OriDagan1/RISCV-MCU-Final-Project/DOC/Screenshots/GPIO test1 counting up.png

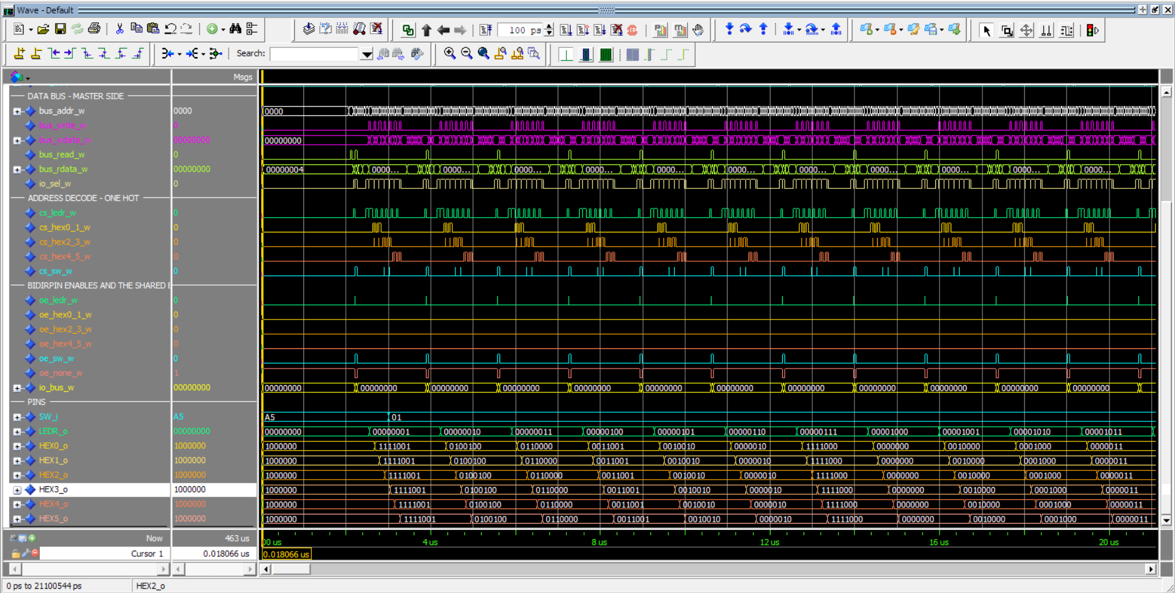
DOC/Screenshots/GPIO test1 counting up.png
