OriDagan1/RISCV-MCU-Final-Project/DOC/Screenshots/GPIO test1 counting down.png

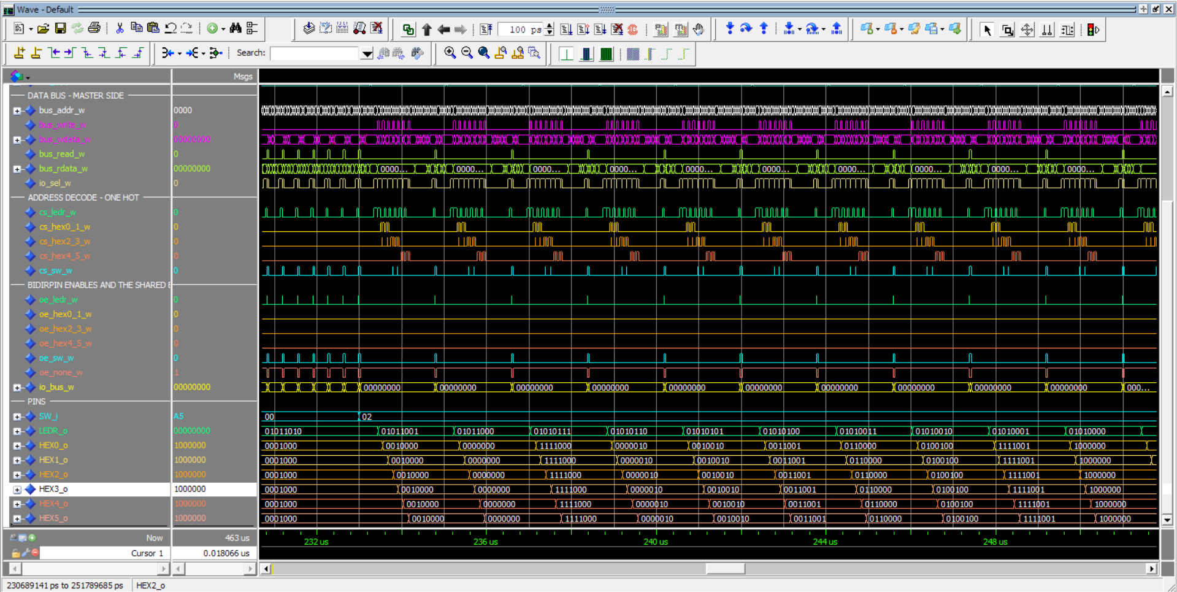
DOC/Screenshots/GPIO test1 counting down.png
