OriDagan1/RISCV-MCU-Final-Project/DOC/pre_final.docx

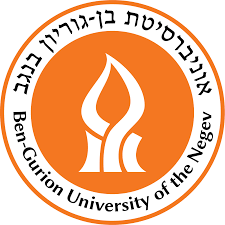
[picture p3: figure]

דו"ח מכין למעבדה מסכמת

מחלקה

המחלקה להנדסת חשמל ומחשבים

שם קורס

מעבדת ארכיטקטורת מעבדים מתקדמת ומאיצי חומרה

361.1.4693

תאריך הגשת הדוח

.08.202631

מגישים-

מאי ג'קסון 212294987

אורי דגן 207698788

תוכן עניינים:

1. מבוא .......................................................................... 3
2. ארכיטקטורת מערכת .................................................... 3
3. התקני קלט/פלט וממשק פריפריאלי ממופה זיכרון .............. 4
4. מאיץ החילוק/שארית וארכיטקטורת מעבר תחומי שעון ....... 7
5. פרוטוקול Interrupt Sequencer ................................... 7
6. סינתזה על גבי FPGA ואפיוןPPA ................................ 7
1. מבוא:

מטרת הפרויקט היא תכנון ומימוש של מערכת MCU המבוססת על מעבד RV32IM על גבי FPGA. המערכת מבוססת על ליבת Single-Cycle בארכיטקטורת Harvard עם זיכרונות נפרדים מסוג ITCM לקוד ו-DTCM לנתונים. במסגרת הפרויקט הורחבה הליבה באמצעות Memory-Mapped I/O, רכיבי GPIO, Basic Timer, בקר פסיקות ומאיץ חומרה רב־מחזורי לביצוע פעולת חילוק. בסיום המימוש בוצעו אימות בסימולציה, בדיקה על גבי ה-FPGA וניתוחי Power, Performance and Area (PPA) באמצעות Quartus.

2. ארכיטקטורת מערכת:

ה-MCU בנוי סביב ליבת RISC-V בעלת מחזור בודד (single-cycle), המחוברת לקבוצת רכיבים פריפריאליים הממופים לזיכרון (memory-mapped) דרך בס משותף פנימי, כפי שמוצג באיור 1. כתובות שהליבה מוציאה מנותבות, דרך לוגיקת ממשק הבס, אם פנימה אל זיכרונות הליבה (ITCM ו-DTCM), ואם מחוץ לטווחם - החוצה אל אחד הרכיבים הפריפריאליים, כל אחד עם ה-Address Decoder ורגיסטרי הממשק שלו. מאיץ חומרה (Accelerator) מחובר ישירות צמוד לליבה ולא דרך הבס הפריפריאלי, שכן הוא מיועד למשימה חישובית ספציפית ומוגדרת מראש. מבנה השעונים נגזר משעון לוח יחיד בתדר 50MHz על ידי Clock Tree, המפיק שלושה תחומי שעון בלתי תלויים: mclk לליבה, smclk לטיימר, ו-acceclk המהיר למאיץ, כאשר אות איפוס rst מופץ לכל התחומים.

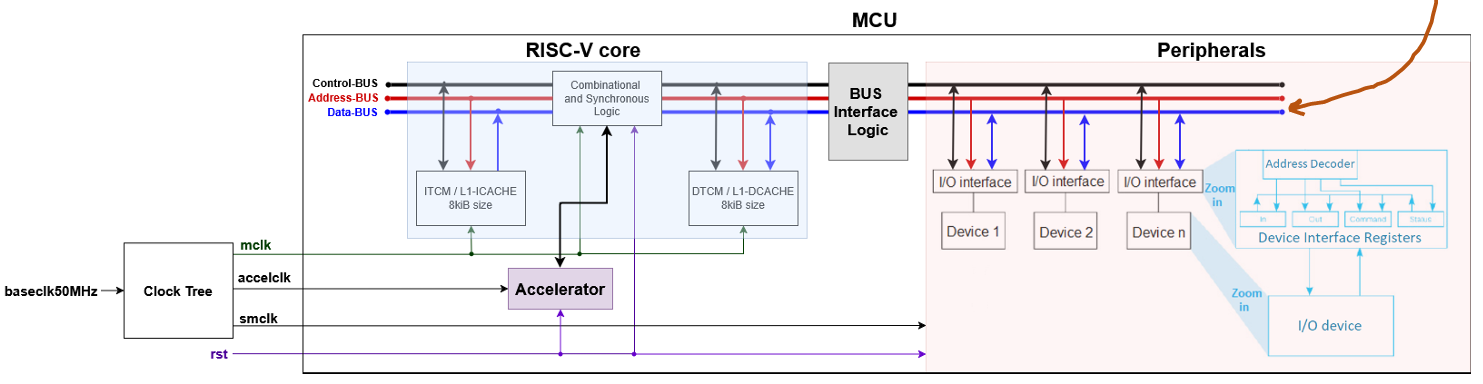
[picture p4: figure]

Figure 1

איור 2 מציג את המבנה הפנימי של הליבה. בהתאם לארכיטקטורת הרווארד, הליבה מחוברת לשני זיכרונות נפרדים: ITCM לסגמנט הקוד ו-DTCM לסגמנט הנתונים. ה-PC מספק את כתובת השליפה ל-ITCM, והפקודה שנשלפת מפוענחת על ידי ה-Control Unit, המפעיל את ה-Register File, ה-ALU ולוגיקת ה-sign extension לביצועה. התקשורת עם ה-DTCM ועם הבס הפריפריאלי מתבצעת דרך שלושה תתי-בסים שהליבה מניעה כ-bus master: בקרה, כתובת ונתונים.

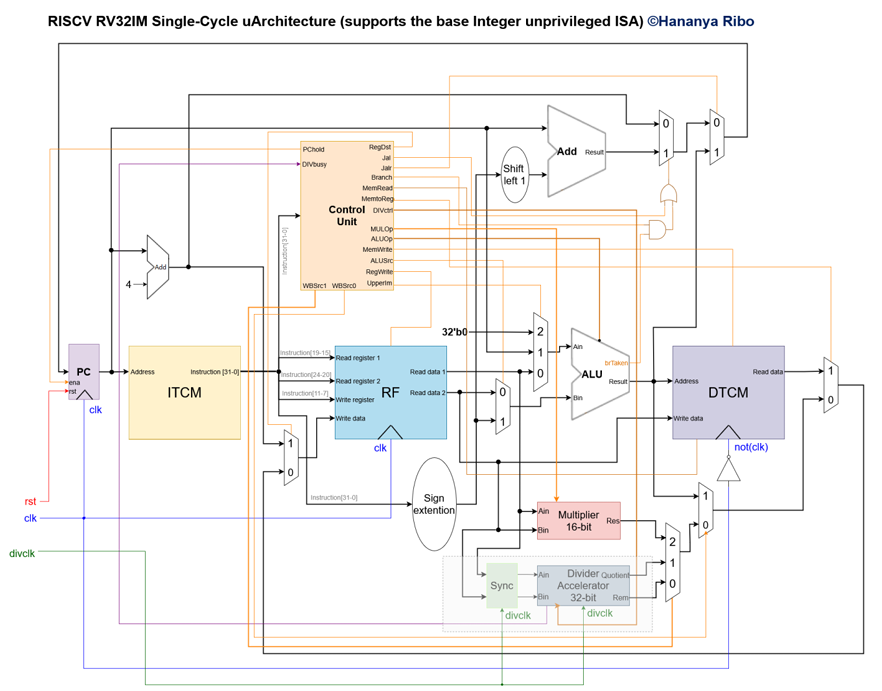
[picture p5: figure]

Figure 2

3. התקני קלט/פלט וממשק פריפריאליים ממופה זיכרון:

התקני קלט/פלט

התכנון משתמש בהתקני הקלט/פלט הבאים על לוח ה-DE10-Standard, בהתאם לדרישות המטלה: שמונה מתגים (SW7-SW0) כממשק קלט, ארבעה לחצנים מסוננים (debounced) (KEY3-KEY0), כאשר KEY0 משמש לאיפוס המערכת ומחזיר את מונה התוכנית לפקודה הראשונה, ו-KEY3-KEY1 זמינים כמקורות פסיקה, שמונה נוריות LED אדומות (LEDR7-LEDR0) כממשק פלט, שישה תצוגות שבע-קטעים (HEX5-HEX0) כממשק פלט נוסף, ופלט ה-PWM של הטיימר הבסיסי (PWMout_o) כממשק פלט נוסף.

מרחב כתובות הנתונים מכתיב שה-DTCM והתקני ה-I/O הממופים לזיכרון חולקים את טווח ה-14 סיביות התחתון, כאשר התקני ה-I/O ממוקמים מעל טווח הכתובות של ה-DTCM עצמו.

GPIO ממופה זיכרון (ללא תמיכה בפסיקות)

שמונת רכיבי ה-GPIO הבאים ממומשים כמפענחים פשוטים עם רגיסטרי חוצץ (buffer registers), הממופים למרחב כתובות הנתונים ככתובות בית:

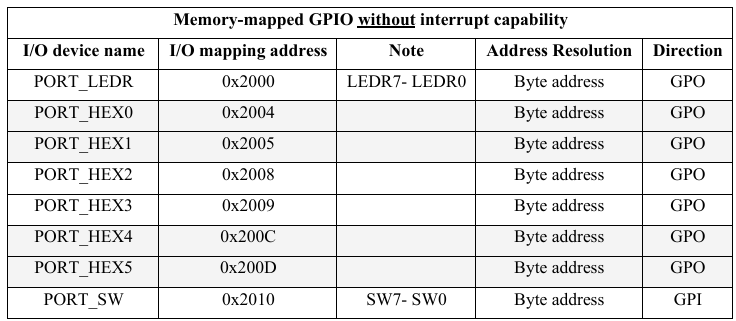
[picture p6: figure]

Figure 3

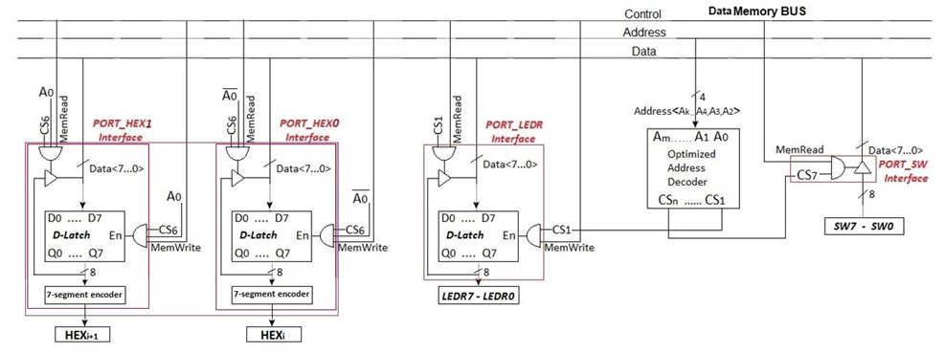
[picture p7: figure]

Figure 4

פריפריאלים ממופי זיכרון עם תמיכה בפסיקות

שלוש קבוצות פריפריאליים נוספות ממופות לזיכרון עם תמיכה בפסיקות: מערך הלחצנים KEY(1-3) הטיימר הבסיסי, ובקר הפסיקות עצמו. רכיב ה-USART הוא חלק מבונוס ה-UART האופציונלי (אנחנו לא מימשנו).

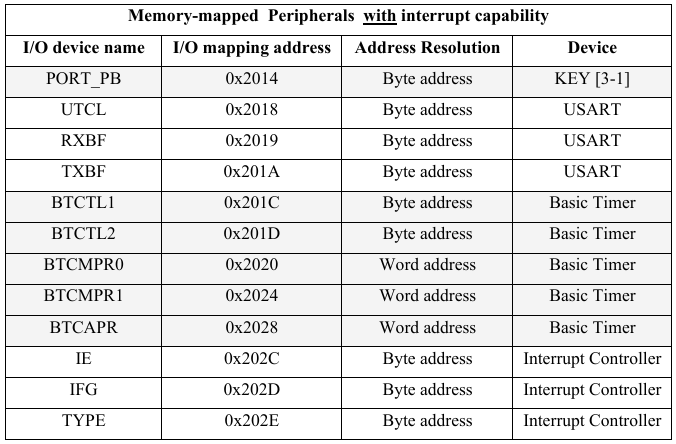
[picture p8: figure]

Figure 5

תיאור פונקציונלי של הטיימר הבסיסי

המונה הרץ בחופשיות (free-running) של הטיימר הבסיסי, BTCNT, מושווה מול זוג רגיסטרי השוואה, BTCL0 ו-BTCL1, הנטענים דרך BTCMPR0/BTCMPR1. רגיסטר הבקרה BTCTL1 קובע את מקור השעון (BTSSEL, מוגדר כאן ל-prescale של חלוקה-ב-8 של smclk) וכן מכיל את BTHOLD להקפאת המונה ו-BTCLR לאיפוסו, לצד זוג הביטים BTOUTMD/BTOUTEN הקובע את אופן ואת כיוון פלט ה-PWM. שני אופני פעולה נבחנים בתוכניות הבדיקה: אופן ההשוואה (compare mode), שבו התאמה בין BTCNT ל-BTCL0 מעלה את דגל הפסיקה במחזוריות הניתנת להגדרה, ואופן פלט ההשוואה (output compare mode), שבו BTCL0 קובע את מחזוריות גל ה-PWM על PWMout ו-BTCL1 קובע את מחזור העבודה שלו. אופן ה-input capture מחווט בתכנון אך אינו נבחן בהגשה זו.

בקר הפסיקות

בקר הפסיקות מממש שלושה רגיסטרים ממופי זיכרון: IE, מסכת הפעלה (enable) לכל מקור פסיקה, IFG. רגיסטר דגלי פסיקה מקובעים (latched) לכל מקור, המנוקה על ידי התוכנה בעקבות רצף read-modify-write על כל דגל בנפרד ו-TYPE, רגיסטר לקריאה בלבד המציג את ה-offset בטבלת הווקטורים של מקור הפסיקה בעל העדיפות הגבוהה ביותר שממתין כרגע ומופעל. מקורות הפסיקה הנתמכים הם התאמת ההשוואה של הטיימר הבסיסי ושלושת לחצני המשתמש KEY1-KEY3, המתווכים על ידי מקודד עדיפות קבועה (fixed-priority encoder) בתוך INTCTRL.

4. מאיץ החילוק/שארית וארכיטקטורת מעבר תחומי שעון

פקודות ה-DIV וה-REM מבוססות על מאיץ חילוק unsigned מסוג multicycle restoring-division, הפועל בתחום שעון עצמאי ומהיר, divclk, ומבצע בכל מחזור שעון צעד אחד של הזזה-חיסור-שחזור עד להשלמת חילוק מלא של מספר N=32 סיביות. מאחר שהמאיץ פועל בתחום שעון שונה מזה של הליבה (mclk), כל אות העובר בין שני התחומים — פולס הבקשה, האופרנדים, דגל ה-busy ותוצאות המנה והשארית — מסונכרן באמצעות מסנכרן דו-שלבי (two-flop synchronizer) בכיוון היעד, המונע מטה-יציבות (metastability). כל עוד דגל ה-busy מורם, הליבה ממתינה (Hold) לסיום הפעולה; עם ירידתו, התוצאה נכתבת בחזרה (Write-Back) והביצוע ממשיך לפקודה הבאה.

5. פרטוקול Interrupt Sequencer Protocol:

טבלת וקטורי הפסיקה היא טבלה בת שמונה כניסות ב-DTCM, המאונדקסת לפי ערך ה-TYPE שמציג בקר הפסיקות (INTCTRL), כאשר כל כניסה מחזיקה את כתובת ה-handler של מקור הפסיקה המתאים, וה-INTCTRL מתעדף מקורות פעילים בו-זמנית לפי סדר עדיפות קבוע. כניסה לפסיקה מבוצעת על ידי רצף חומרה קטן, INTSEQ, בשני מחזורי mclk: במחזור הראשון נקלטת כתובת החזרה האמיתית של הפקודה המופסקת (תוך התחשבות במקרה שבו זו עצמה פקודת קפיצה או הסתעפות שבוצעה) וביט ה-GIE (Global Interrupt Enable) מתאפס כדי לחסום פסיקות נוספות בזמן הטיפול; במחזור השני נקראת טבלת הווקטורים ומונה התוכנית מנותב לכתובת ה-handler המתאימה. חזרה מפסיקה מתבצעת באמצעות פקודת קפיצה רגילה אל כתובת ההחזרה השמורה, אשר מזוהה גם כפעולת reti ייעודית, שתפקידה הנוסף היחיד הוא להחזיר את GIE לערכו המקורי ולאפשר מחדש זיהוי פסיקות מהמחזור הבא ואילך.

6. סינתזה על גבי FPGA ואפיון PPA:

בחלק זה מוצגות תוצאות הסינתזה והניתוח שבוצעו באמצעות Quartus עבור שתי תצורות המערכת הנדרשות בפרויקט: MCU עם רכיבי GPIO בלבד, ו-MCU עם GPIO ותמיכה בפסיקות, הכוללת את רכיבי ה־Pushbuttons, ה־Basic Timer, בקר הפסיקות ומנגנון הטיפול בפסיקה. שתי התצורות קומפלו עבור רכיב ה־Cyclone V 5CSXFC6D6F31C6 המותקן על לוח ה-DE10 Standard, תוך שימוש בהקצאות הפינים המתאימות. בהמשך מוצגים ומנותחים נתוני ה-Area, Performance ו-Power של המערכת.

MCU with GPIO:

Logic Report:

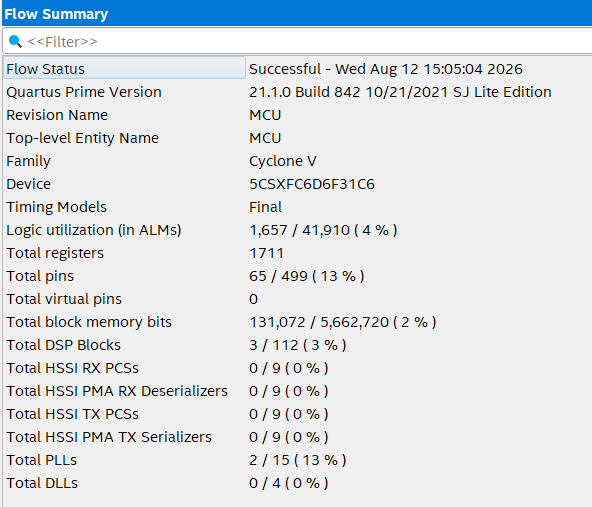
[picture p9: figure]

Figure 6

Maximum Frequency:

Figure 7

Critical Path:

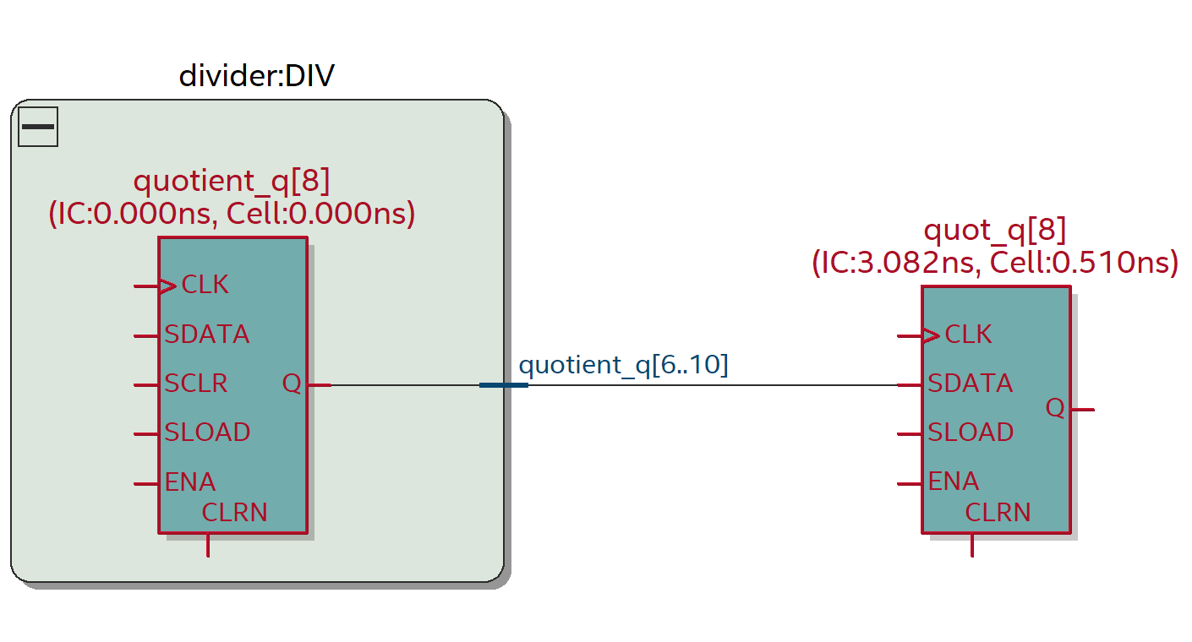
[picture p10: figure]

Figure 8

Power Analysis:

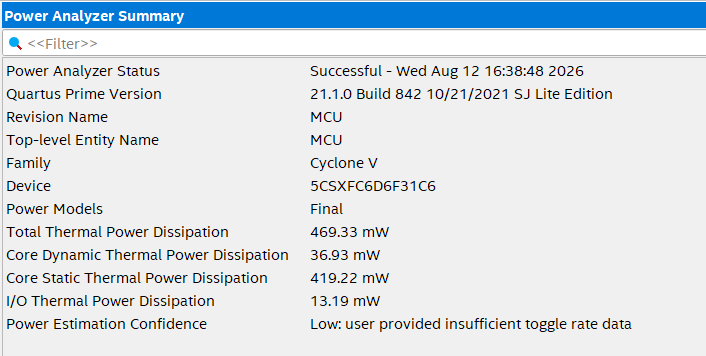
[picture p11: figure]

Figure 9

MCU with GPIO and Interrupt Capability:

RTL viewer:

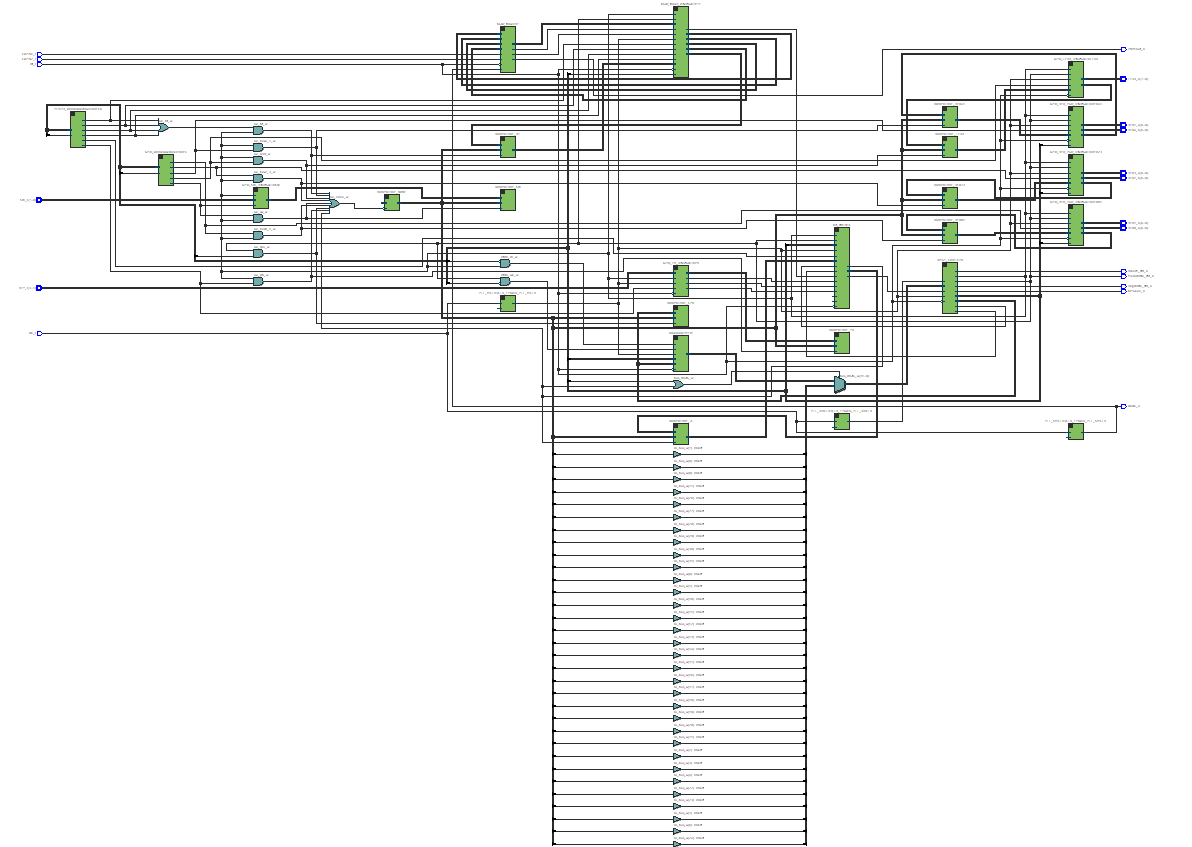
[picture p12: figure]

Figure 10

Logic Report:

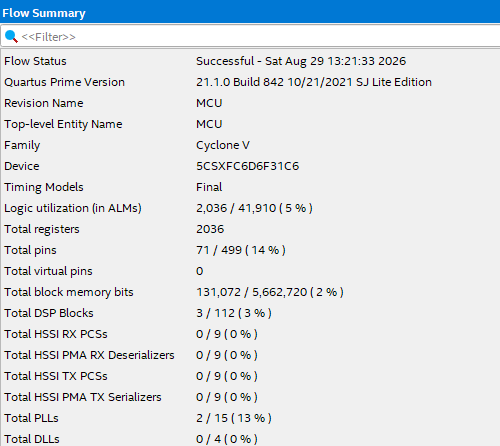
[picture p13: figure]

Figure 11

Maximum Frequency:

Figure 12

Critical Path:

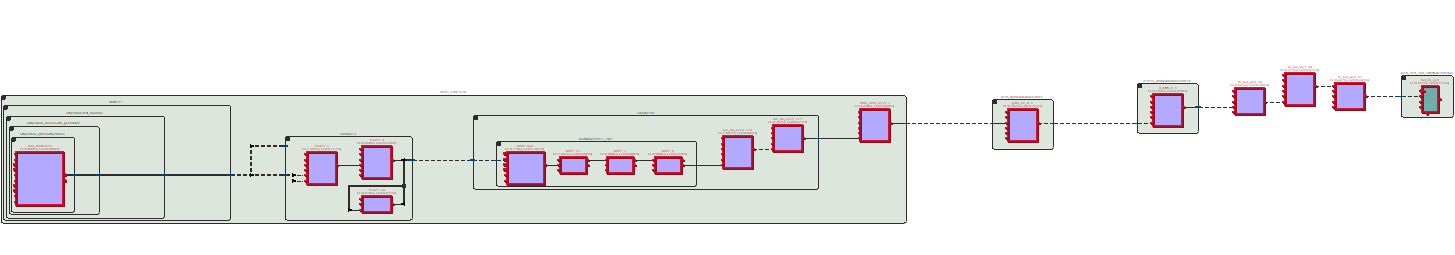
[picture p14: figure]

Figure 13

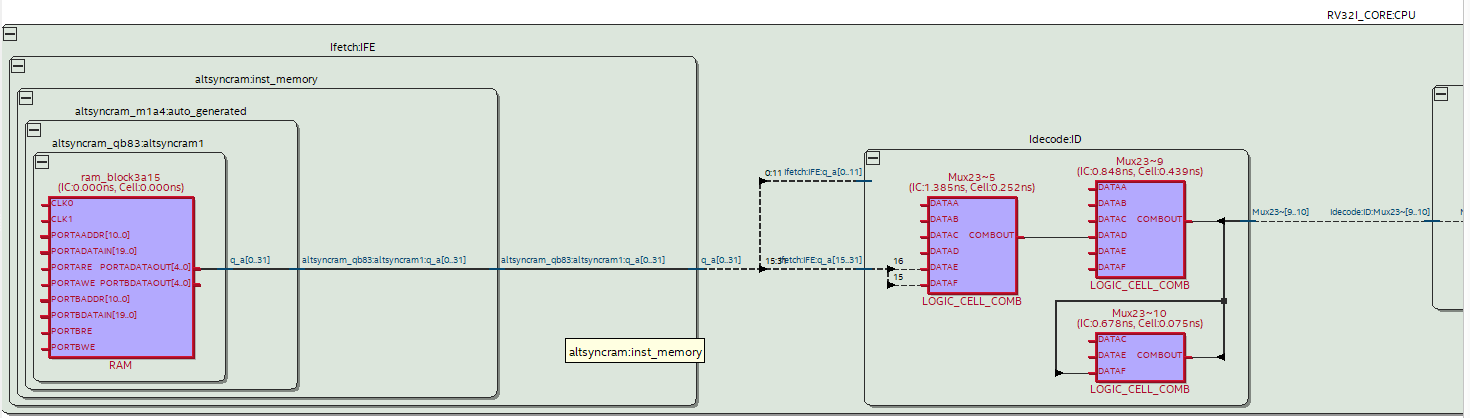
[picture p15: figure]

Figure 14

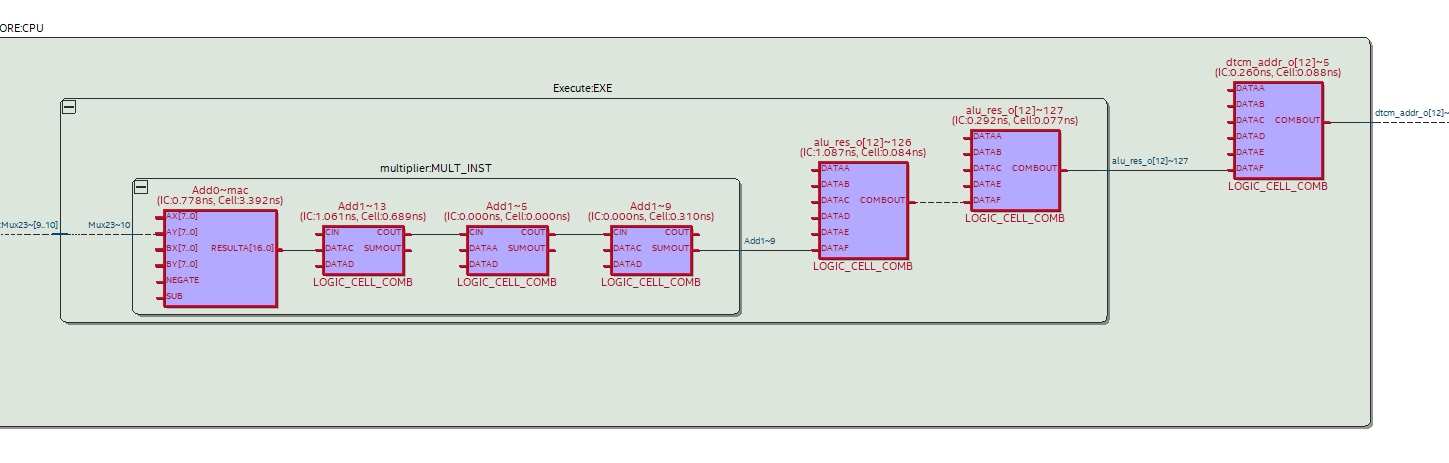
[picture p16: figure]

Figure 15

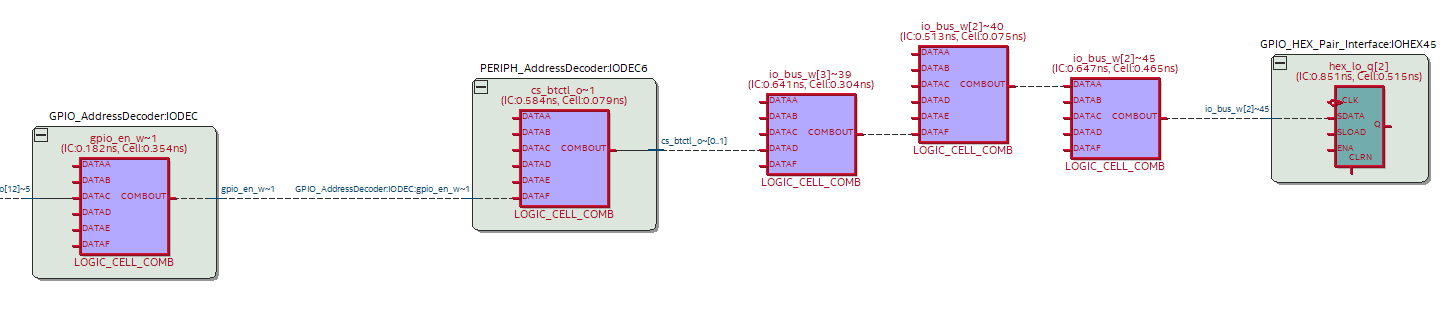
[picture p17: figure]

Figure 16

Power Analysis:

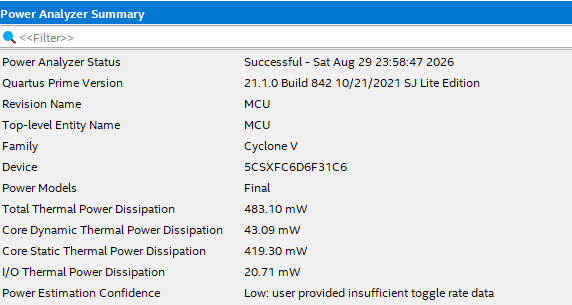
[picture p18: figure]

Figure 17

Internal RTL Views:

Interrupt controller:

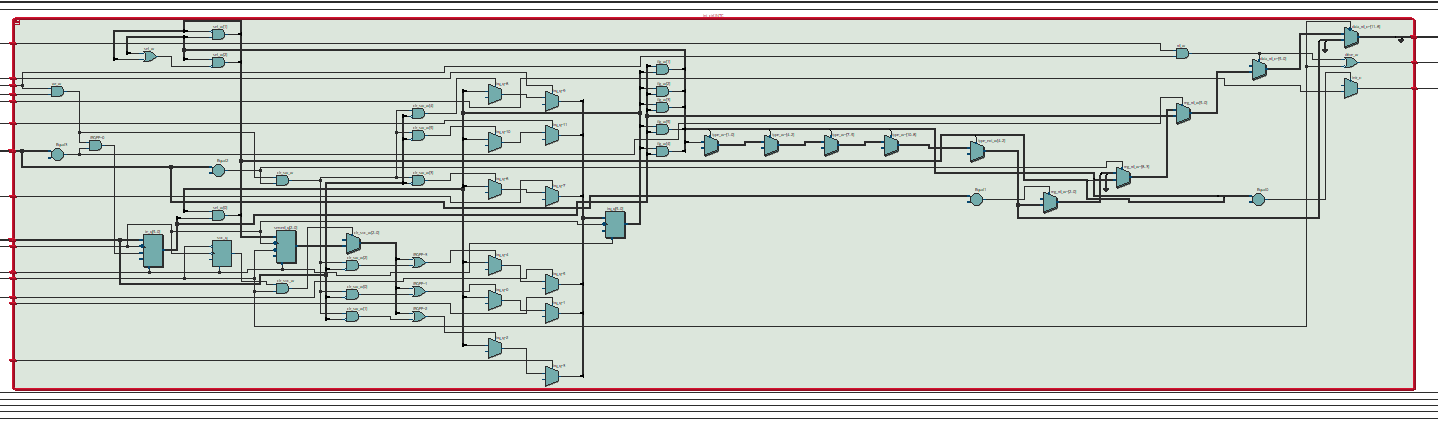
[picture p19: figure]

Figure 18

CPU:

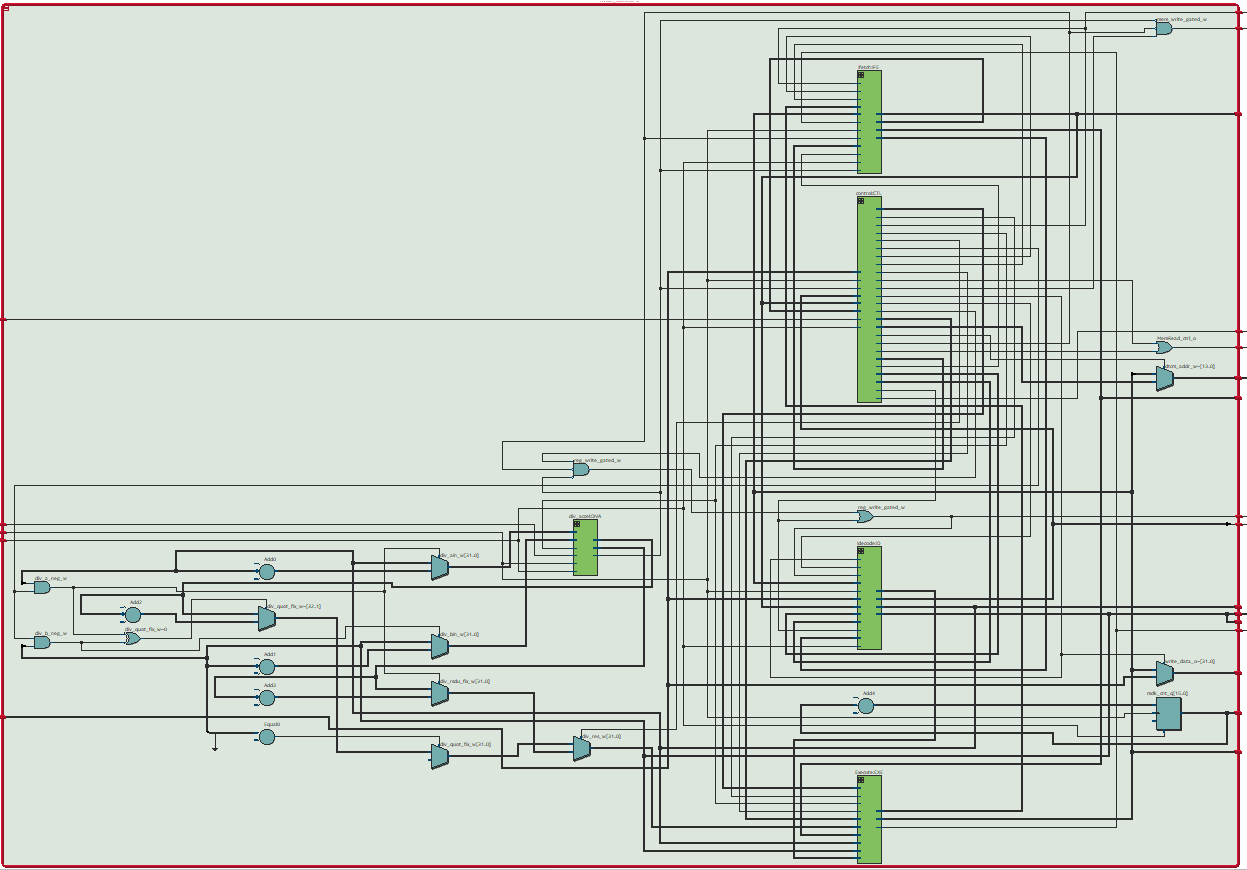
[picture p20: figure]

Figure 19

Divider Accelerator:

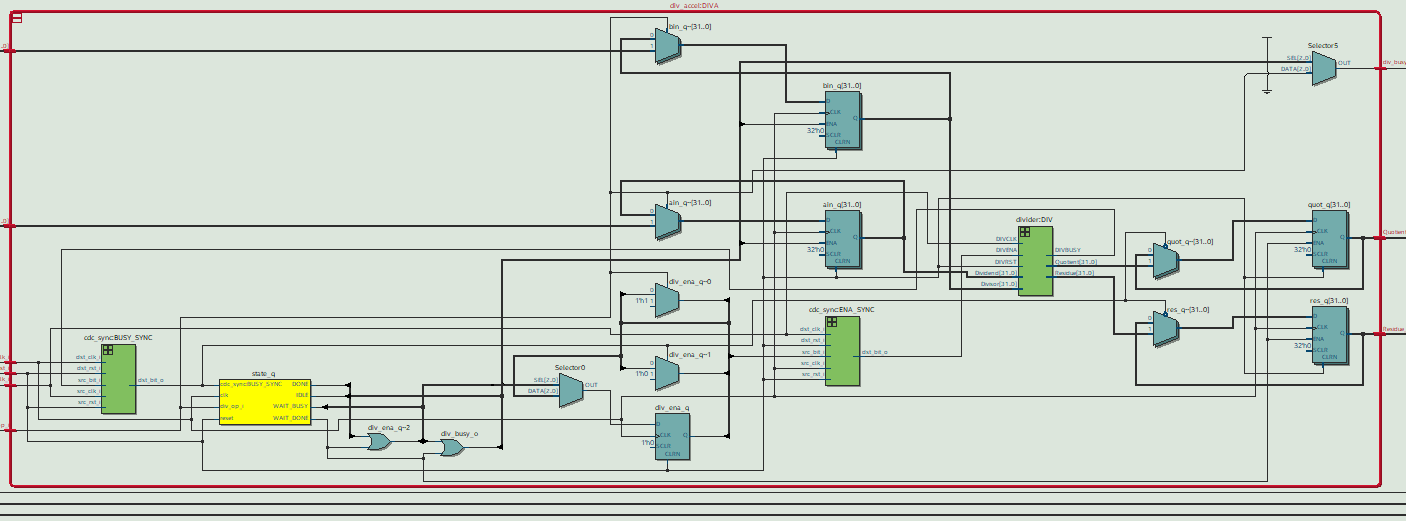
[picture p21: figure]

Figure 20

Dividing module:

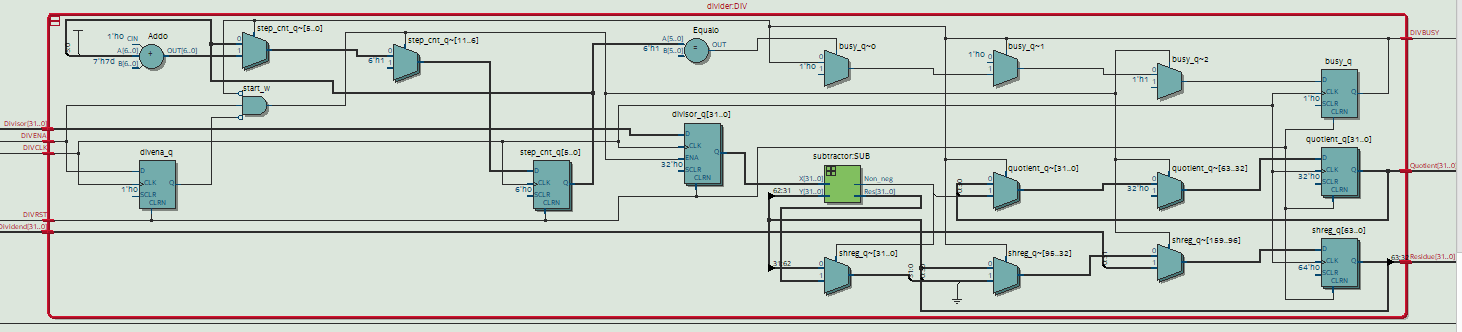
[picture p22: figure]

Figure 21

GPIO:

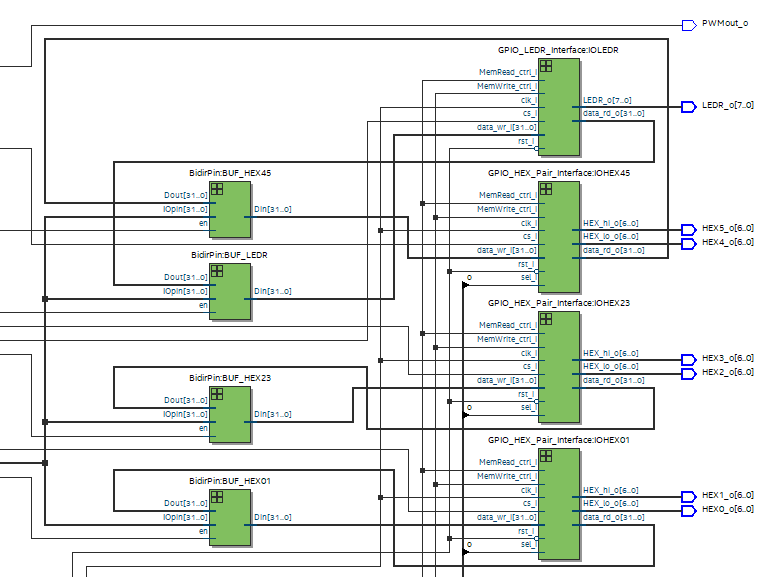
[picture p23: figure]

Figure 22

Basic Timer:

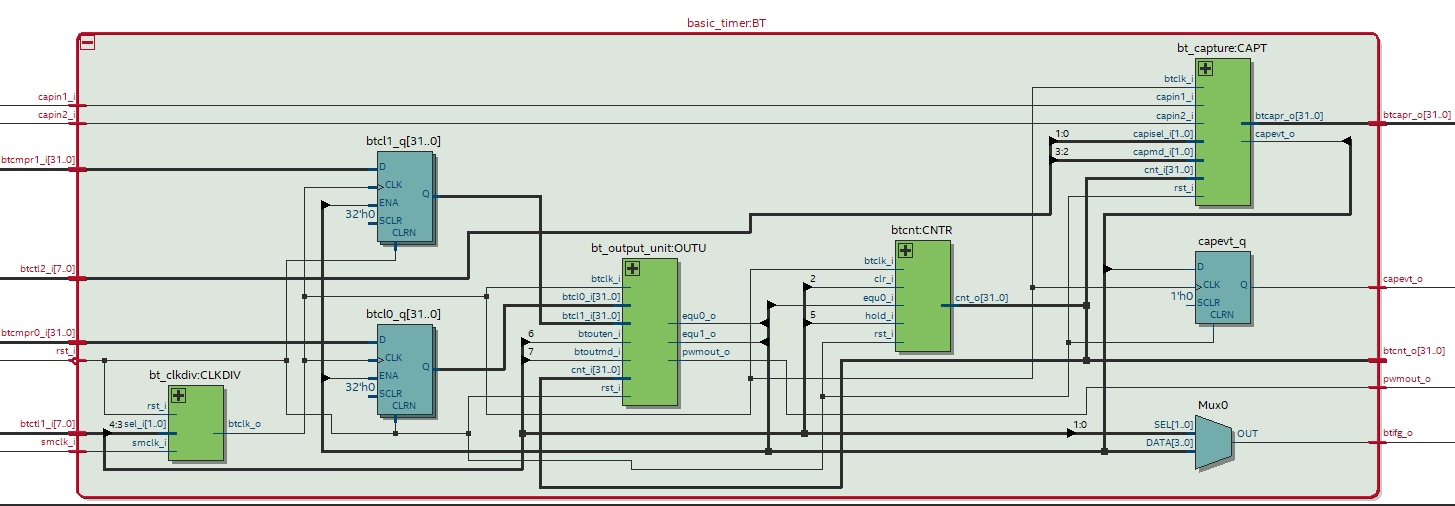
[picture p24: figure]

Figure 23

PPA Characterization Summary:

Area:

PLLs | Embedded 9-bit Multipliers | Embedded memory bits | I/O pins | Registers | Logic elements
2 | 3 | 131072 | 65 | 1711 | 1657 | MCU with GPIO
2 | 3 | 131072 | 71 | 2036 | 2036 | MCU with GPIO and Interrupt Capability

Performance:

f_MCLK(=f_sysclk) | Critical path | f_max
25 MHz | Divider | 101.35 MHz | MCU with GPIO
25 MHz | GPIO HEX pair interface | 83.67 MHz | MCU with GPIO and Interrupt Capability

Power:

I/O power consumption | Dynamic power consumption | Static power consumption | Total power consumption
13.19 mW | 36.93 mW | 419.22 mW | 469.33 mW | MCU with GPIO
20.71 mW | 43.09 mW | 419.30 mW | 483.10 mW | MCU with GPIO and Interrupt Capability

ניתוח דיאגרמות גלים ו-Signal Tap:

GPIO and RV32IM:

Test 1 RT32IM

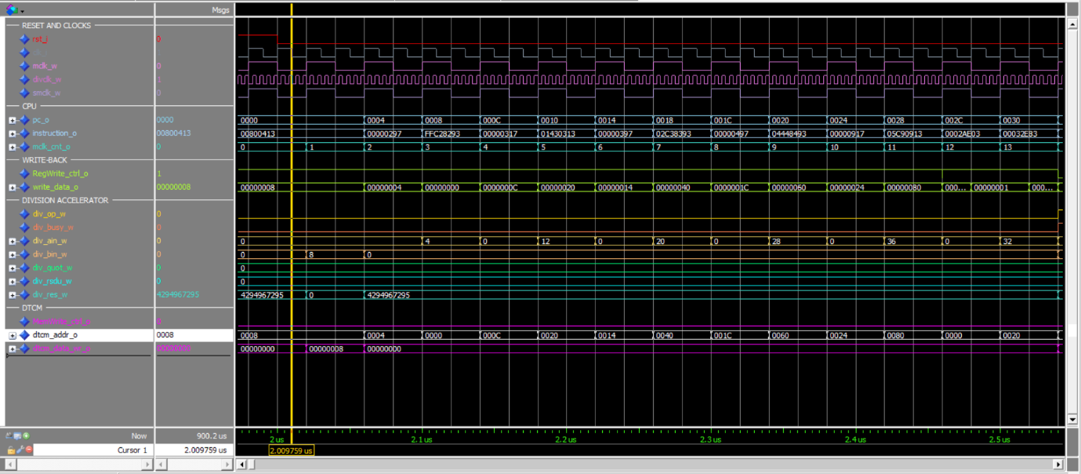
[picture p25: figure]

Figure 24

בדיאגרמה ניתן לראות את התקדמות ה-PC וביצוע פקודות הלולאה של Test 1 , הטוענת איברים משני מערכי הקלט ומבצעת עליהם פעולות DIV, MUL ו-REM.

במקביל נראים אותות מאיץ החילוק וגישות ה-DTCM, המעידים על העברת האופרנדים למאיץ וכתיבת תוצאות החישוב לזיכרון.

Test 0 GPIO

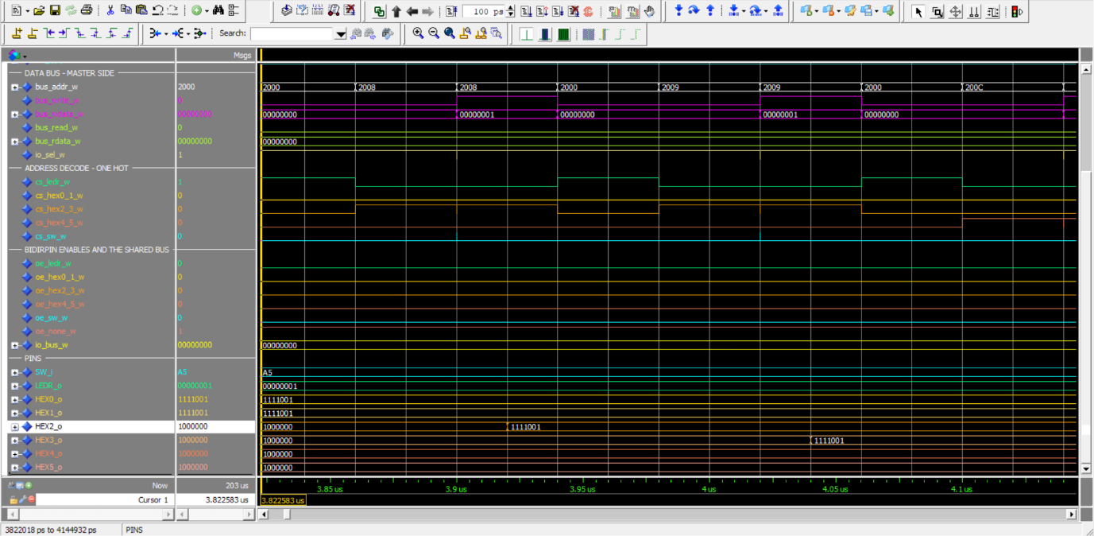
[picture p26: figure]

Figure 25

בדיאגרמת הגלים של Test 0 – GPIO ניתן לראות שכתובות ה-GPIO על ה-Data Bus מפוענחות נכון, כך שבכל גישה מופעל אות ה-CS המתאים ומתבצעת כתיבה תקינה ל-LEDR ולתצוגות ה-HEX.

Test 1 GPIO

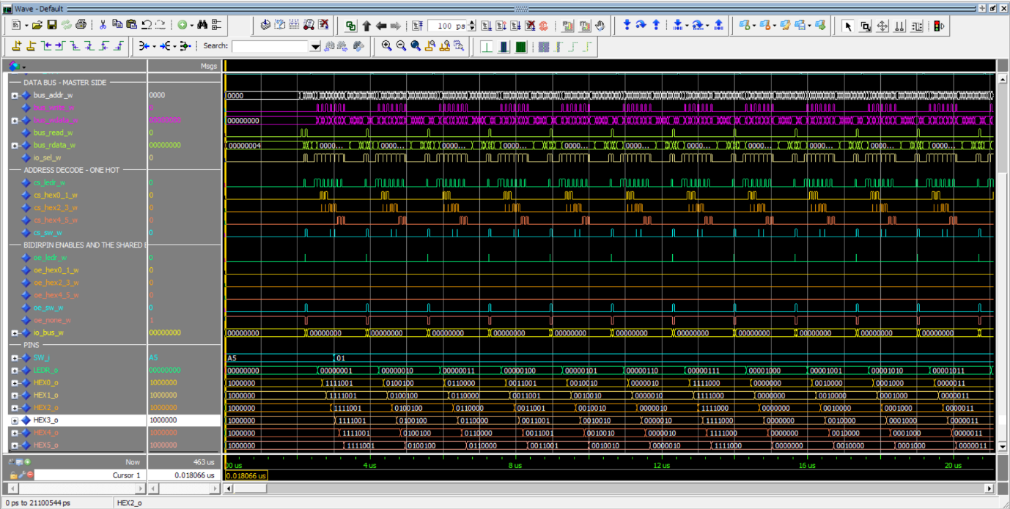
[picture p27: figure]

Figure 26

Figure 27

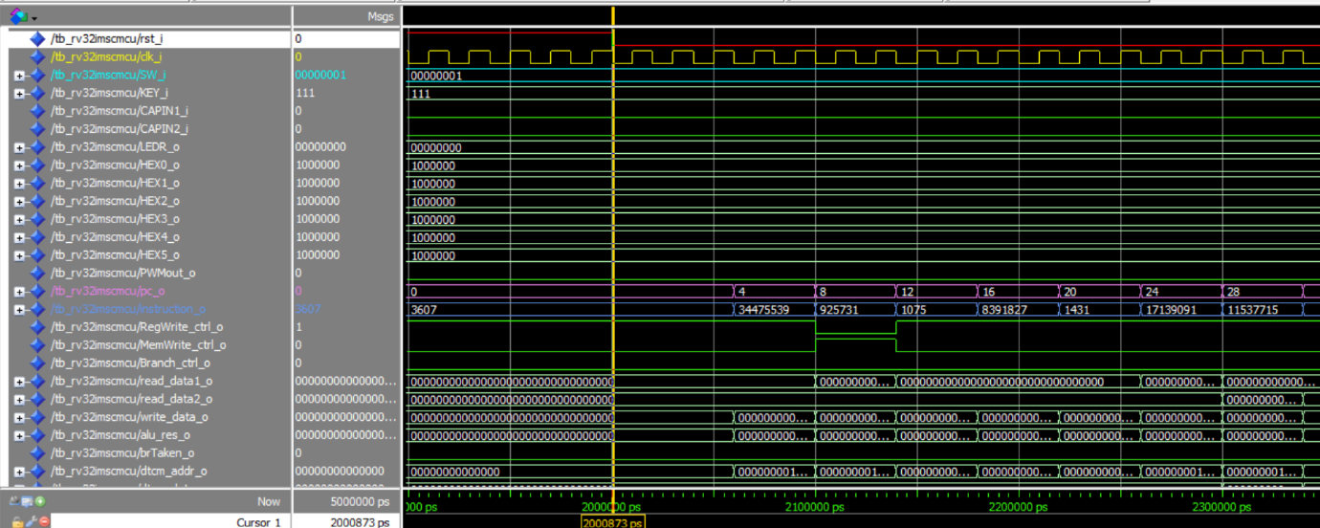
[picture p28: figure]

Figure 28

Test 2 GPIO

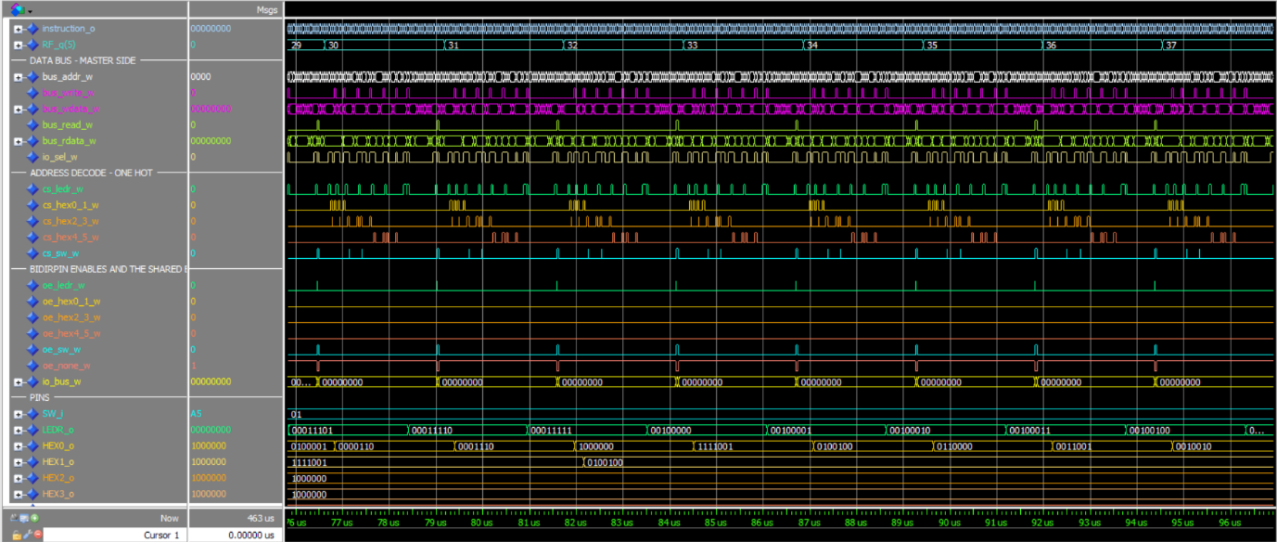
[picture p29: figure]

Figure 29

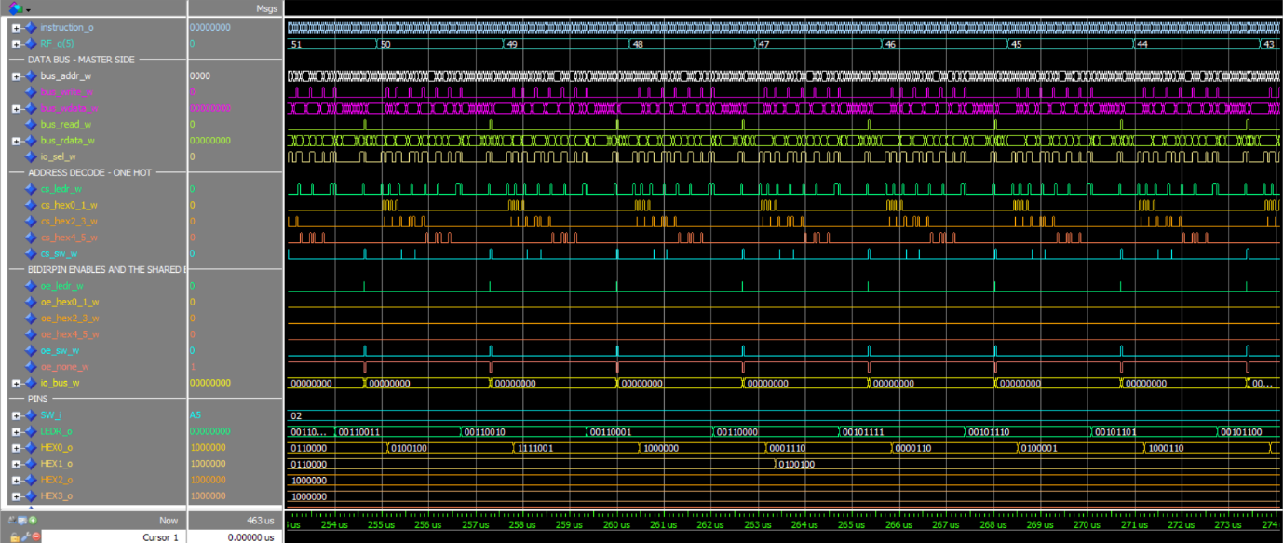
[picture p30: figure]

Figure 30

Signal Tap:

Test 0 GPIO

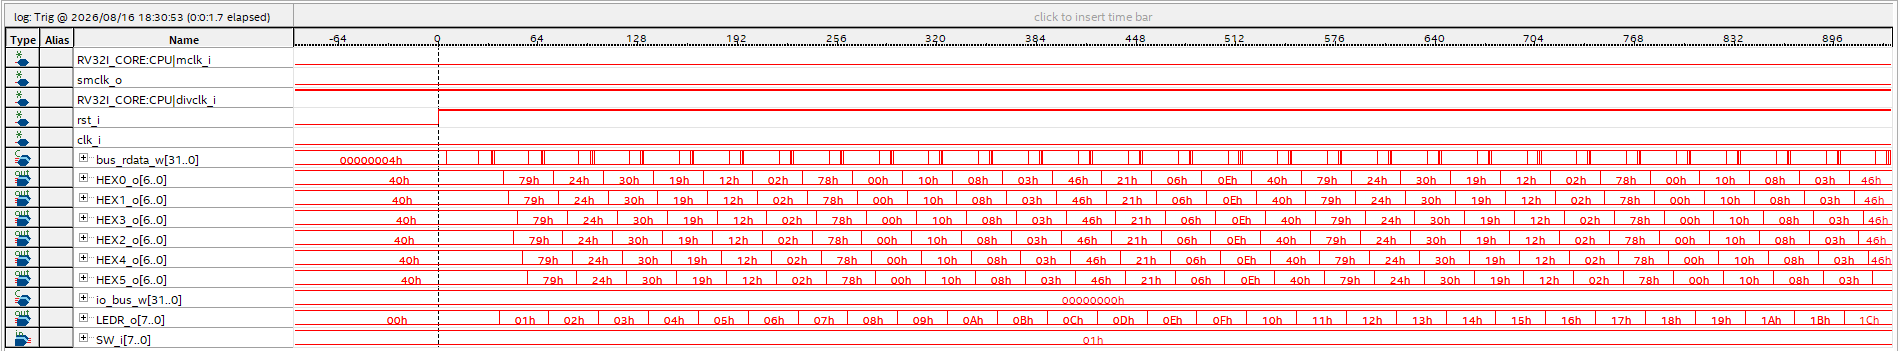
[picture p31: figure]

Figure 31

Test 1 GPIO

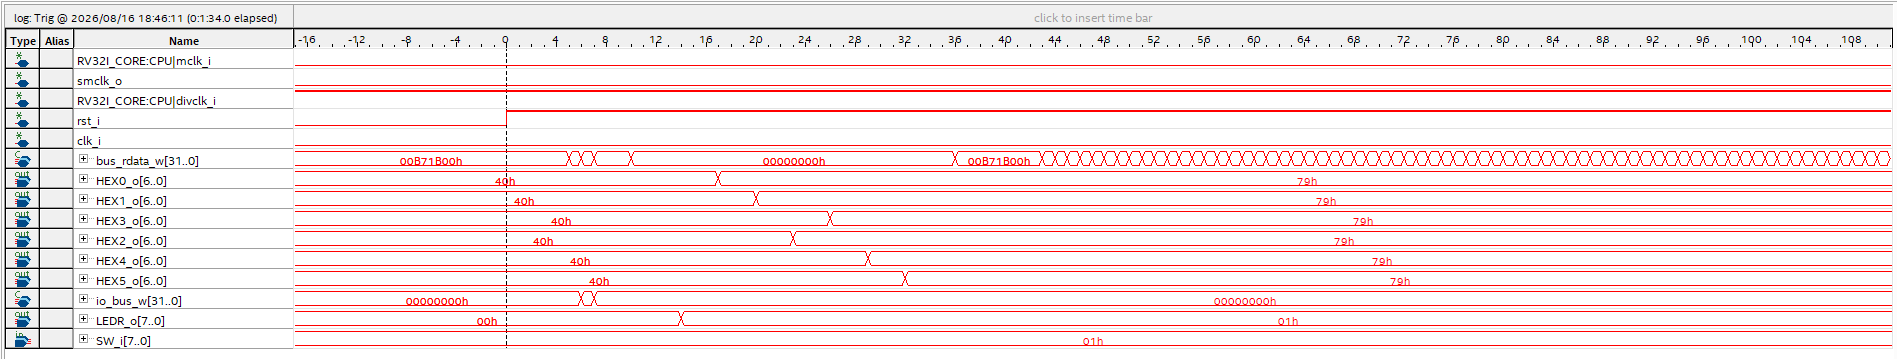
[picture p32: figure]

Figure 32

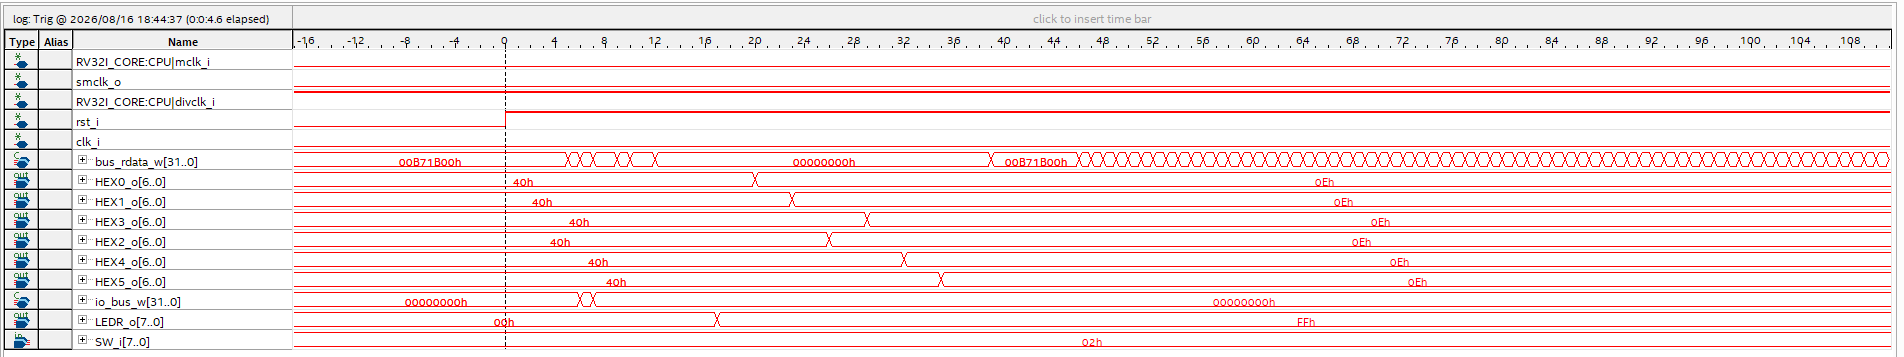
[picture p33: figure]

Figure 33

Test 2 GPIO

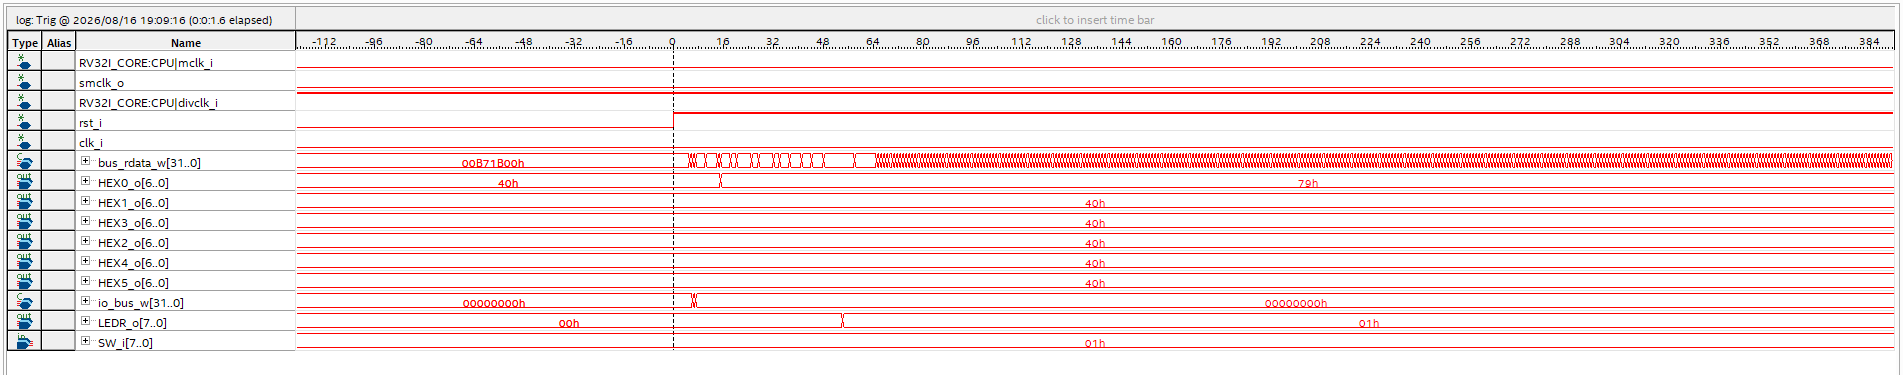
[picture p34: figure]

Figure 34

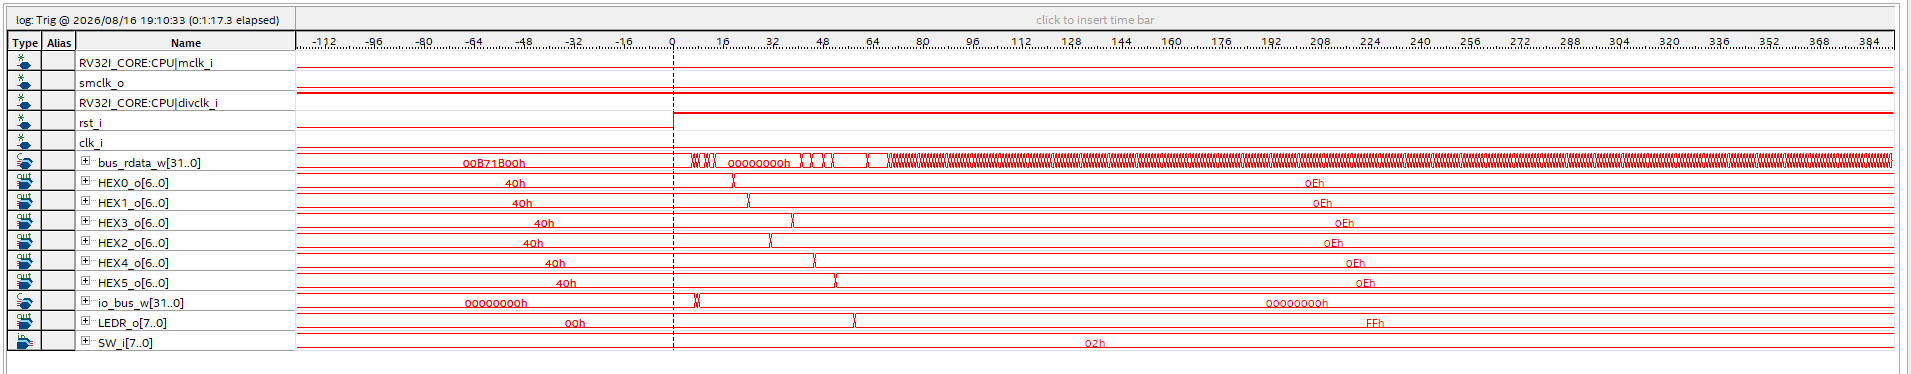
[picture p35: figure]

Figure 35

Interrupt-based I/O:

Test 1:

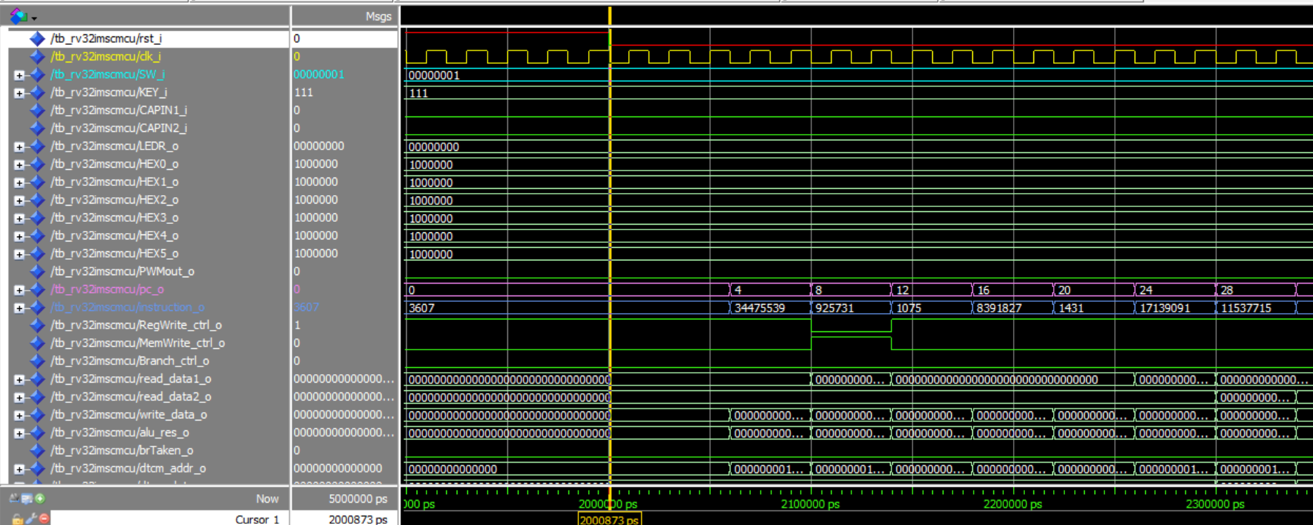
[picture p36: figure]

Figure 36

בין 0-2 µs,ה- rst_i נמצא ב-1, ולכן המערכת מוחזקת במצב Reset וה-PC נשאר בכתובת ההתחלתית. ב-2 µs ,ה-Testbench משחרר את ה-Reset ומוריד את rst_i ל-0. זמן קצר לאחר מכן, לאחר סנכרון ה-Reset לשעון הפנימי MCLK, ניתן לראות שה-PC מתחיל להתקדם בקפיצות של 4 בתים (0, 4, 8, 12, ...), כלומר המעבד מתחיל לבצע את הוראות test1. במקביל SW0=1 כנדרש להפעלת הפסיקות בטסט, KEY_i=111 מציין שכל הלחצנים משוחררים, ו-LEDR_o=00000000 וכל תצוגות ה-HEX מאופסות בתחילת ההרצה.

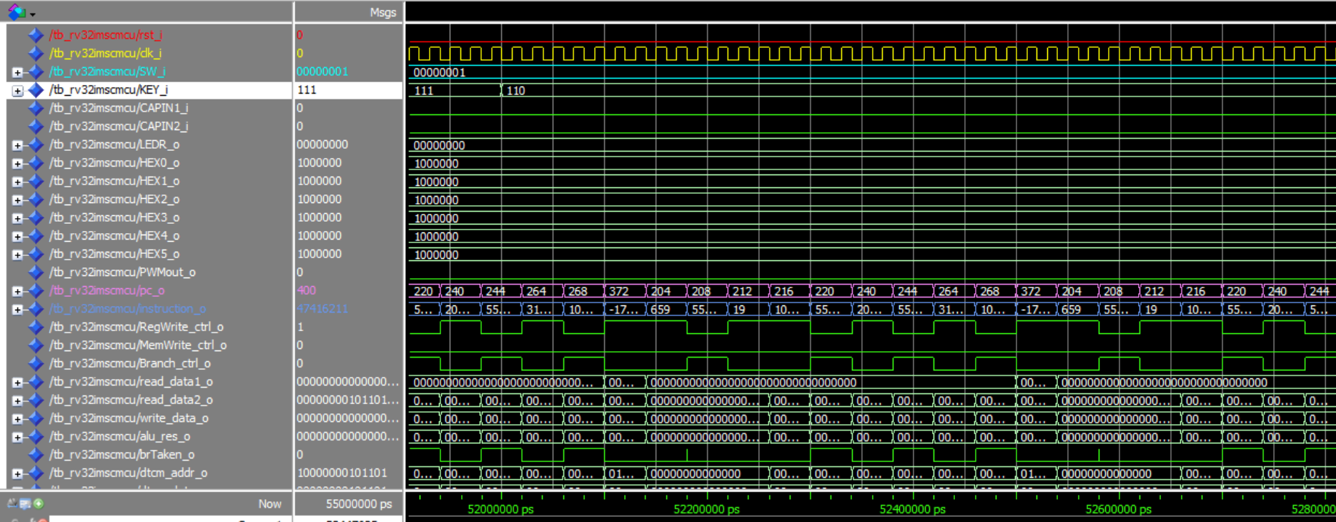
[picture p37: figure]

Figure 37

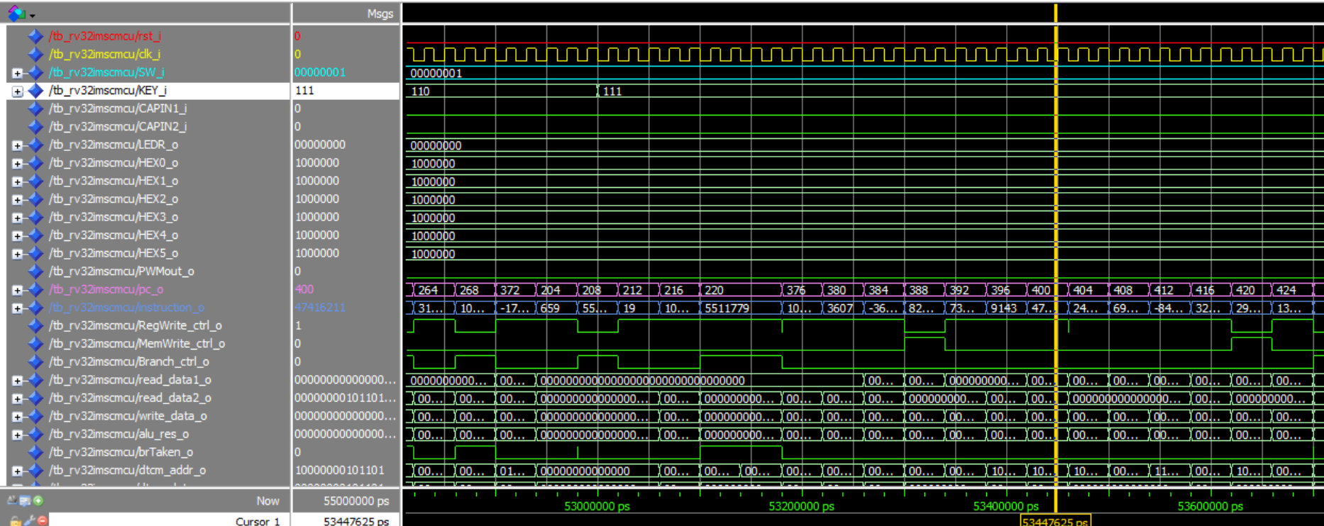
[picture p38: figure]

Figure 38

ב-52 µs ה-Testbench מדמה לחיצה על KEY1. מאחר שהלחצנים הם active-low, הערך של KEY_i משתנה מ-111 ל-110, כלומר KEY1 יורד מ-1 ל0. לאחר 1 µs, ב-53 µs ה-Testbench מדמה את שחרור הלחצן ולכן KEY_i חוזר מ-110 ל111. המעבר של KEY1 מ-0 ל-1 הוא האירוע שמייצר את בקשת הפסיקה במימוש, ולאחריו ניתן לראות שינוי בזרימת ה-PC המעיד על מעבר המעבד למסלול הטיפול בפסיקה. לאחר סיום ה-ISR התוכנית אמורה להציג את הערך הראשון שלarr1, כלומר 0x64, על HEX5:HEX4. (זה הסבר על שתי הדיאגרמות מעל, טסט 1)

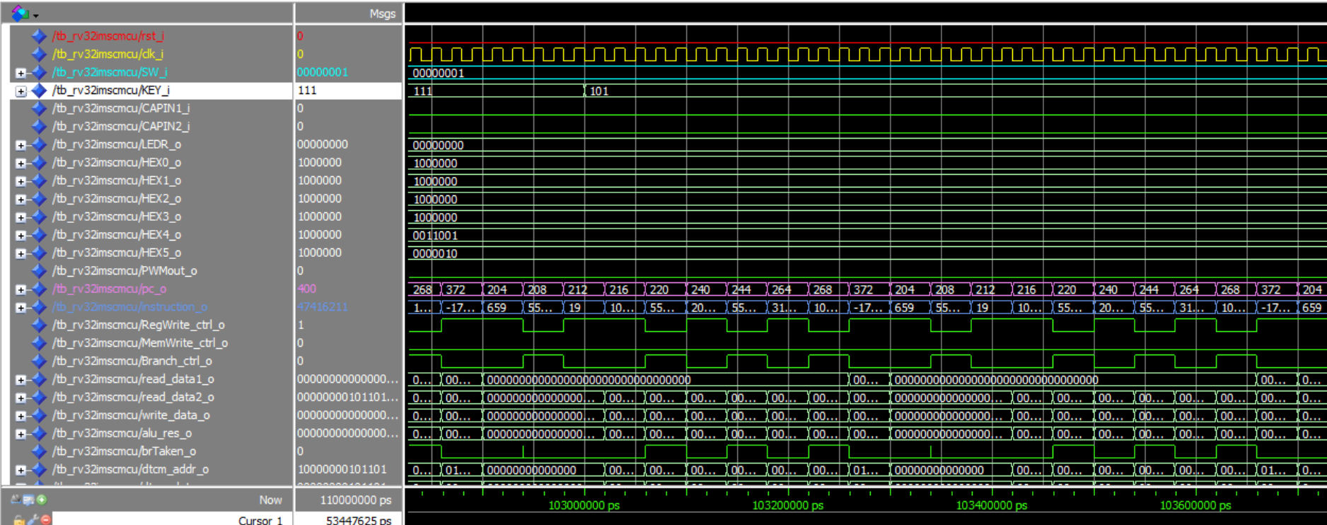
[picture p39: figure]

Figure 39

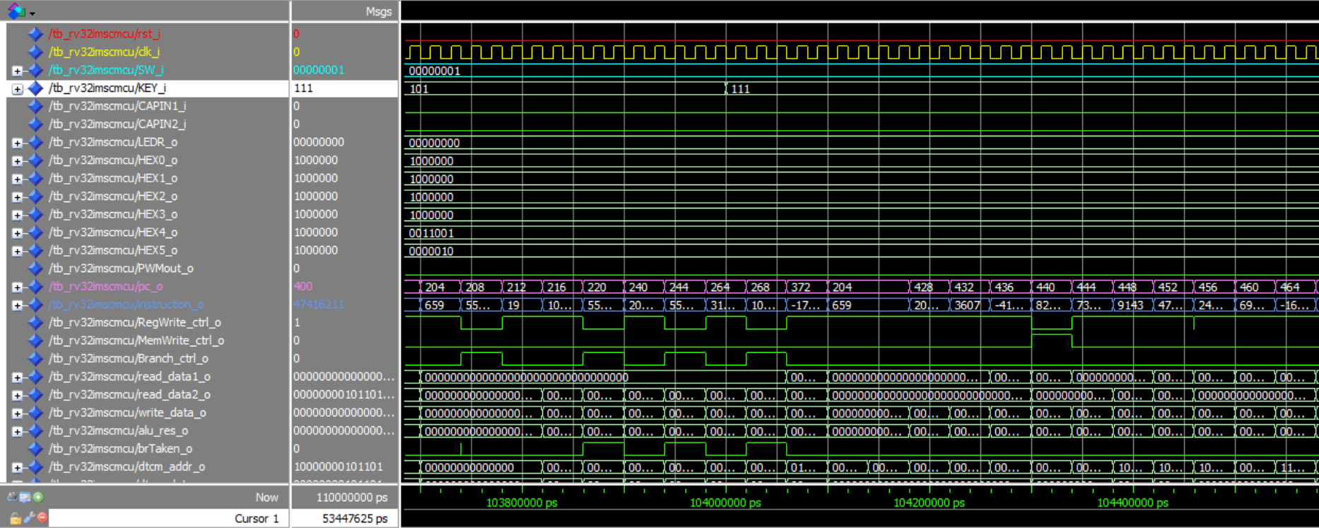
[picture p40: figure]

Figure 40

ב-103 µs ה-Testbench מדמה לחיצה על KEY2, ולכן מאחר שהלחצנים הם active-low, KEY_i משתנה מ-111 ל-101, כלומר KEY2 יורד מ-1 ל-0. לאחר 1 µs, סביב 104 µs, הלחצן משתחרר ו-KEY_i חוזר ל-111, המעבר 0→1 של KEY2 הוא אירוע בקשת הפסיקה. במקביל ניתן לראות שינוי בזרימת ה-PC מהלולאה הרגילה לאזור קוד אחר, התואם כניסה למסלול הטיפול בפסיקה. בנוסף, עוד לפני אירוע KEY2, ה-HEX5 וה-HEX4 כבר מחזיקים את קידודי ה-seven segment , כלומר תוצאת KEY1 הקודמת הייתה 0x64 כנדרש. שתי הודעות ה-Error ב-Transcript אינן תואמות להתנהגות הנראית בפועל ונובעות ממנגנון הניטור של ה-TB ולכן אנחנו מתקנים אותו כעת.

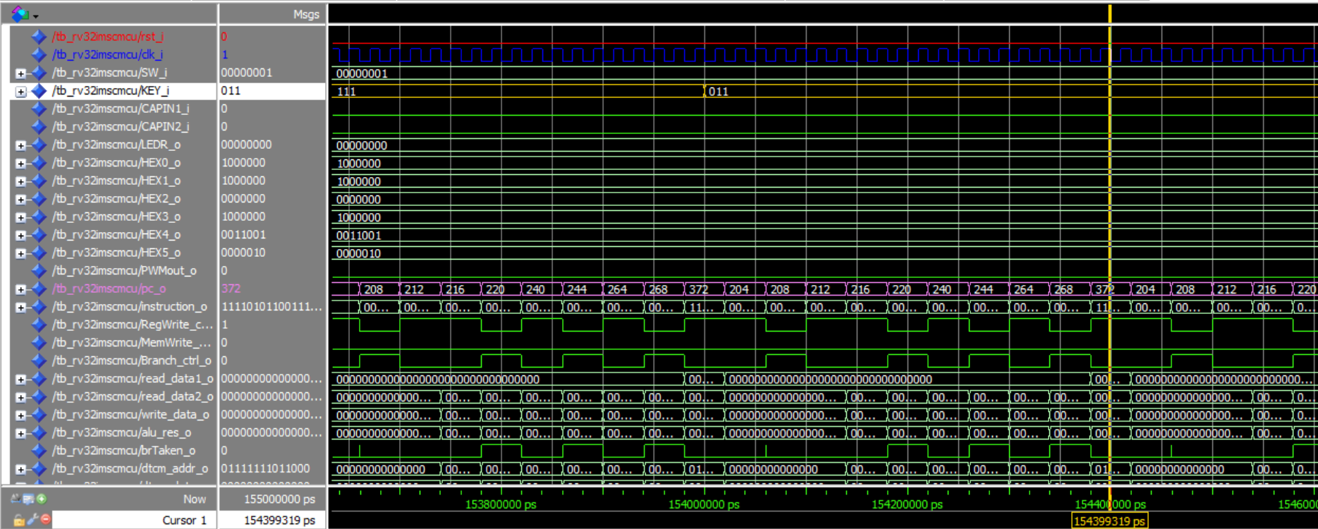
[picture p41: figure]

Figure 41

ב-154 µs ה-Testbench מדמה לחיצה על KEY3, ולכן KEY_i משתנה מ-111 ל-011, בהתאם לכך שהלחצנים הם active-low. בשלב זה הפסיקה עדיין לא נוצרת, משום שהיא מופעלת רק בשחרור הלחצן במעבר 0→1. לכן HEX5:HEX4 עדיין מציגים את הערך 0x64 שהתקבל קודם בעקבות KEY1 ושאר תוצאות ה-DIV/REM טרם הופיעו.

Test 2:

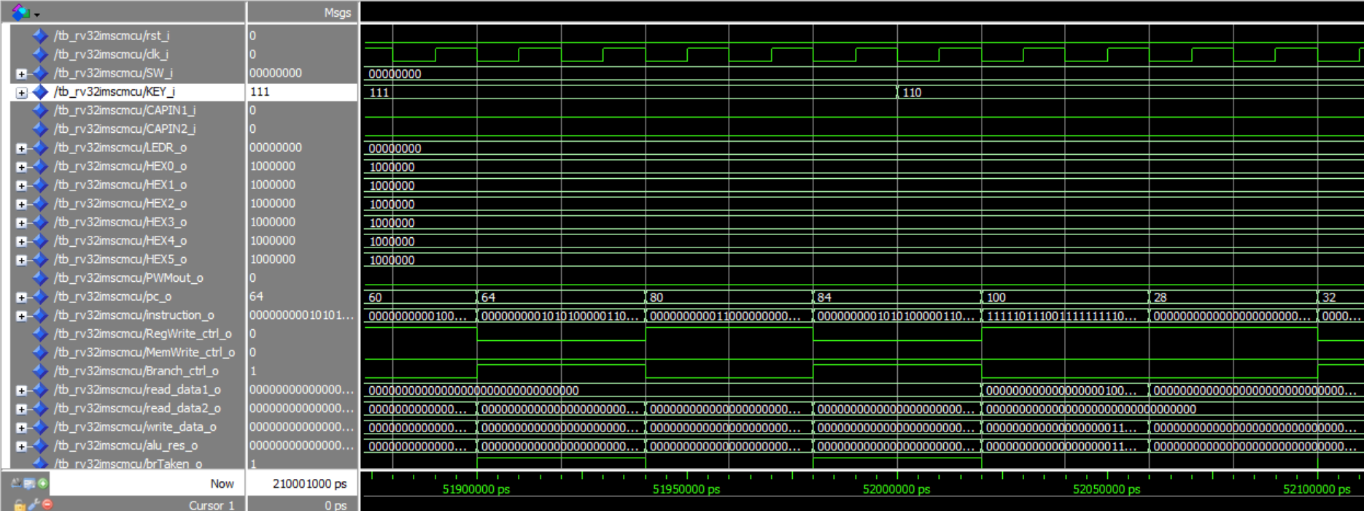
[picture p42: figure]

Figure 42

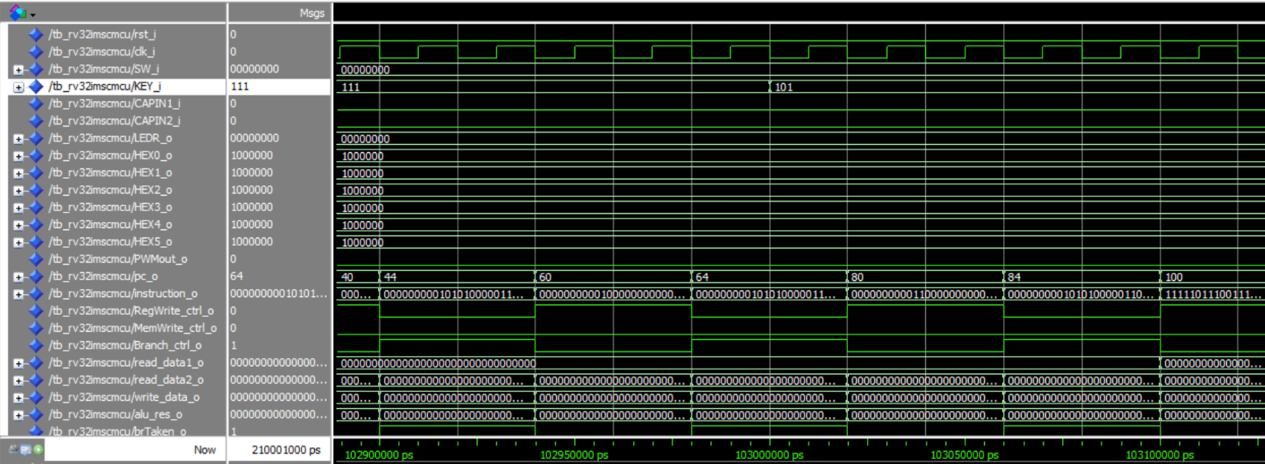
[picture p43: figure]

Figure 43

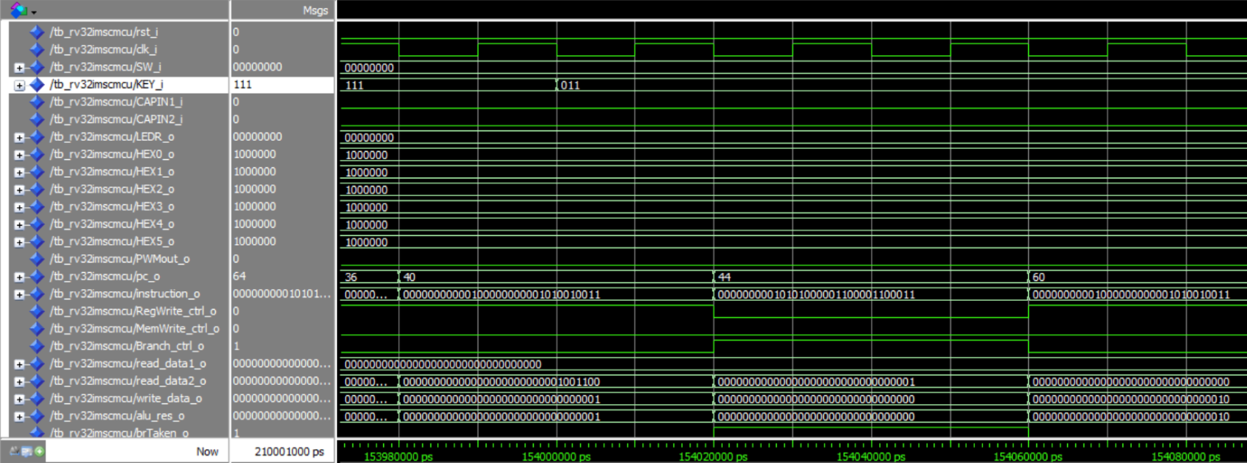
[picture p44: figure]

Figure 44

~52 us KEY1: 111 → 110 → 111

~103 us KEY2: 111 → 101 → 111

~154 us KEY3: 111 → 011 → 111

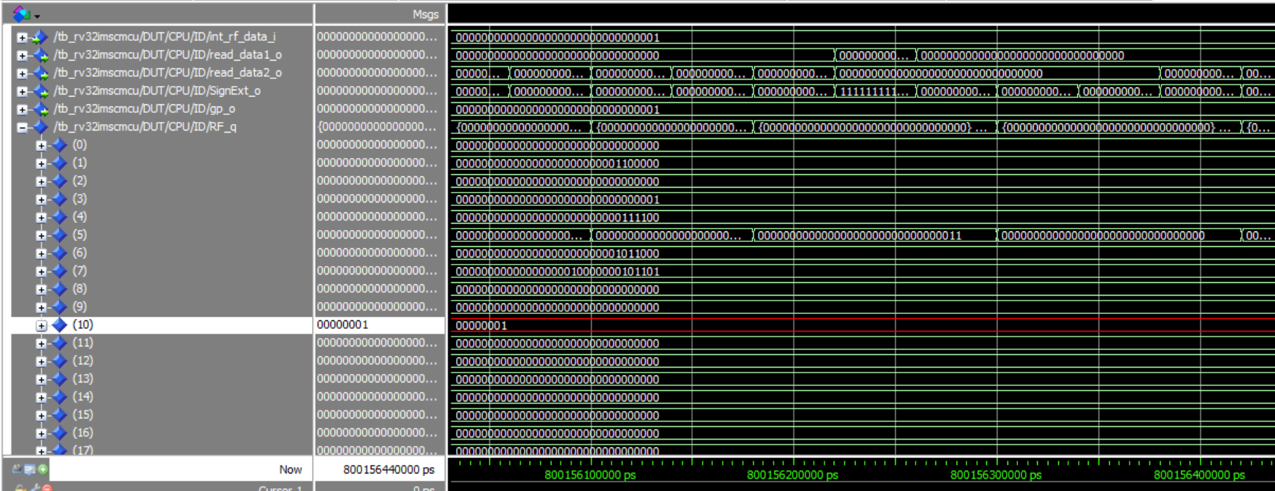
[picture p45: figure]

Figure 45

באיור מוצג האות RF_q(10) מתוך קובץ הרגיסטרים של המעבד. אות זה מייצג את הרגיסטר x10, שהוא לפי ה־ABI של RISC-V הרגיסטר a0. באפליקציית test2 הרגיסטר a0 משמש כמונה תוכנתי: לאחר ה־reset ערכו מאותחל ל־0, ובכל פסיקת Basic Timer מתבצע בתוך שגרת הפסיקה BT_ISR עדכון של a0 ב־1. מאחר שאצלנו SMCLK=25MHz והטיימר עובד בקצב SMCLK/8, פסיקת הטיימר הראשונה צפויה להגיע לאחר כ־0.8s, כלומר סביב 8×10^11 ps. אכן, בדיאגרמת הגלים ניתן לראות שבזמן זה RF_q(10) משתנה מ־0 ל־1, ובכך מתקבל אישוש לכך שפסיקת הטיימר נקלטה ושגרת הפסיקה עודכנה כראוי.

Test 3:

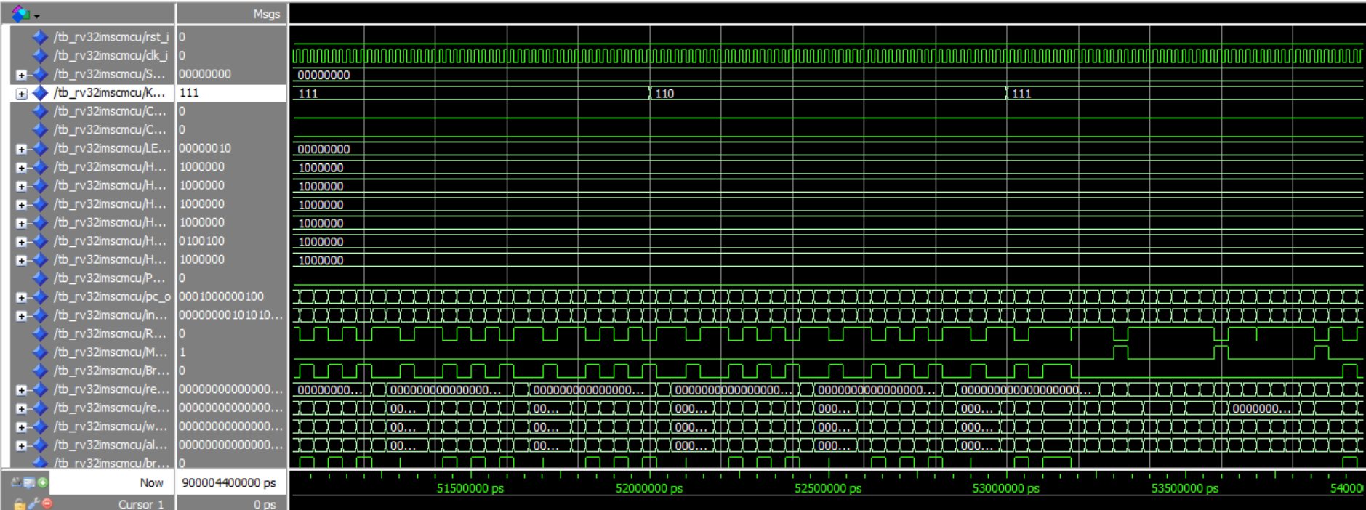
[picture p46: figure]

Figure 46

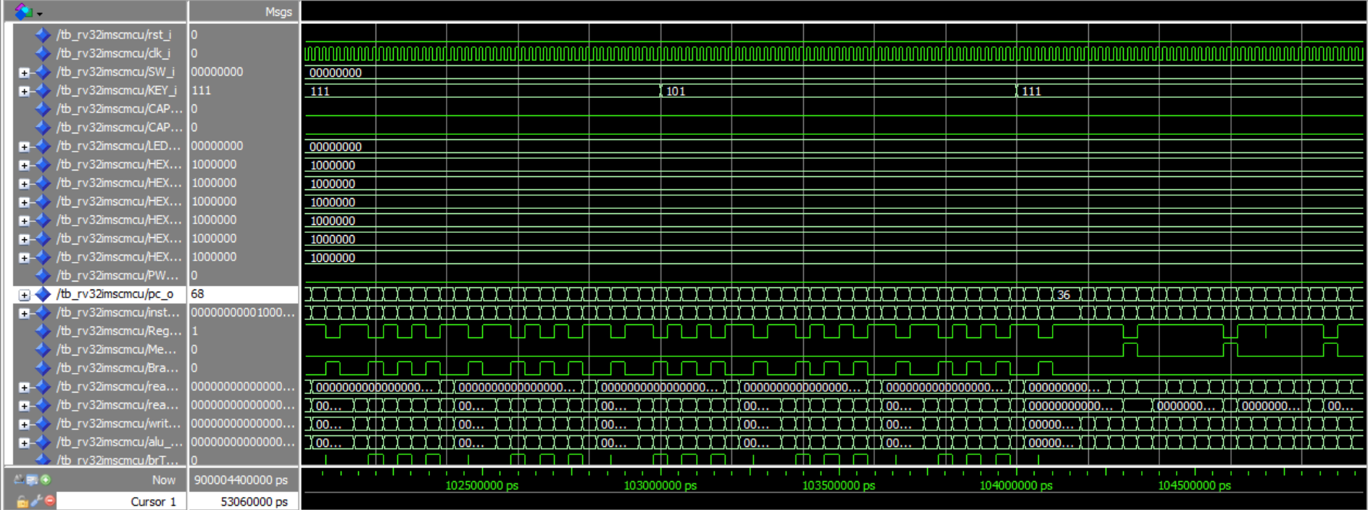
[picture p47: figure]

Figure 47

Test 4:

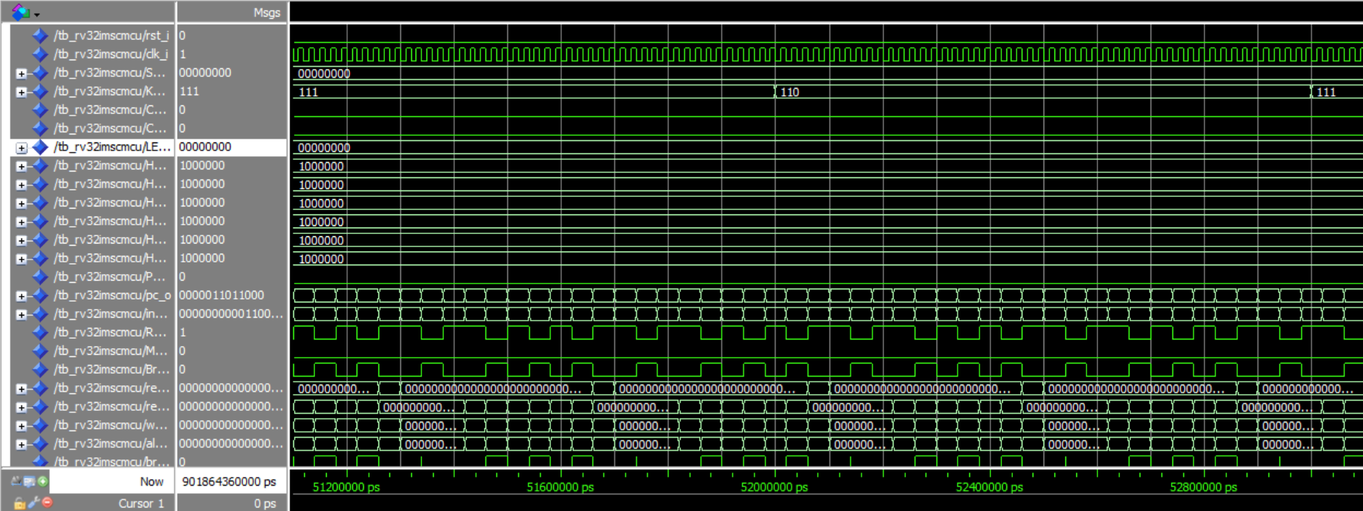
[picture p48: figure]

Figure 48

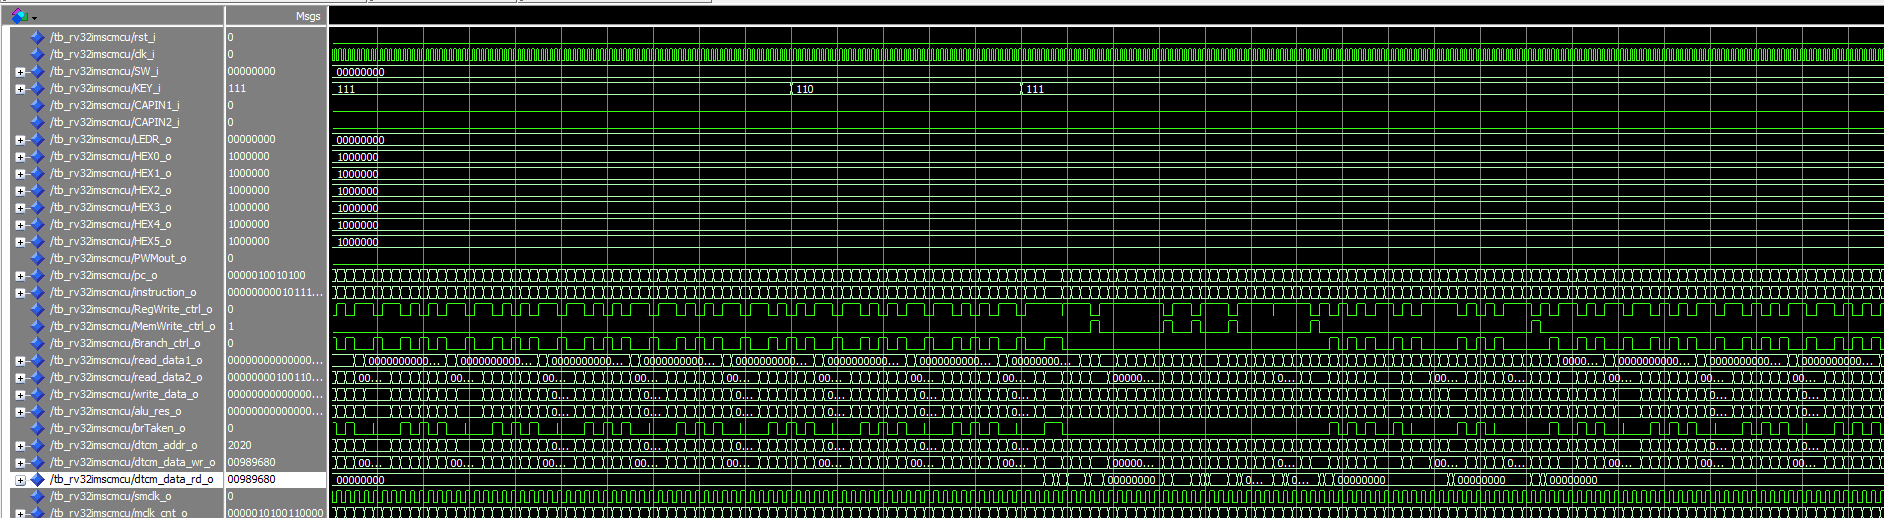
[picture p49: figure]

Figure 49

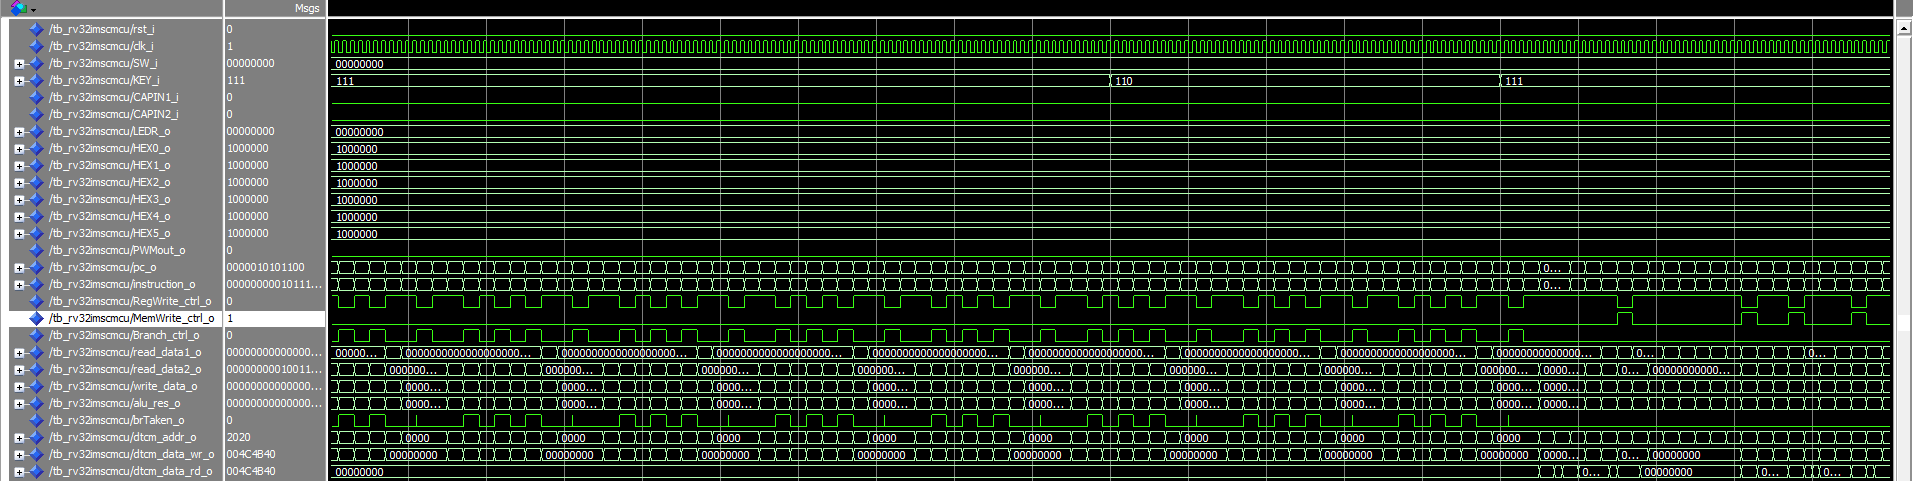
[picture p50: figure]

Figure 50

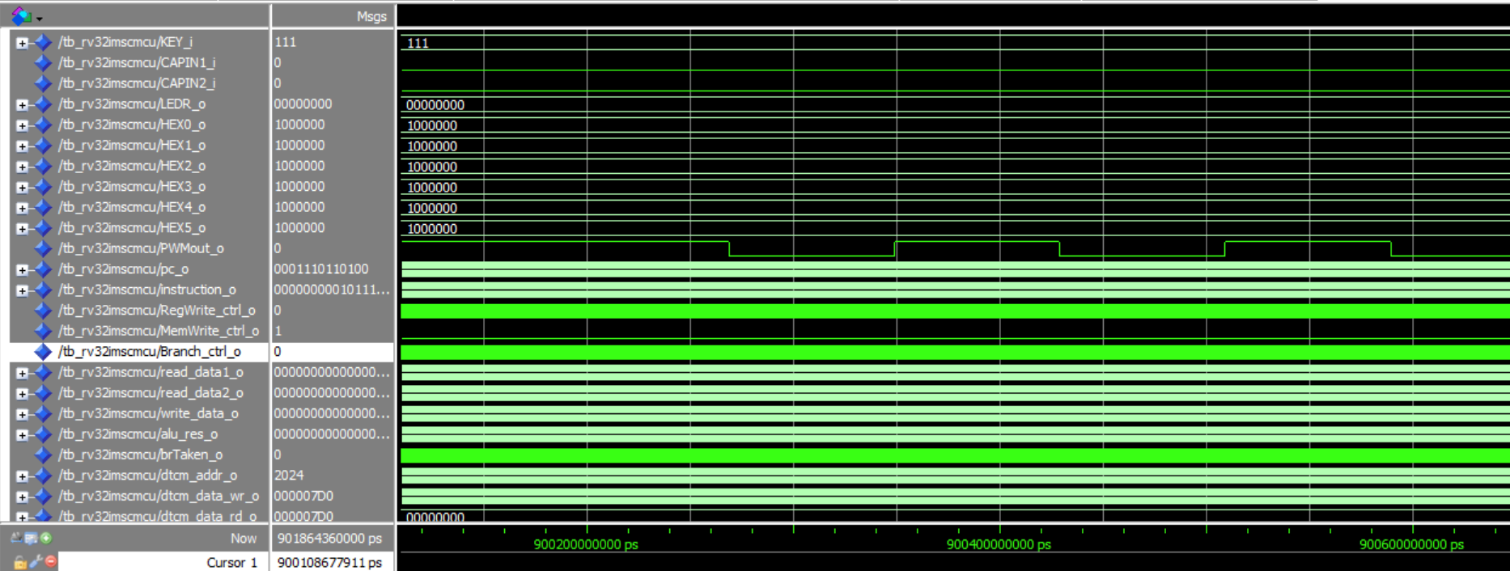
[picture p51: figure]

Figure 51

בדיאגרמת הגלים ניתן לראות כי PWMout_o נמצא במצב HIGH ובמצב LOW למשכי זמן כמעט שווים בכל מחזור, ולכן מתקבל אות PWM בעל Duty Cycle של כ-50%.

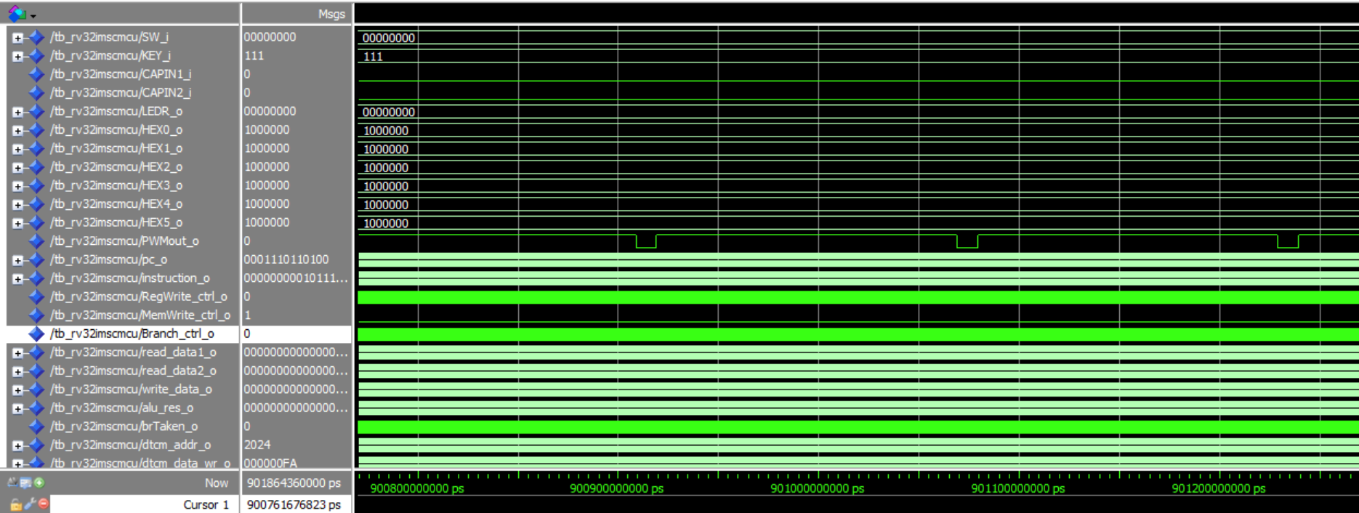
[picture p52: figure]

Figure 52

בדיאגרמת הגלים ניתן לראות כי PWMout_o נמצא במצב HIGH במשך רוב המחזור ורק לפרק זמן קצר במצב LOW, בהתאם ל-Duty Cycle של כ-93.75% שהוגדר בטסט.

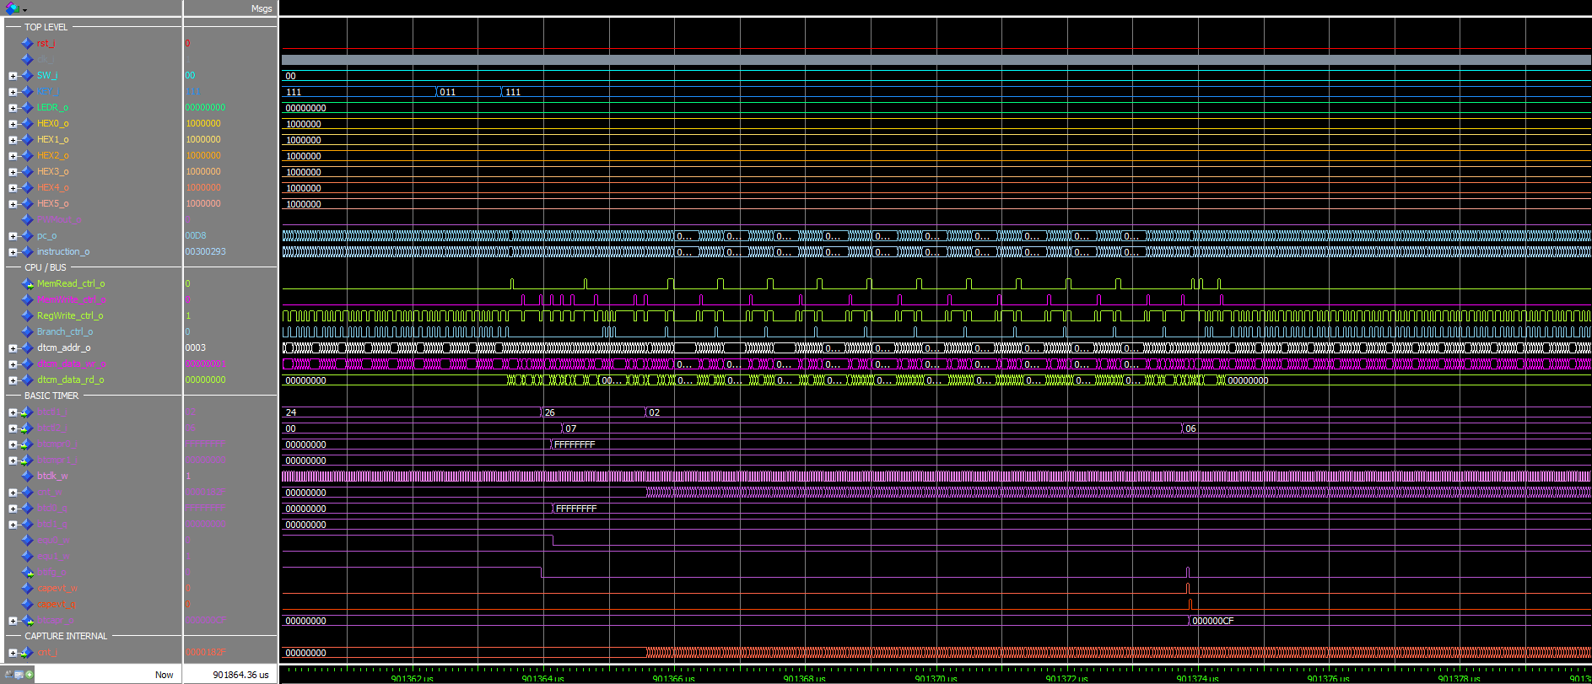
[picture p53: figure]

Figure 53

Signal Tap:

Test 1:

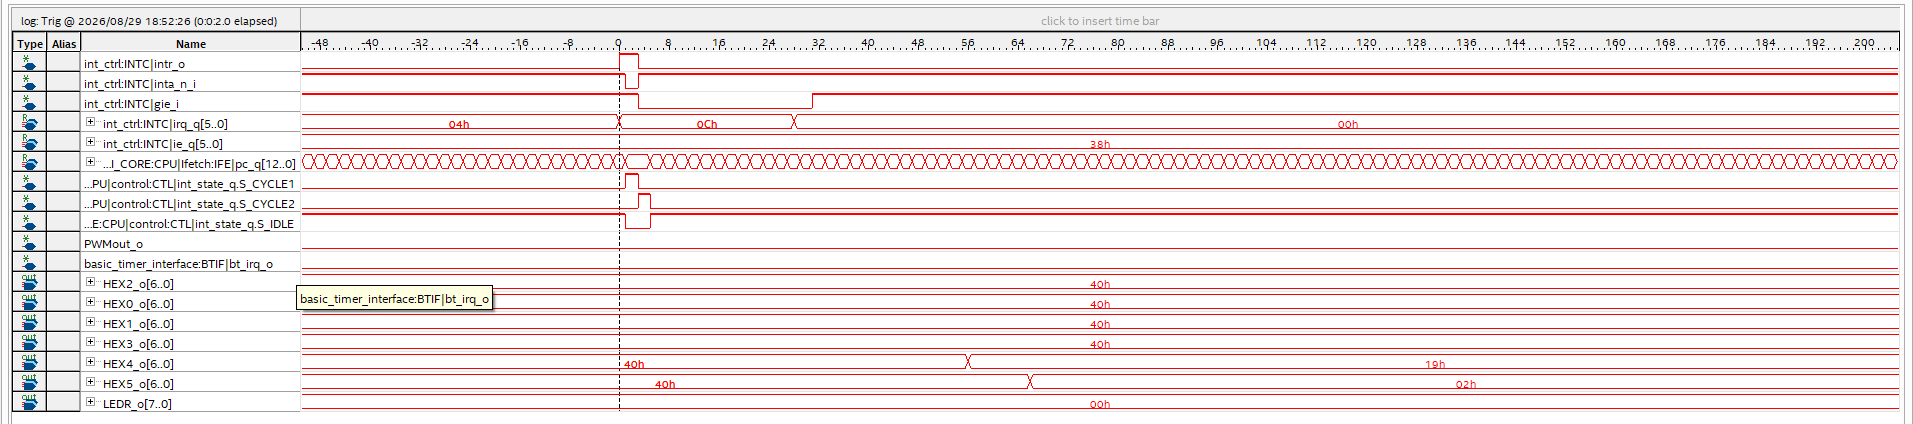
[picture p54: figure]

Figure 54

Test 2:

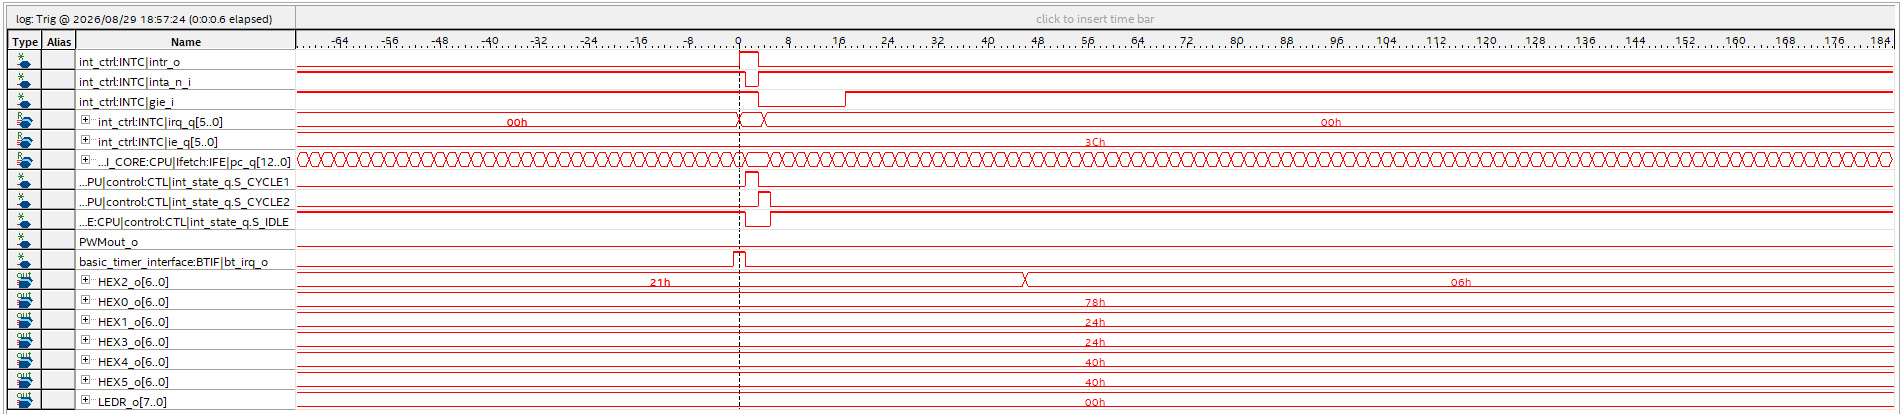
[picture p55: figure]

Figure 55

Test 3:

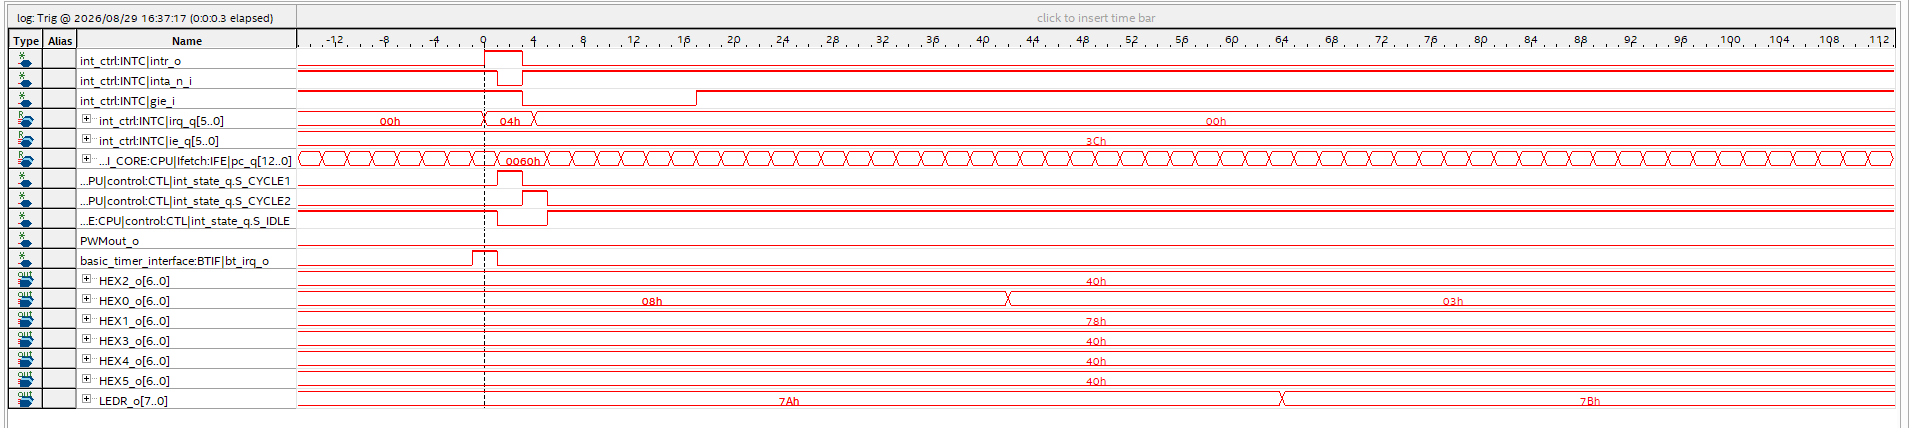
[picture p56: figure]

Figure 56

:Test4

PWM

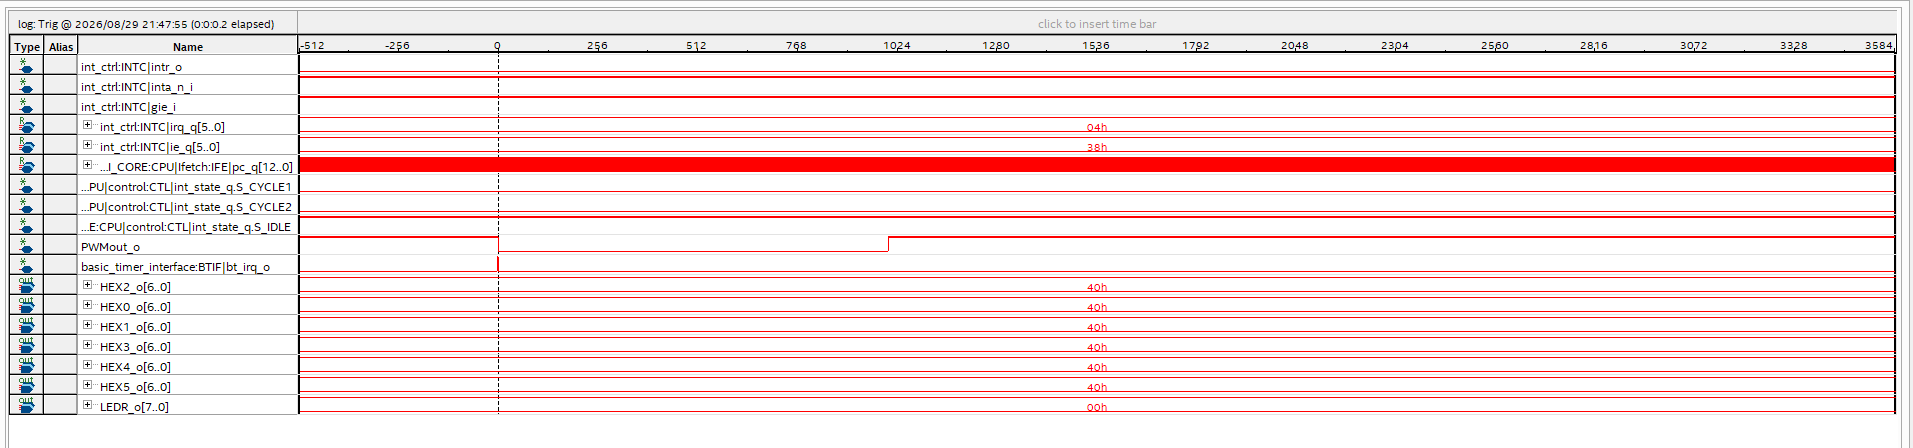
[picture p57: figure]

Figure 57

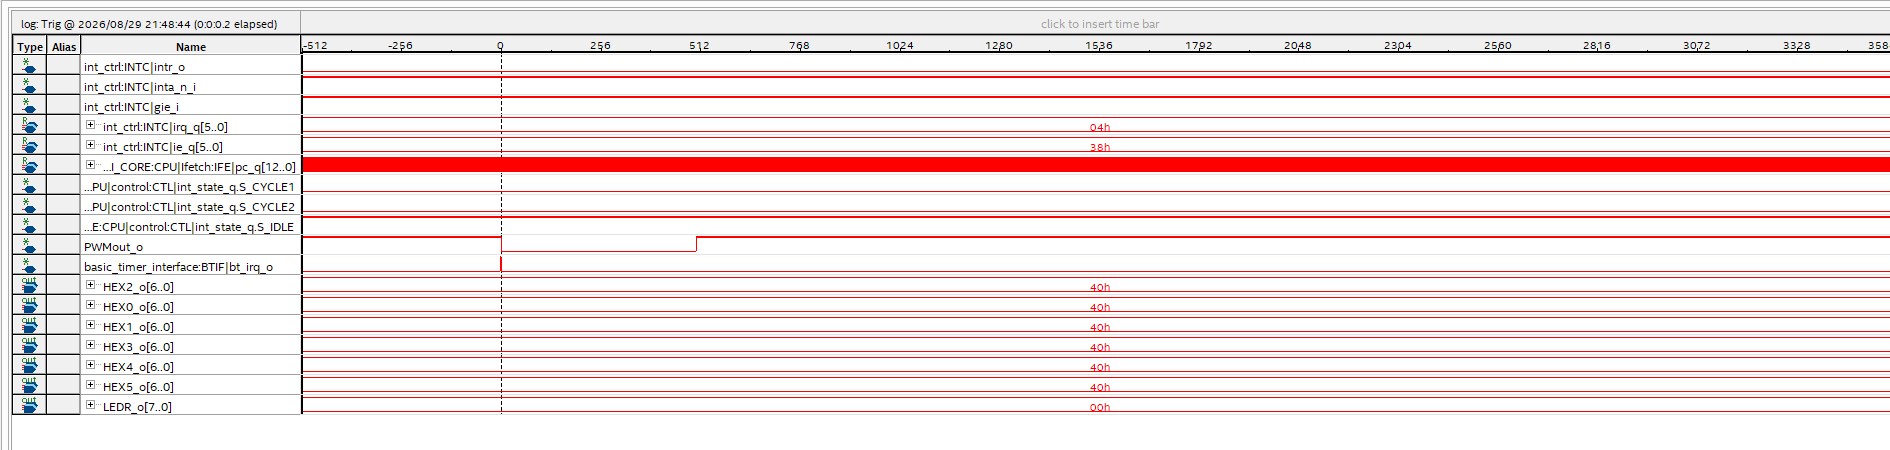
[picture p58: figure]

Figure 58

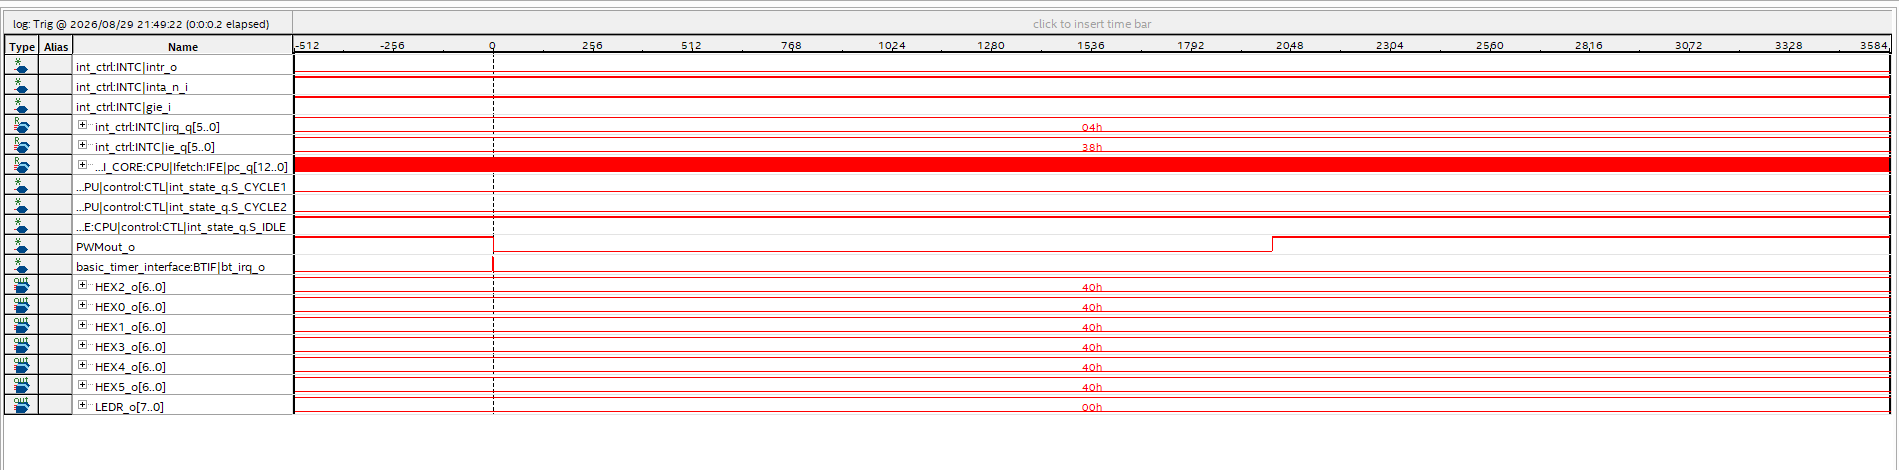
[picture p59: figure]

Figure 59

Capture

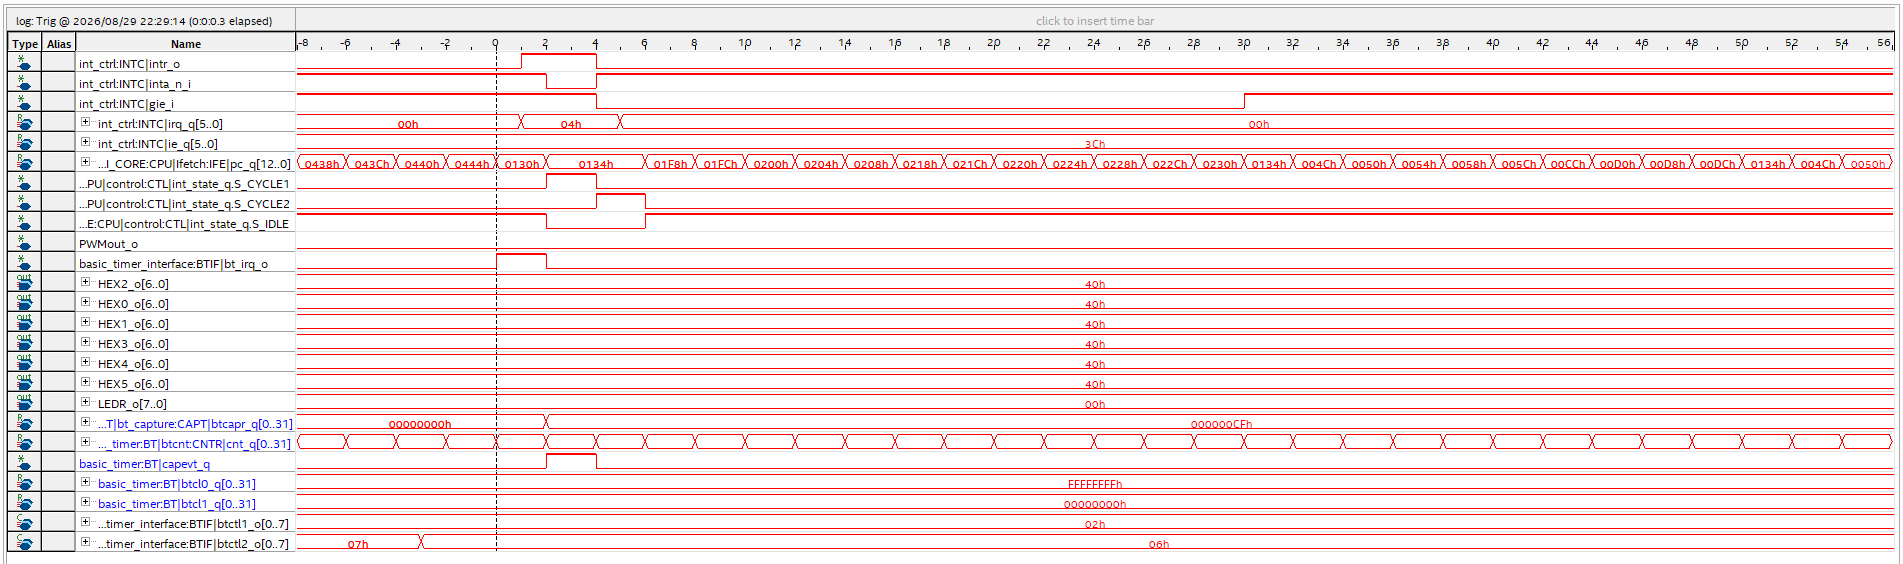
[picture p60: figure]

Figure 60
