OriDagan1/RISCV-MCU-Final-Project/DOC/interupts.docx

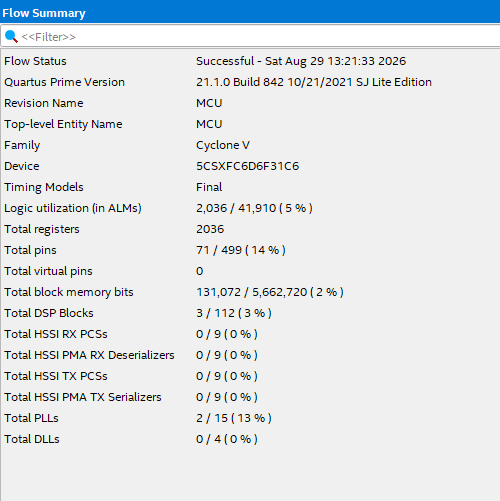
[picture p61: figure]

Critical Path:

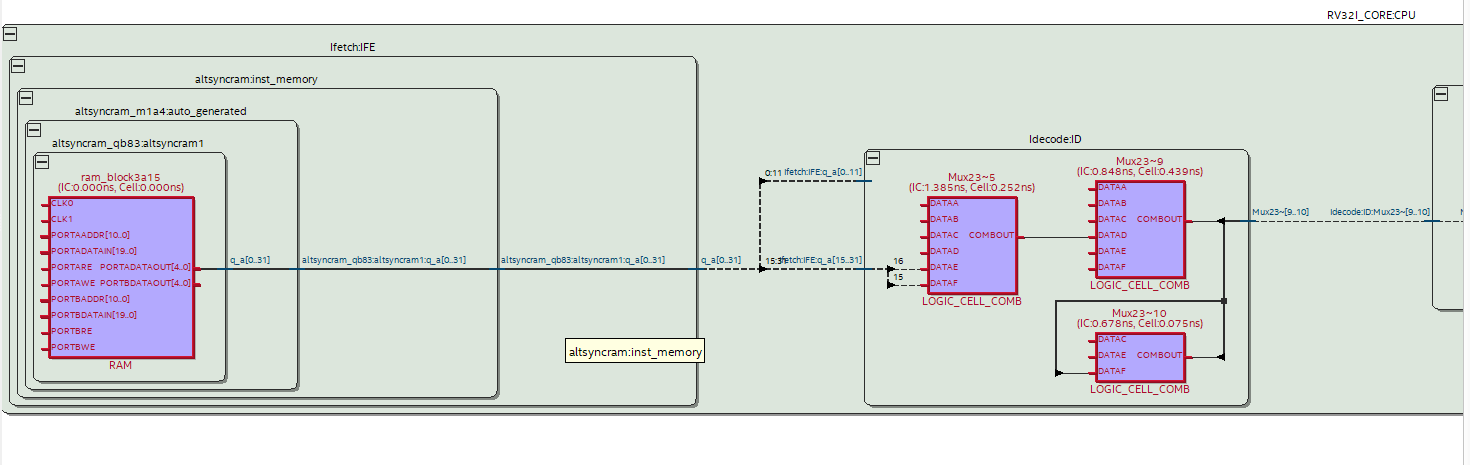
[picture p62: figure]

Signal Tap:

Test1


Test2


Test3


Test4

PWM


Capture


Power:

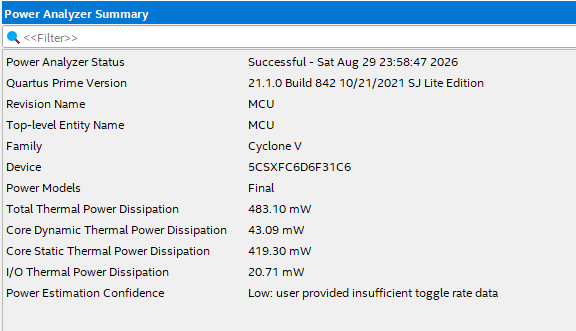
[picture p63: figure]

RTL Viewer:

MCU


Interrupt controller


CPU


Divider Accelerator


Dividing module


GPIO


Basic Timer
