OriDagan1/RISCV-MCU-Final-Project/(list of files, cad)

Other CAD files:
QUARTUS/RV32IMscMCU.stp
