OriDagan1/RISCV-MCU-Final-Project/Benchmark apps-20260827T145317Z-1-001/Benchmark apps/RV32IM/test1/gcc_compiled/test1_statistics.png

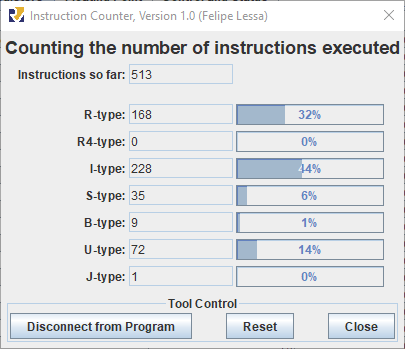
Benchmark apps-20260827T145317Z-1-001/Benchmark apps/RV32IM/test1/gcc_compiled/test1_statistics.png
