OriDagan1/RISCV-MCU-Final-Project/DOC/Screenshots/GPIO signaltap test1 sw0.png

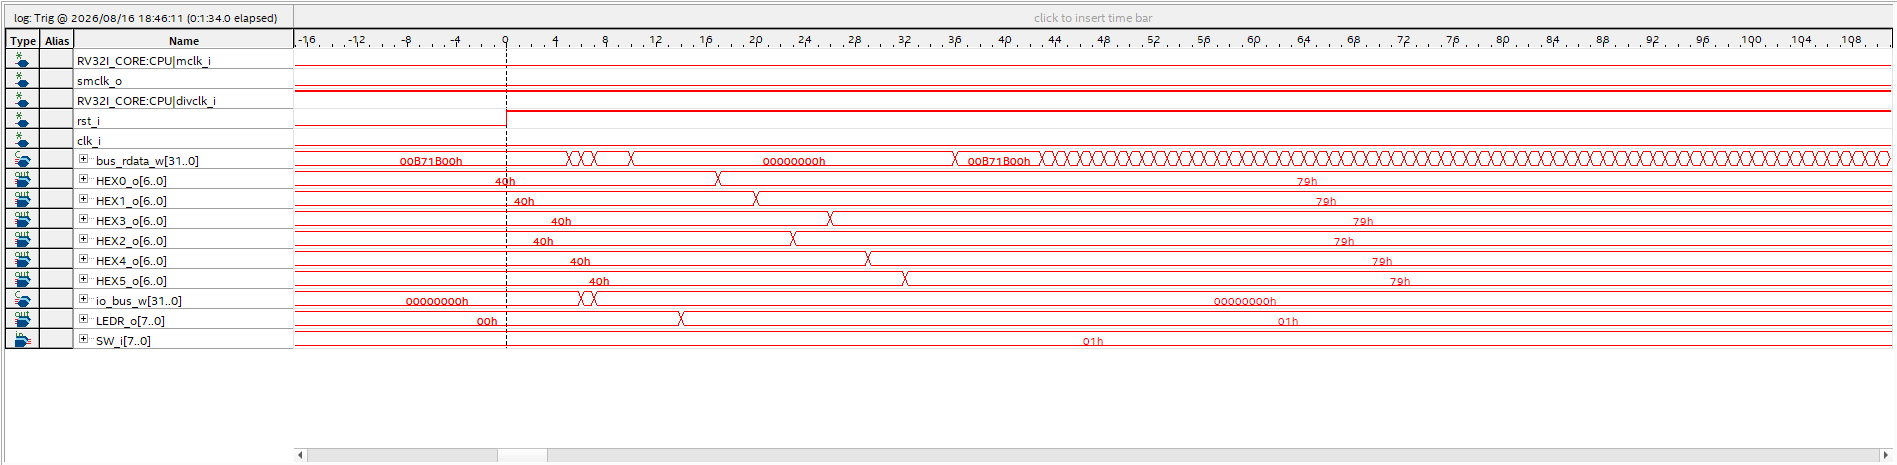
DOC/Screenshots/GPIO signaltap test1 sw0.png
