OriDagan1/RISCV-MCU-Final-Project/DOC/Screenshots/GPIO test0 waveform.png

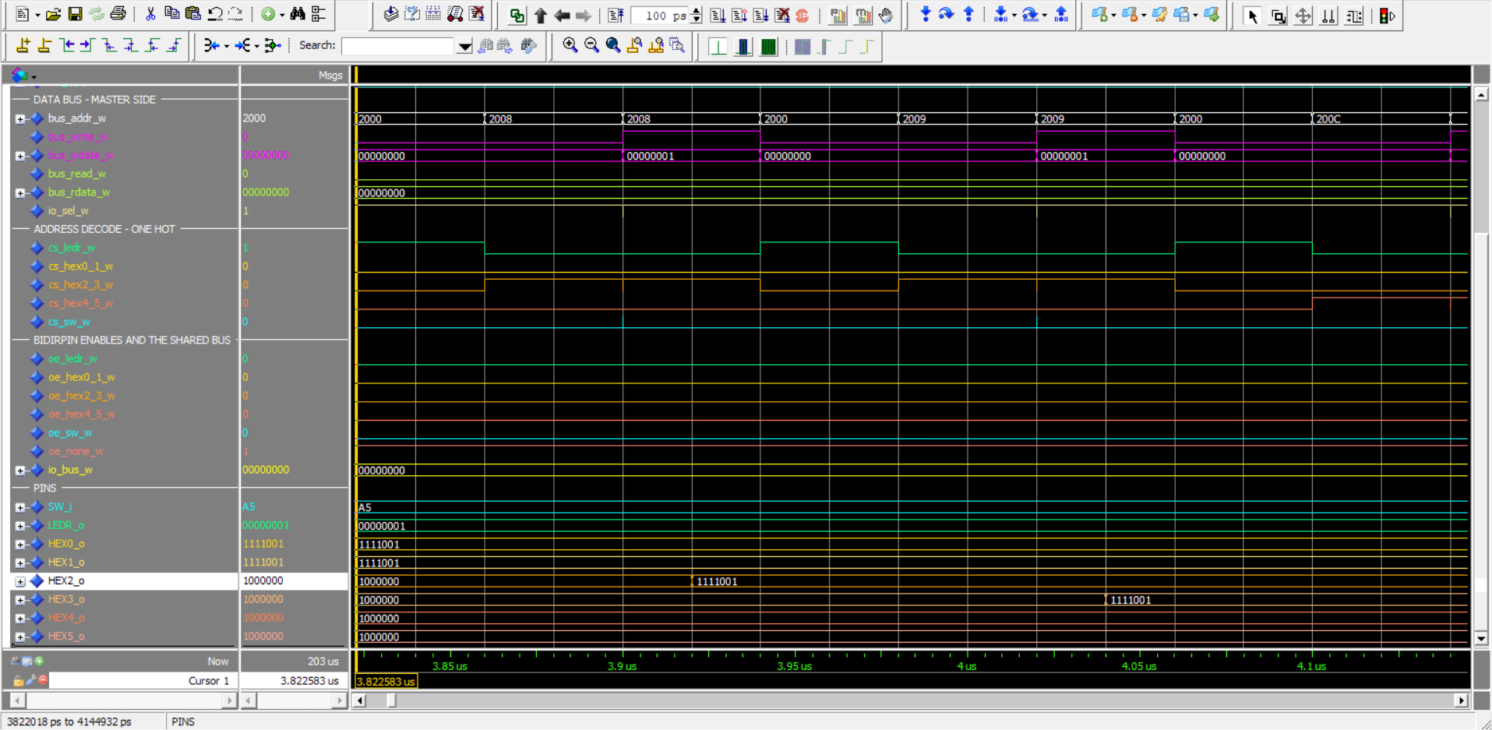
DOC/Screenshots/GPIO test0 waveform.png
