OriDagan1/RISCV-MCU-Final-Project/DOC/Screenshots/GPIO test2 counting down.png

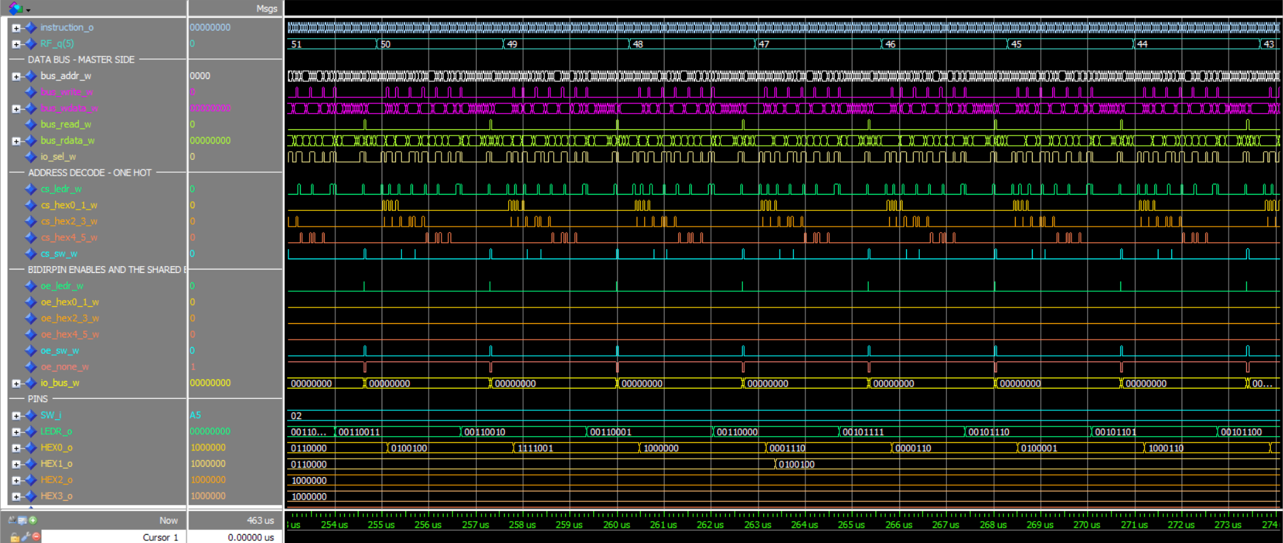
DOC/Screenshots/GPIO test2 counting down.png
