OriDagan1/RISCV-MCU-Final-Project/DOC/Screenshots/GPIO test2 counting up.png

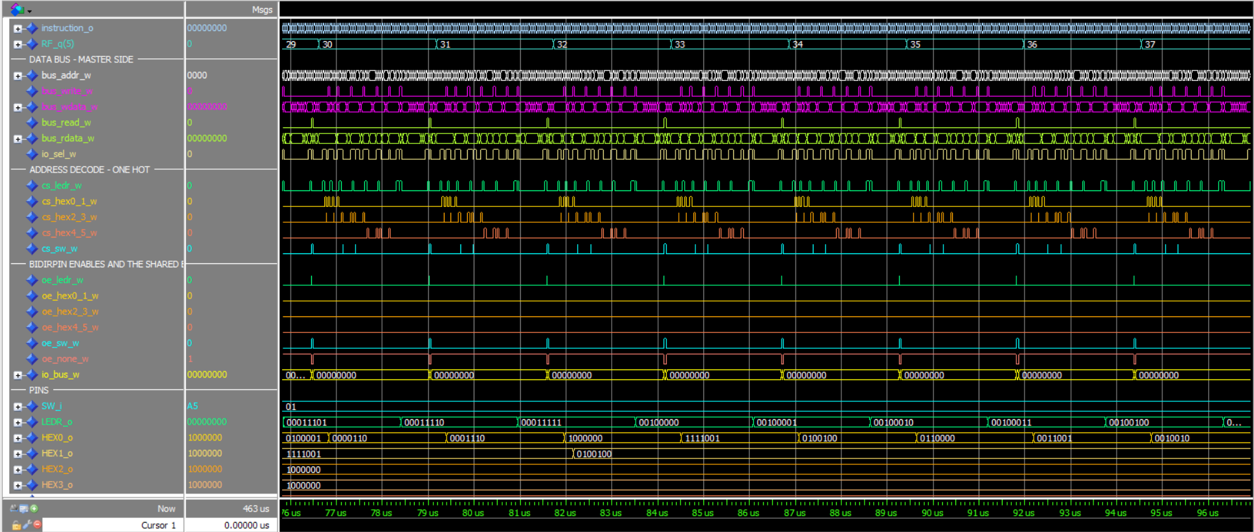
DOC/Screenshots/GPIO test2 counting up.png
