OriDagan1/RISCV-MCU-Final-Project/DOC/Screenshots/test1 RV32IM waveform.png

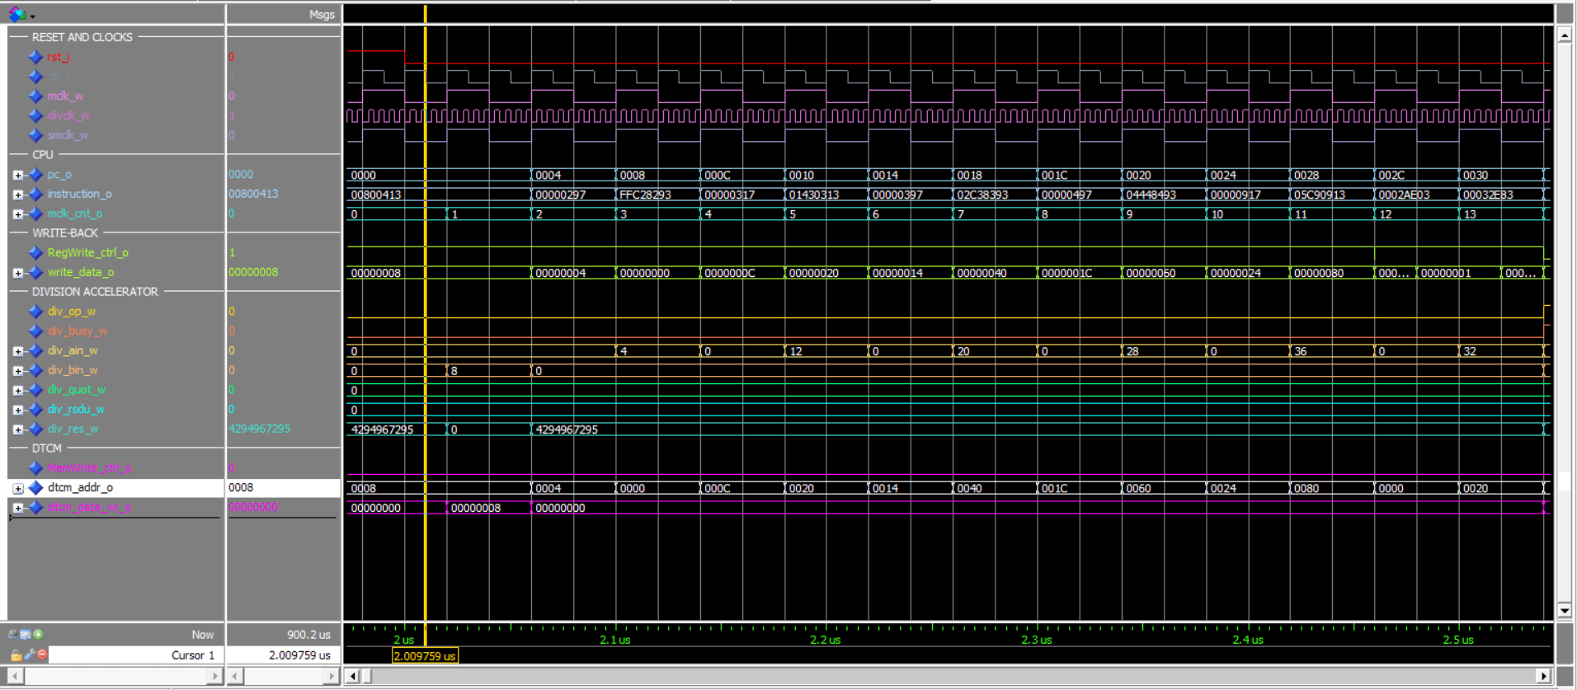
DOC/Screenshots/test1 RV32IM waveform.png
