OriDagan1/RISCV-MCU-Final-Project/DUT/RV32IMscMCU/BASIC_TIMER_INTERFACE.vhd

---------------------------------------------------------------------------------------------
-- Advanced CPU architecture and Hardware Accelerators Lab 361-1-4693 BGU
-- BASIC_TIMER_INTERFACE - the memory-mapped register file of the Basic Timer
--
-- Fig.7 draws the timer as a shaded block with BTCMPR0, BTCMPR1 and BTCAPR sitting
-- OUTSIDE it, and BTCTL1 / BTCTL2 given only as bit tables underneath. What crosses
-- into the shaded block is not a bus but the decoded control fields - BTCLR, BTHOLD,
-- BTSSEL, BTOUTMD, BTOUTEN, BTINT, CAPISEL, CAPMD - and what leaves it is BTCAPR,
-- PWMout and BTIFG. BASIC_TIMER.vhd is exactly that shaded block and says so in its
-- own header: it has no bus interface on purpose.
--
-- This module is the missing outside: the registers drawn touching the block, plus
-- the load/store path that lets the CPU reach them.
--
--   Data BUS  <--->  [ BTCTL1 BTCTL2 BTCMPR0 BTCMPR1 ]  --->  BASIC_TIMER
--                    [             BTCAPR            ]  <---
--
-- Register map, clause 6 of the project definition:
--
--   name      byte addr   resolution   access   width   reset
--   --------  ----------  -----------  -------  ------  -----
--   BTCTL1    0x201C      byte         rw        8      0x00
--   BTCTL2    0x201D      byte         rw        8      0x00
--   BTCMPR0   0x2020      word         rw       32      0
--   BTCMPR1   0x2024      word         rw       32      0
--   BTCAPR    0x2028      word         r        32      0
--
-- Bit layouts, from the tables on page 7:
--
--   BTCTL1   7 BTOUTMD | 6 BTOUTEN | 5 BTHOLD | 4:3 BTSSEL | 2 BTCLR | 1:0 BTINT
--   BTCTL2   7:4 reserved, read as 0        | 3:2 CAPMD   | 1:0 CAPISEL
--
-- NO ADDRESS COMPARISON HAPPENS HERE. PERIPH_AddressDecoder owns the map and hands
-- this module one chip select per register, exactly as GPIO_AddressDecoder does for
-- the GPIO ports. BTCTL1 and BTCTL2 are adjacent byte addresses that differ in bit 0
-- alone, so they share one chip select and sel_i - bit 0 of the byte address - picks
-- between them, which is the same arrangement GPIO_HEX_Pair_Interface uses for a pair
-- of displays. Decoding the address again in here would put a second comparator on
-- the load/store critical path for no gain.
--
-- BTCAPR IS READ/WRITE, WITH TWO LOAD SOURCES. The bit table on page 7 marks every
-- BTCAPR bit "rw", while Fig.7 draws it purely as the destination of "BTCNT_CAPTURE on
-- event register" and gives it no write path at all. An earlier version of this file
-- could not honour both and chose the figure, making a store to 0x2028 a silent no-op.
-- Forum row 25 resolves it in favour of the table: "All of the timer's interface
-- registers are readable and writable, except the four high bits of BTCTL2, which are
-- read-only." So BTCAPR is a real register here now, not a pass-through of btcapr_i,
-- and it is loadable from either side:
--
--   store to 0x2028   ->  btcapr_q <= data_wr_i        (falling edge, like every
--                                                       other register in this file)
--   capture event     ->  btcapr_q <= btcapr_i         (the count BT_CAPTURE latched)
--
-- The capture side needs to know WHEN a capture happened, which is what capevt_i is
-- for - basic_timer exposes BT_CAPTURE's capevt purely so this register can exist.
-- Watching btcapr_i for a change instead would not do: a periodic capture recording
-- the same count every period never changes it, and that is precisely test4's
-- input-capture mode, so the update would be silently missed.
--
-- Row 21 also puts BTCAPR in the list of interface registers that reset - "Only the
-- timer module's interface registers reset on RESET: BTCTL1, BTCTL2, BTCAPR, BTCMPR0,
-- BTCMPR1" - so btcapr_q resets to zero with the rest of them.
--
-- WHEN A STORE AND A CAPTURE LAND ON THE SAME EDGE, THE CAPTURE WINS. The two sources
-- are asymmetric in what losing costs. A store is software: the ISR still holds the
-- value in a register, knows it issued the store, and can read back and repeat it. A
-- capture is a hardware measurement of a counter that has already moved on - drop it
-- and the value does not exist anywhere any more. So the irrecoverable source takes
-- priority over the recoverable one. This is the same reasoning as INT_CTRL.vhd's
-- "set beats clear in the same cycle", and it also matches what the register is FOR:
-- BTCAPR exists to preserve what the hardware captured, and a store that happens to
-- collide with a capture must not be the thing that destroys it. The collision is
-- narrow - capevt_i is one BTCLK wide and the store is one MCLK falling edge - but it
-- is decided here explicitly rather than left to whichever branch comes last.
--
-- BTCNT IS NOT MAPPED. It is absent from the clause 6 table, so it gets no address.
-- BASIC_TIMER still exposes btcnt_o, which MCU.vhd may route to Signal-Tap.
--
-- THE REGISTERS ARE WRITTEN ON THE FALLING EDGE of MCLK, matching PORT_LEDR, the HEX
-- pairs and the DTCM, so that every target on the data bus captures write data at the
-- same instant of the CPU cycle.
--
-- NO CROSSING HARDWARE, AND EXACTLY WHAT THE ASSERT DOES AND DOES NOT ENFORCE.
-- These registers are written by the CPU in the MCLK domain and read by BASIC_TIMER
-- in the BTCLK domain, where BTCLK is SMCLK divided by BTSSEL. This file carries no
-- synchronizers, no bundled-data handshake on the 32-bit compare registers and no
-- toggle-pulse synchronizer on BTIFG. That is correct, and the authority is forum
-- row 15: "Since the CPU clock MCLK and the peripheral clock SMCLK are fed from the
-- same 50MHz physical source, it only remains to ensure that MCLK is an integer
-- multiple of SMCLK, which guarantees full synchronisation with no need for edge
-- synchronisation." MCU.vhd runs both from their own PLL off the one 50 MHz board
-- oscillator at 25 MHz each, so the ratio is 1 and the condition holds. BTSSEL only
-- divides SMCLK further, so BTCLK stays an integer submultiple of MCLK.
--
-- WHAT THE ASSERT BELOW ACTUALLY CHECKS: that G_SMCLK_MHZ equals G_MCLK_MHZ. Nothing
-- more. It is the row 15 condition, at ratio 1, and it is the whole reason this file
-- is allowed to have no crossing hardware in it - retune one clock without the other
-- and the design refuses to elaborate instead of quietly becoming unsafe. That is a
-- guard rail on retuning the PLLs, in the spirit of the DA_WIDTH assert in
-- GPIO_AddressDecoder.vhd.
--
-- WHAT IT DOES NOT CHECK, stated plainly because an earlier version of this comment
-- claimed otherwise: it says nothing about how either clock is generated. It compares
-- two constants. It will pass whether SMCLK is its own PLL output, a divided copy of
-- MCLK, or the identical net - and under row 15 that is fine, because the shared
-- 50 MHz source plus the integer ratio is the entire requirement and neither half of
-- it depends on the generation method. Do not read this assert as proving that SMCLK
-- and MCLK are the same physical net; they are not, and they do not need to be.
--
-- The tri-state buffer of Figure 5 is realised as a read multiplexer: this module
-- drives zeros when it is not selected, so the I/O read paths can be OR-ed together.
-- Cyclone devices have no internal tri-state anyway - Quartus converts every internal
-- 'Z' into exactly this multiplexer.
--
-- BTIFG_I / BT_IRQ_O - ONE PULSE PER TIMER EVENT, SAFE ONLY BECAUSE OF THE CLOCK
-- ARCHITECTURE. btifg_o out of basic_timer is a LEVEL, not a pulse: in the default
-- mode BTINT="00" it is equ0_w, which is high while BTCNT >= BTCL0, and the counter
-- clears on the same edge - so it is high for exactly one BTCLK period, which is one,
-- two, four or eight MCLK periods depending on BTSSEL. GPIO_PB_Interface already hands
-- the interrupt controller one-MCLK-cycle pulses on key1_irq_o..key3_irq_o; if this
-- module handed it a multi-cycle level instead, the flag would re-arm the instant the
-- service routine cleared it and the CPU would spin in interrupts forever. bt_irq_o is
-- this module's edge detector on btifg_i, resampled and compared one clk_i cycle
-- later, so it produces exactly one pulse per rising edge of btifg_i regardless of how
-- many MCLK cycles that level stays high.
--
-- Detecting that edge with a single register and no synchronizer is safe because of
-- the row 15 condition the ASSERT above holds: SMCLK and MCLK come from the same
-- 50 MHz source at an integer ratio, so BTCLK - one of SMCLK's BTSSEL taps - is an
-- integer submultiple of clk_i and can only ever be equal to or slower than it. A
-- BTCLK-wide level is therefore at least one clk_i period long and cannot be missed.
-- Were the ratio ever made non-integer, btifg_i would need a toggle-pulse
-- synchronizer here instead - a plain two-flop level synchronizer can miss a pulse
-- narrower than one destination clock period - and that is exactly the case the
-- ASSERT refuses to let elaborate.
--
-- The edge is detected on the RISING edge of clk_i, unlike the register writes above,
-- which capture on the falling edge. This has to match GPIO_PB_Interface, which
-- detects its key-release edges on the rising edge of clk_i, because both feed the
-- same interrupt controller and a mismatched sampling edge would skew one source's
-- pulses relative to the others by half an MCLK cycle for no reason.
--
-- DOCUMENTED LIMITATION, NOT A TASK REQUIREMENT: with BTSSEL="00" and BTCMPR0=0,
-- BTCL0 is also 0 (it self-starts from BTCMPR0, see BASIC_TIMER.vhd's header) and
-- EQU0 = "BTCNT >= BTCL0" is then true on every single BTCLK cycle - it never falls,
-- so it never has a rising edge to detect, and bt_irq_o never pulses. BTCMPR0 must be
-- programmed to at least 1 before BTINT="00" can generate any interrupt event. The
-- task definition does not discuss this; it falls directly out of the EQU0 definition
-- of Fig.7 once a rising-edge pulse extractor sits downstream of it.
--
-- No IFG register, no IE bit, no masking and no clearing logic live here. Those
-- belong to the interrupt controller, which is not yet written.
---------------------------------------------------------------------------------------------
LIBRARY IEEE;
USE IEEE.STD_LOGIC_1164.ALL;
USE work.clk_config_package.all;

ENTITY basic_timer_interface IS
	generic(
		DATA_BUS_WIDTH		: integer := 32;
		N					: positive := 32;	-- compare and capture width, as BASIC_TIMER
		CTL_WIDTH			: integer := 8		-- BTCTL1 and BTCTL2 are byte registers
	);
	PORT(
		--Inputs
		clk_i				: IN	STD_LOGIC;	-- MCLK
		rst_i				: IN	STD_LOGIC;

		--Chip selects, one per register, from PERIPH_AddressDecoder
		cs_btctl_i			: IN	STD_LOGIC;	-- BTCTL1 / BTCTL2  0x201C / 0x201D
		cs_btcmpr0_i		: IN	STD_LOGIC;	-- BTCMPR0          0x2020
		cs_btcmpr1_i		: IN	STD_LOGIC;	-- BTCMPR1          0x2024
		cs_btcapr_i			: IN	STD_LOGIC;	-- BTCAPR           0x2028

		sel_i				: IN	STD_LOGIC;	-- bit 0 of the byte address: '0' BTCTL1, '1' BTCTL2

		MemRead_ctrl_i		: IN	STD_LOGIC;
		MemWrite_ctrl_i		: IN	STD_LOGIC;
		data_wr_i			: IN	STD_LOGIC_VECTOR(DATA_BUS_WIDTH-1 DOWNTO 0);

		--From the timer, the captured count, and the event that produced it.
		--Both are needed: BTCAPR is read/write (row 25), so it is a register
		--here with two load sources, and capevt_i is what tells it that the
		--timer side has a new value. See the header.
		btcapr_i			: IN	STD_LOGIC_VECTOR(N-1 DOWNTO 0);
		capevt_i			: IN	STD_LOGIC;

		--From the timer, the BTIFG level - one BTCLK wide, see the header
		btifg_i				: IN	STD_LOGIC;

		--Outputs
		data_rd_o			: OUT	STD_LOGIC_VECTOR(DATA_BUS_WIDTH-1 DOWNTO 0);

		--To the interrupt controller: one MCLK cycle per event, matches
		--key1_irq_o..key3_irq_o out of GPIO_PB_Interface
		bt_irq_o			: OUT	STD_LOGIC;

		--To the timer, the registers of Fig.7
		btctl1_o			: OUT	STD_LOGIC_VECTOR(CTL_WIDTH-1 DOWNTO 0);
		btctl2_o			: OUT	STD_LOGIC_VECTOR(CTL_WIDTH-1 DOWNTO 0);
		btcmpr0_o			: OUT	STD_LOGIC_VECTOR(N-1 DOWNTO 0);
		btcmpr1_o			: OUT	STD_LOGIC_VECTOR(N-1 DOWNTO 0)
	);
END basic_timer_interface;
---------------------------------------------------------------------------------------------
ARCHITECTURE rtl OF basic_timer_interface IS

	-- BTCTL2 bits 7:4 are marked r in the bit table, so they are not stored at all:
	-- a store cannot set them and a load returns zeros in their place.
	CONSTANT CTL2_MSB		: integer := 3;		-- highest implemented bit of BTCTL2

	SIGNAL btctl1_q			: STD_LOGIC_VECTOR(CTL_WIDTH-1 DOWNTO 0);
	SIGNAL btctl2_q			: STD_LOGIC_VECTOR(CTL2_MSB DOWNTO 0);
	SIGNAL btcmpr0_q		: STD_LOGIC_VECTOR(N-1 DOWNTO 0);
	SIGNAL btcmpr1_q		: STD_LOGIC_VECTOR(N-1 DOWNTO 0);
	-- BTCAPR is a real register now, not a pass-through of btcapr_i. Row 25.
	SIGNAL btcapr_q			: STD_LOGIC_VECTOR(N-1 DOWNTO 0);

	SIGNAL wren_ctl1_w		: STD_LOGIC;
	SIGNAL wren_ctl2_w		: STD_LOGIC;
	SIGNAL wren_cmpr0_w		: STD_LOGIC;
	SIGNAL wren_cmpr1_w		: STD_LOGIC;
	SIGNAL wren_capr_w		: STD_LOGIC;

	SIGNAL btctl2_w			: STD_LOGIC_VECTOR(CTL_WIDTH-1 DOWNTO 0);
	SIGNAL ctl_rd_w			: STD_LOGIC_VECTOR(CTL_WIDTH-1 DOWNTO 0);

	-- Each register widened to the bus, then one multiplexer over the four
	SIGNAL rd_ctl_w			: STD_LOGIC_VECTOR(DATA_BUS_WIDTH-1 DOWNTO 0);
	SIGNAL rd_cmpr0_w		: STD_LOGIC_VECTOR(DATA_BUS_WIDTH-1 DOWNTO 0);
	SIGNAL rd_cmpr1_w		: STD_LOGIC_VECTOR(DATA_BUS_WIDTH-1 DOWNTO 0);
	SIGNAL rd_capr_w		: STD_LOGIC_VECTOR(DATA_BUS_WIDTH-1 DOWNTO 0);
	SIGNAL rdata_w			: STD_LOGIC_VECTOR(DATA_BUS_WIDTH-1 DOWNTO 0);

	-- btifg_i delayed by one clk_i cycle, so the edge detector below has
	-- something to compare against. See the header for why no synchronizer
	-- is needed here.
	SIGNAL btifg_q			: STD_LOGIC;

BEGIN

	-- Forum row 15's condition, at ratio 1. See the header for what this does and
	-- does not enforce: it compares the two frequencies, and says nothing about how
	-- either clock is generated. That is the whole requirement - both come from the
	-- one 50 MHz board source, so an integer ratio guarantees synchronisation.
	ASSERT G_SMCLK_MHZ = G_MCLK_MHZ
		REPORT "basic_timer_interface: SMCLK and MCLK must be the same frequency. "
			 & "G_SMCLK_MHZ differs from G_MCLK_MHZ, so the MCLK-to-SMCLK ratio is no "
			 & "longer the integer ratio forum row 15 requires, and these registers "
			 & "would cross clock domains unprotected - BTCMPR0/1 need a bundled-data "
			 & "handshake and BTIFG a toggle pulse synchronizer. Either equalise the "
			 & "clocks in QUARTUS/gen_plls.tcl or add the crossing logic before "
			 & "removing this assert"
		SEVERITY FAILURE;

	--=======================================
	-- Access qualifiers
	--=======================================
	-- A register answers only when its own chip select is asserted and the access is
	-- a store. BTCTL1 and BTCTL2 share a chip select, so sel_i decides which of the
	-- two a store reaches - exactly one register is written per store, never both.
	-- BTCAPR now has one too: row 25 makes it read/write. See the header.
	wren_ctl1_w		<= cs_btctl_i	AND MemWrite_ctrl_i AND (NOT sel_i);
	wren_ctl2_w		<= cs_btctl_i	AND MemWrite_ctrl_i AND sel_i;
	wren_cmpr0_w	<= cs_btcmpr0_i	AND MemWrite_ctrl_i;
	wren_cmpr1_w	<= cs_btcmpr1_i	AND MemWrite_ctrl_i;
	wren_capr_w		<= cs_btcapr_i	AND MemWrite_ctrl_i;

	--=======================================
	-- Write path : CPU -> registers, and the timer -> BTCAPR
	--=======================================
	-- All five registers reset to zero - page 7 for the four control and compare
	-- registers, and forum row 21 for BTCAPR, which names it explicitly in the list of
	-- interface registers that reset. That reset value is what makes the timer safe out
	-- of reset: BTCTL1 = 0 means BTHOLD released, BTSSEL on undivided SMCLK, BTINT on
	-- EQU0, and BTCTL2 = 0 means capture disabled.
	--
	-- BTCAPR is the one register with two load sources. capevt_i is tested FIRST, so a
	-- capture beats a store that lands on the same edge - see the header for why the
	-- irrecoverable source wins over the recoverable one.
	WRREG:
	process (clk_i, rst_i)
	begin
		if rst_i = '1' then
			btctl1_q	<= (OTHERS => '0');
			btctl2_q	<= (OTHERS => '0');
			btcmpr0_q	<= (OTHERS => '0');
			btcmpr1_q	<= (OTHERS => '0');
			btcapr_q	<= (OTHERS => '0');
		elsif falling_edge(clk_i) then
			if wren_ctl1_w = '1' then
				btctl1_q	<= data_wr_i(CTL_WIDTH-1 DOWNTO 0);
			end if;
			if wren_ctl2_w = '1' then
				btctl2_q	<= data_wr_i(CTL2_MSB DOWNTO 0);
			end if;
			if wren_cmpr0_w = '1' then
				btcmpr0_q	<= data_wr_i(N-1 DOWNTO 0);
			end if;
			if wren_cmpr1_w = '1' then
				btcmpr1_q	<= data_wr_i(N-1 DOWNTO 0);
			end if;

			-- Capture first, store second: on a collision the hardware measurement
			-- survives and the store is the one that has to be repeated.
			if capevt_i = '1' then
				btcapr_q	<= btcapr_i;
			elsif wren_capr_w = '1' then
				btcapr_q	<= data_wr_i(N-1 DOWNTO 0);
			end if;
		end if;
	end process;

	--=======================================
	-- Register outputs : registers -> timer
	--=======================================
	-- BASIC_TIMER decodes the fields itself, so the bytes are handed over whole.
	-- The reserved bits of BTCTL2 are driven as zeros rather than left undriven, so
	-- the value the timer sees and the value a load returns are the same byte.
	btctl2_w(CTL_WIDTH-1 DOWNTO CTL2_MSB+1)	<= (OTHERS => '0');
	btctl2_w(CTL2_MSB DOWNTO 0)				<= btctl2_q;

	btctl1_o	<= btctl1_q;
	btctl2_o	<= btctl2_w;
	btcmpr0_o	<= btcmpr0_q;
	btcmpr1_o	<= btcmpr1_q;

	--=======================================
	-- Read path : registers -> CPU
	--=======================================
	-- The control byte selected by sel_i, zero extended to the bus width, so both lw
	-- and lbu return it unchanged.
	ctl_rd_w	<= btctl2_w WHEN sel_i = '1' ELSE btctl1_q;

	-- Each register widened to the bus. The N-wide slices are null ranges when N
	-- equals the bus width, which is the normal case, and the assignments simply
	-- disappear - the same idiom GPIO_SW_Interface uses for its narrow port.
	rd_ctl_w(DATA_BUS_WIDTH-1 DOWNTO CTL_WIDTH)	<= (OTHERS => '0');
	rd_ctl_w(CTL_WIDTH-1 DOWNTO 0)				<= ctl_rd_w;

	rd_cmpr0_w(DATA_BUS_WIDTH-1 DOWNTO N)		<= (OTHERS => '0');
	rd_cmpr0_w(N-1 DOWNTO 0)					<= btcmpr0_q;

	rd_cmpr1_w(DATA_BUS_WIDTH-1 DOWNTO N)		<= (OTHERS => '0');
	rd_cmpr1_w(N-1 DOWNTO 0)					<= btcmpr1_q;

	-- BTCAPR is read from the register above, not straight through from btcapr_i. It
	-- holds the most recent captured count as it always did - capevt_i loads it on
	-- every capture - and now also whatever software last stored there, which is what
	-- makes it read/write per row 25.
	rd_capr_w(DATA_BUS_WIDTH-1 DOWNTO N)		<= (OTHERS => '0');
	rd_capr_w(N-1 DOWNTO 0)						<= btcapr_q;

	-- One read multiplexer over the four addressable registers. The chip selects are
	-- one-hot by construction in PERIPH_AddressDecoder, so the priority in this chain
	-- is never exercised; it exists only to give the expression a defined default of
	-- zero, which is what lets MCU.vhd OR the I/O read paths together.
	rdata_w		<=	rd_ctl_w	WHEN cs_btctl_i		= '1' ELSE
					rd_cmpr0_w	WHEN cs_btcmpr0_i	= '1' ELSE
					rd_cmpr1_w	WHEN cs_btcmpr1_i	= '1' ELSE
					rd_capr_w	WHEN cs_btcapr_i	= '1' ELSE
					(OTHERS => '0');

	data_rd_o	<= rdata_w WHEN (MemRead_ctrl_i = '1') ELSE (OTHERS => '0');

	--=======================================
	-- BTIFG edge detector : level -> one-MCLK-cycle pulse
	--=======================================
	-- See the header for why a single register with no synchronizer is
	-- enough here, why the edge is caught on the rising edge of clk_i, and
	-- for the BTCMPR0 >= 1 limitation this implies.
	EDGE_DET:
	process (clk_i, rst_i)
	begin
		if rst_i = '1' then
			btifg_q	<= '0';
		elsif rising_edge(clk_i) then
			btifg_q	<= btifg_i;
		end if;
	end process;

	bt_irq_o	<= btifg_i AND (NOT btifg_q);

END rtl;
