OriDagan1/RISCV-MCU-Final-Project/DUT/RV32IMscMCU/IFETCH.VHD

--============================================================================
-- Copyright 2026 Hananya Ribo 
-- Advanced CPU architecture and Hardware Accelerators Lab 361-1-4693 BGU
-- Top Level Structural Model for Single-Cycle RISC-V Core
-- IFETCH module provides the PC and the ITCM of the RISC-V core)
--============================================================================
LIBRARY IEEE;
USE IEEE.STD_LOGIC_1164.ALL;
USE IEEE.STD_LOGIC_ARITH.ALL;
USE IEEE.STD_LOGIC_UNSIGNED.ALL;
LIBRARY altera_mf;
USE altera_mf.altera_mf_components.all;
-- For G_ITCM_INIT_FILE, the default ITCM image. See the note on it there.
USE work.cond_compilation_package.all;


ENTITY Ifetch IS
	generic(
		WORD_GRANULARITY 	: boolean	:= False;
		DATA_BUS_WIDTH 		: integer	:= 32;
		PC_WIDTH 			: integer	:= 10;
		ITCM_ADDR_WIDTH 	: integer	:= 8;
		WORDS_NUM 			: integer	:= 256;
		-- Benchmark image. Override from the testbench (or with vsim -g) so
		-- switching application does not mean editing this file.
		ITCM_INIT_FILE		: string	:= G_ITCM_INIT_FILE
	);
	PORT(
		--Inputs
		clk_i			: IN 	STD_LOGIC;
		rst_i 			: IN 	STD_LOGIC;
		addr_gen_i 		: IN 	STD_LOGIC_VECTOR(PC_WIDTH-1 DOWNTO 0);
		Branch_ctrl_i	: IN 	STD_LOGIC;
		brTaken_i 		: IN 	STD_LOGIC;
		Jal_ctrl_i		: IN 	STD_LOGIC;
		Jalr_ctrl_i		: IN 	STD_LOGIC;
		alu_res_i 		: IN 	STD_LOGIC_VECTOR(DATA_BUS_WIDTH-1 DOWNTO 0);
		stall_i			: IN 	STD_LOGIC;	-- hold the current instruction (multicycle accelerator busy)

		--Inputs, interrupt service protocol (clause 6.v, page 15)
		int_pc_we_i		: IN 	STD_LOGIC;								-- load the PC from int_pc_i this cycle: protocol cycle 2, jalr to Mem[TYPE]
		int_pc_i		: IN 	STD_LOGIC_VECTOR(PC_WIDTH-1 DOWNTO 0);	-- the ISR entry address
		int_hold_i		: IN 	STD_LOGIC;								-- freeze the PC during the protocol; joins stall_i, does not replace it

		--Outputs
		pc_o 			: OUT	STD_LOGIC_VECTOR(PC_WIDTH-1 DOWNTO 0);
		pc_plus4_o 		: OUT	STD_LOGIC_VECTOR(PC_WIDTH-1 DOWNTO 0);
		instruction_o 	: OUT	STD_LOGIC_VECTOR(DATA_BUS_WIDTH-1 DOWNTO 0);

		-- The interrupt return address: what the PC would become next if the
		-- protocol were not running. Page 15 calls this "the next PC
		-- address" at the moment the service process begins - the value
		-- cycle 2 writes into tp so that "jalr zero, 0(tp)" resumes exactly
		-- where execution left off.
		int_ret_addr_o	: OUT	STD_LOGIC_VECTOR(PC_WIDTH-1 DOWNTO 0)
	);
END Ifetch;


ARCHITECTURE behavior OF Ifetch IS
	SIGNAL pc_q				: STD_LOGIC_VECTOR(PC_WIDTH-1 DOWNTO 0);
	SIGNAL pc_plus4_q		: STD_LOGIC_VECTOR(PC_WIDTH-1 DOWNTO 0);
	SIGNAL pc_plus4_r 		: STD_LOGIC_VECTOR(PC_WIDTH-1 DOWNTO 0);
	SIGNAL itcm_addr_w		: STD_LOGIC_VECTOR(ITCM_ADDR_WIDTH-1 DOWNTO 0);
	SIGNAL next_pc_w  		: STD_LOGIC_VECTOR(PC_WIDTH-1 DOWNTO 0);
	-- The ordinary, instruction-derived next PC (Jalr / taken branch or jal /
	-- PC+4), upstream of the interrupt override and the hold. See the note
	-- at int_ret_addr_o below.
	SIGNAL next_pc_normal_w	: STD_LOGIC_VECTOR(PC_WIDTH-1 DOWNTO 0);
	SIGNAL brTaken_w  		: STD_LOGIC;
	SIGNAL rst_q  			: STD_LOGIC;
	
BEGIN
	--=======================================
	-- ITCM (ROM) connection
	--=======================================
	inst_memory: altsyncram
	GENERIC MAP (
		operation_mode					=> "ROM",
		width_a 						=> DATA_BUS_WIDTH,
		widthad_a 						=> ITCM_ADDR_WIDTH,
		numwords_a 						=> WORDS_NUM,
		lpm_hint 						=> "ENABLE_RUNTIME_MOD = YES,INSTANCE_NAME = ITCM",
		lpm_type 						=> "altsyncram",
		outdata_reg_a 					=> "UNREGISTERED",
		init_file 						=> ITCM_INIT_FILE,
		intended_device_family			=> "Cyclone"
	)
	PORT MAP (
		clock0    	=> clk_i,
		address_a	=> itcm_addr_w, 
		q_a 	   	=> instruction_o 
	);
-------------------------------------------------------------------------------------
-- rst_i synchronization
-------------------------------------------------------------------------------------
PROCESS (clk_i, rst_i)
	BEGIN
		IF rst_i = '1' THEN
			rst_q <= '1';	-- preset
		ELSIF(clk_i'EVENT  AND clk_i='1') THEN
			rst_q <= rst_i;
		END IF;
END PROCESS;

-----------------------------------------------------------------------------------		
	-- Adder to execute PC+4
  pc_plus4_r(PC_WIDTH-1 DOWNTO 0)	<= next_pc_w(PC_WIDTH-1 DOWNTO 0) + 4;
	
-----------------------------------------------------------------------------------
	-- Decision MUX for the next PC value
	brTaken_w <= 	Branch_ctrl_i AND brTaken_i;
	
	-- The ordinary, instruction-derived next PC, unchanged from what this
	-- multiplexer already computed here - just factored under its own name
	-- so int_ret_addr_o can tap exactly this value below without
	-- duplicating the chain.
	next_pc_normal_w	<=	alu_res_i(PC_WIDTH-1 DOWNTO 0)		WHEN	Jalr_ctrl_i					ELSE	-- case of jalr
							addr_gen_i(PC_WIDTH-1 DOWNTO 0)	WHEN	brTaken_w or Jal_ctrl_i 	ELSE	-- case of Branch Taken or jal
							pc_plus4_q(PC_WIDTH-1 DOWNTO 0);												-- case of Branch Not-Taken

	-- Page 15: the interrupt service protocol is not an instruction, so no
	-- instruction-derived PC source may win over it - int_pc_we_i sits
	-- immediately after reset, ahead of the hold and every branch/jump/PC+4
	-- case. Above the hold is deliberate too: an explicit "load the PC now"
	-- from the control unit must never be silently swallowed by a hold flag.
	--
	-- Stalling re-drives the address of the instruction that is already being
	-- executed, so the ITCM re-reads it and pc_q keeps its value. pc_plus4_q
	-- follows automatically, since it is loaded with next_pc_w+4 every cycle.
	-- int_hold_i joins stall_i in the same condition rather than gating it
	-- separately, so a division in flight and an interrupt request each hold
	-- the PC on their own and neither can mask the other.
	next_pc_w	<=				(others => '0') 					WHEN	rst_q 								ELSE
								int_pc_i(PC_WIDTH-1 DOWNTO 0)		WHEN	int_pc_we_i = '1'					ELSE	-- protocol cycle 2: jalr to Mem[TYPE]
								pc_q(PC_WIDTH-1 DOWNTO 0)			WHEN	(stall_i = '1' OR int_hold_i = '1')	ELSE	-- accelerator stall OR interrupt-service hold
								next_pc_normal_w;																			-- ordinary instruction-derived next PC

	-- Deliberately next_pc_normal_w, not next_pc_w: the return address is
	-- what the PC would become next under ordinary control flow, captured
	-- before the interrupt override and before the hold can change it -
	-- exporting next_pc_w itself would return to the ISR entry address or
	-- to the frozen PC instead of to the instruction that was about to run.
	int_ret_addr_o <= next_pc_normal_w;
-----------------------------------------------------------------------------------
-- pc_plus4 register
-------------------------------------------------------------------------------------
PROCESS (clk_i, rst_i)
	BEGIN
		IF rst_i = '1' THEN
			pc_plus4_q(PC_WIDTH-1 DOWNTO 0) <= (OTHERS => '0') ; 
		ELSIF(clk_i'EVENT  AND clk_i='1') THEN
			pc_plus4_q(PC_WIDTH-1 DOWNTO 0) <= pc_plus4_r;	
		END IF;
END PROCESS;

-----------------------------------------------------------------------------------
-- pc register
-------------------------------------------------------------------------------------
PROCESS (clk_i, rst_i)
	BEGIN
		IF rst_i = '1' THEN
			pc_q(PC_WIDTH-1 DOWNTO 0) <= (OTHERS => '0') ; 
		ELSIF(clk_i'EVENT  AND clk_i='1') THEN
			pc_q(PC_WIDTH-1 DOWNTO 0) <= next_pc_w;	
		END IF;
END PROCESS;
-----------------------------------------------------------------------------------	
	-- send address to inst. memory address register
	G1: 
	if (WORD_GRANULARITY = True) generate 			-- i.e. each WORD has unike address
		itcm_addr_w <= next_pc_w(PC_WIDTH-1 DOWNTO 2);
	elsif (WORD_GRANULARITY = False) generate 	-- i.e. each BYTE has unike address
		itcm_addr_w <= next_pc_w;
	end generate;
---------------------------------------------------------------------------------------
	pc_o 		<= 	pc_q;
	pc_plus4_o	<= 	pc_plus4_q;	
---------------------------------------------------------------------------------------
	
END behavior;
