OriDagan1/RISCV-MCU-Final-Project/(commit log)

2026-08-02 Integrate the division accelerator into the RV32I core
    Wires the DIV_ACCEL coprocessor into the single-cycle core so div, divu,
    rem and remu execute in hardware.
    CONTROL decodes the four division instructions and emits DIVOp,
    DIVSigned and DIVRem. They are RTYPE, so RegWrite and ALUSrc
    already do the right thing and ALUOp falls through to ALU_NONE.
    EXECUTE the accelerator result joins the write-back bus alongside the
    ALU and the multiplier.
    IFETCH new stall_i re-drives pc_q, so the ITCM re-presents the same
    instruction and pc_plus4_q holds by itself.
    CORE instantiates div_accel, gates both write enables with the
    stall, and does t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
    [CONTROL.VHD, DMEMORY.VHD, EXECUTE.VHD, IFETCH.VHD, RV32I_CORE.vhd, aux_package.vhd, tb_RV32I.vhd]
2026-08-02 Report cycles-to-completion in run_benchmark.do
    Breakpoints on the 'finish: beq x0,x0,finish' self-loop and records
    mclk_cnt_o there, so the reported figure is the program's cycle count
    rather than however long the clock was left running. Gives the number
    the IPC table needs directly: 484 cycles for Final Project Tests
    RV32IM/test1, which is 131 instructions plus 16 divisions at 22 stall
    cycles each.
2026-08-02 Quieten the run scripts and print results in the transcript
    The transcript was ~200 lines of noise around four lines of result.
    - every bare 'set' echoes its value, so they are all 'quietly' now.
    The stray 'not reached' users saw was the initial value of
    FINISH_CYCLES being echoed, not the outcome
    - StdArithNoWarnings/NumericStdNoWarnings are set over the reset
    window, where everything is still 'U' and std_logic_arith warns on
    every operation, then switched back on so a genuine U/X during the
    program is still reported
    - compile.do uses 'file delete' instead of 'vdel -all'. vdel writes
    'Error 133: Unable to remove directory' directly to the transcript
    when t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
2026-08-02 Fix lui: the immediate never reached the ALU
    IDECODE selects the sign-extended immediate on opc_w, and the U-type
    branch is guarded by UTYPE_OPC. const_package defines that as
    "0010111" and "0110111" = "0010111"
    which is the opcode of auipc alone, so lui's "0110111" fell through to
    the "when others" branch and SignExt_o came out zero. Since the ALU
    sources ain from zero for lui (UpperIm_ctrl "10") and bin from the
    immediate, every lui wrote 0 to its destination register.
    Given its own choice in the select, matching the style already used for
    INST_JALR. UTYPE_OPC is left alone because CONTROL relies on it as a
    mask: "0110111" and "0010111" = UTYPE_OPC is what makes Utype_w, and so
    RegW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
    [IDECODE.VHD]
2026-08-02 Sprint 0: split the MCU top level out of the core
    Restructure only - the design behaves identically, but the seam between
    the two halves of the project now exists so both of us can work without
    editing the same files.
    New DUT/RV32IMscMCU/MCU.vhd is the top level and owns everything outside
    the CPU: clock generation, the DTCM, and the address decode. The core
    becomes a bus master that drives a byte address across the whole data
    address space of Figure 2 and takes read data back, without knowing
    which device answers.
    RV32I_CORE loses the DTCM and the clock divider. Takes mclk_i,
    divclk_i and dtcm_data_rd_i; drives dtcm_addr_o (now the
    full 14-bit byte address,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
2026-08-02 Delete PLL.vhd
    The ALTPLL it wrapped is a Cyclone II megafunction, unsupported on the
    Cyclone V of the DE10-Standard, and since Sprint 0 nothing instantiates
    it: MCU.vhd derives MCLK from clk_i with a toggle flip-flop. Nothing
    outside the file referenced it - not aux_package, not compile.do, and
    the Quartus project does not exist yet. G_PLL_DIV and G_PLL_MUL go with
    it, since PLL.vhd was their only reader.
    Recoverable from history if a real PLL is ever wanted; that would be an
    altera_pll instance in MCU.vhd rather than this file.
    Benchmark unchanged: 484 cycles, 1024/1024 words match the golden model.
    [MCU.vhd, aux_package.vhd, cond_compilation_package.vhd]
2026-08-02 Add README with the simulation flow and the GPIO hook points
    Aimed at picking up the project cold: the three commands that run a
    benchmark, what a good transcript looks like, and where the I/O block
    attaches in MCU.vhd - port list, write qualification, read mux - with
    the address map and the signals already in scope.
    Also records the traps that cost time this week: ModelSim cannot open
    the Hebrew project path, the image set has to match the TCM size or the
    data segment silently lands at word 1024, and the .hex golden reference
    for Final Project Tests RV32IM/test1 is stale where the .h is correct.
2026-08-04 Add the Basic Timer of Figure 7
    Five components, one per block of the figure, each in its own file so the
    counter is a standalone part rather than being buried inside the PWM logic:
    BT_CLKDIV BTSSEL select, SMCLK / 1,2,4,8
    BTCNT the 32-bit up-counter, nothing else
    BT_OUTPUT_UNIT both comparators, and the Fig.8 PWM modes
    BT_CAPTURE CAPISEL mux, edge detect, BTCAPR
    BASIC_TIMER structure only: BTCTL decode, BTCL latches, BTIFG mux
    Follows Fig.7 literally, including the run-time selectable clock feeding
    BTCNT rather than a clock enable. Two consequences are documented in
    BT_CLKDIV.vhd: the .sdc needs create_generated_clock on each divided clock
    with set_cloc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
2026-08-10 Generate MCLK, DIVCLK and SMCLK from three PLLs
    Per the professor's forum post, each clock gets its own PLL. All three are
    altera_pll (PLL Intel FPGA IP v21.1) from the 50 MHz board oscillator:
    MCLK 25 MHz CPU
    DIVCLK 200 MHz division accelerator
    SMCLK 25 MHz Basic Timer
    Not the ALTPLL that came with the project - that is a Cyclone II
    megafunction and the Cyclone V does not support it. LAB4 shipped an
    altera_pll, which is what this matches.
    MCU.vhd selects the clock source with the MODELSIM generic, which the
    professor had declared and threaded through every level without ever using
    it. MODELSIM=0 instantiates the IP, MODELSIM=1 generates the clocks
    behaviourally so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
    [MCU.vhd, PLL_DIVCLK.vhd, PLL_DIVCLK_pll_0.v, PLL_MCLK.vhd, PLL_MCLK_pll_0.v, PLL_SMCLK.vhd, PLL_SMCLK_pll_0.v, aux_package.vhd]
2026-08-10 Scope the docs to this branch: no timer here
    The Layout listing and the compile.do footer were written on feature/timer
    and carried over with the cherry-pick. The timer files are not on main, and
    compile.do still claimed there is no PLL, which stopped being true.
2026-08-10 Wire the GPIO into MCU.vhd
    The five GPIO sources landed as standalone files: nothing instantiated
    them, aux_package did not declare them and compile.do did not build
    them, so they were dead code and a break in them would have gone
    unnoticed.
    MCU.vhd now instantiates the decoder, PORT_LEDR, PORT_SW and three
    GPIO_HEX_Pair_Interface instances, and the read stub becomes the real
    path: the five read outputs are OR-ed into io_rdata_w - they are
    one-hot and each drives zeros when deselected, which is the wired-OR
    Figure 5 draws as tri-state - and io_sel_w then chooses between that
    and the DTCM. All ports are clocked by MCLK, capturing on its falling
    edge like the DTCM, so every target on the data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
2026-08-11 Put a BidirPin on every GPIO read path
    Figure 5 draws each peripheral reaching the data bus through a tri-state
    buffer. The integration approximated that with a wired-OR of the five read
    paths, which behaves identically but is not what the figure shows and does
    not use BidirPin.vhd, the buffer supplied with the project.
    Six BidirPin instances now share io_bus_w: one per device, enabled by its
    chip select AND bus_read_w, plus BUF_NONE which parks the bus at zero when
    no device is selected. Without BUF_NONE an unmapped I/O address would leave
    the bus floating at Z and propagate X into the register file; with it,
    unmapped I/O still reads as zero.
    Only the port -> CPU direction is wired, so ev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
2026-08-11 Add check_io_bus.do for the MCU-level I/O wiring
    The GPIO unit testbenches verify each port module in isolation; nothing verified the level above them, where the address decode, the six BidirPin buffers and the DTCM meet. This forces bus transactions on the master side so every case can be hit directly, including the unmapped addresses reserved for clause 6 that no program touches.
    18 checks, and io_bus_w is tested for X, Z and U after every transaction rather than only at chosen instants.
2026-08-11 Colour the wave windows from one shared palette
    The three run scripts each built their own uncoloured wave list, so every
    trace came out in the same default colour and the screenshots for the report
    were hard to read.
    wave_style.do now holds the palette and the two standard signal sets. The
    colours encode something rather than decorate: each peripheral has one
    signature colour carried through its chip select, its BidirPin output enable
    and its pin, so a transaction can be followed from the address decode to the
    board in a single glance. Writes are magenta, reads are green-yellow, the
    address bus is white, and io_bus_w is yellow. Within a display pair the low
    digit is saturated and the high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
2026-08-11 Print the measured test0 landmarks instead of zooming full
    zoom full on test0 frames 158 loop iterations at 1.28 us each, which renders as a solid smear. The script now ends zoomed to the first sixteen iterations and prints the store schedule plus four useful zoom ranges.
2026-08-11 Make the MCU synthesizable for the DE10-Standard
    Two things stopped this design reaching an FPGA.
    The top level presented 332 pins. 60 are real board I/O; the other 272 were
    observation outputs for verification. The board has nowhere to route them, the
    fitter would have had to place them anyway, and the Area table of clause 6
    would have reported 332 I/O instead of 60.
    Clause 7 asks for exactly this to be handled "using a suitable parameter in the
    generate VHDL statement", so there is now a SIGTAP generic, defaulting to
    G_SIGTAP = 0. Every observation port that is a vector has its range multiplied
    by it, so at 0 the range becomes (-1 downto 0) - a null array, no bits, no
    pins - and at 1 it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
2026-08-12 Drop DIVCLK to 100 MHz for the first FPGA validation run
    200 MHz was optimistic. A figure of around 130 MHz has been reported for this
    divider datapath, so the DIVCLK domain would very likely have failed timing on
    the board and the failure would have shown up as wrong division results rather
    than as anything obvious.
    100 MHz leaves a comfortable margin and keeps a clean 4:1 ratio with MCLK. The
    frequency buys nothing but speed - the golden model matches at every setting
    tested, so this is purely a performance trade:
    DIVCLK ratio benchmark cycles golden model
    200 MHz 8:1 276 matches
    150 MHz 6:1 292 matches
    100 MHz 4: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
    [MCU.vhd]
2026-08-12 Add gen_vcd.do for the Quartus Power Analyzer
    Clause 6 wants a Power table. Without switching activity the Power Analyzer assumes a default toggle rate, which is a guess; a .vcd from the real workload makes the dynamic figure defensible.
    Two workloads, because they are genuinely different: the RV32IM benchmark exercises the CPU, multiplier, divider and DTCM over its 276 cycles, while GPIO test0 hammers the memory-mapped writes and barely touches the divider. Only the reset-released window is recorded - reset transients and the finish self-loop would both skew the toggle rates.
    The dumps themselves are gitignored: megabytes, and a minute to regenerate.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
2026-08-12 Stop KEY0 from resetting the three PLLs
    rst_w was wired into every PLL rst_reset, so pressing KEY0 stopped MCLK,
    DIVCLK and SMCLK rather than just resetting the logic.
    Two consequences on the board. While the key is held there is no clock at
    all, so Signal-Tap cannot sample, evaluate its trigger or transfer over
    JTAG - the capture only lands on the press that happens to catch it. And
    on release rst_w drops immediately while the PLLs still need microseconds
    to relock, so the CPU runs on an unlocked, off-frequency clock and latches
    garbage before settling.
    Neither is visible on the LEDs, which is why the manual tests looked fine;
    Signal-Tap captures exactly that window and shows it.
    rst_res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
    [MCU.vhd]
2026-08-12 Add the report screenshots and the DE10-Standard manual
    Ten screenshots under DOC/Screenshots for the clause 6 and clause 10 report
    items: the Quartus Flow Summary, Fmax Summary, Power Summary and critical
    path, plus the ModelSim waveforms for the RV32IM benchmark and GPIO tests
    0, 1 and 2 in both count directions.
    The board manual comes with them because the design depends on it directly
    and repeatedly - the pin table in clause 7, the active-low pushbutton
    polarity behind the rst_w inversion, and the Figure 3-18 segment ordering
    that SevenSegmentEncoder.vhd implements. It is 7.6 MB, which is worth it
    to keep the source of those numbers next to the numbers.
    Also ignore *.bak: the submissio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
2026-08-16 Add the Signal-Tap captures for GPIO test0, test1 and test2
    Five captures off the DE10-Standard, all after df8335f stopped KEY0 from
    resetting the PLLs. Before that fix the acquisition clock died whenever the
    key was held, so a capture only landed on the press that happened to catch
    it - these are the first ones that acquire on a single press.
    test0 digits 0..F twice, LEDR 00h..1Ch, ~29 updates
    test1 sw0 0 -> 1, all six digits identical, LEDR 01h
    test1 sw1 0 -> -1, all six digits show F, LEDR FFh
    test2 sw0 HEX0 0 -> 1 while HEX1..HEX5 stay 0, LEDR 01h
    test2 sw1 all six digits show F, LEDR FFh
    test2 sw0 is the one that carries the clause 7 argume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
2026-08-16 Add the Quartus submission files: SDC, Signal-Tap and SOF
    The three files clause 8(d) and the submission structure require, built on
    the lab machine against main:
    RV32IMscMCU.sdc timing constraints - clause 8(d)
    RV32IMscMCU.stp Signal-Tap configuration - clause 7
    MCU.sof the bitstream, named after the Quartus revision
    The .sof is 6.7 MB. It is committed rather than ignored because the task
    lists it as a mandatory submission file, not because it is a build product
    worth versioning - regenerate it from the project rather than trusting an
    old copy if the HDL moves.
    Two things still to settle before submission:
    - The task wants these under Quartus/RV32IMscMCU/, holding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
    [RV32IMscMCU.stp]
2026-08-27 Wire PERIPH_AddressDecoder and GPIO_PB_Interface into MCU
    Adds PORT_PB (0x2014) and the clause-6 peripheral address decoder to
    the top level: KEY_i port, IODEC6/IOPB instances, the oe_pb_w tri-state
    buffer, and the matching component/testbench wiring in aux_package.vhd
    and tb_RV32I.vhd. check_io_bus.do now exercises the real PORT_PB read
    and the still-unmapped USART gap instead of asserting 0x2014 is unmapped.
    compile.do gains the two new DUT files and their unit testbenches so
    the whole design still elaborates.
    Verified in ModelSim: tb_GPIO_AddressDecoder, tb_PERIPH_AddressDecoder
    and tb_GPIO_PB_Interface all still pass unchanged; check_io_bus.do's 20
    checks pass with a valid DTCM/ITCM ini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
2026-08-27 Part 1: make tb_GPIO_PB_Interface terminate on its own
    The clock process was an unconditional WHILE TRUE LOOP, so run -all
    never returned and the testbench had to be killed by hand, which made
    it impossible to script as a regression. Replaced it with the
    sim_done-gated conditional concurrent clock assignment already used in
    tb_cdc_sync.vhd and tb_basic_timer.vhd, and set sim_done <= TRUE after
    the pass report, before the final WAIT.
    No check, stimulus, or timing changed. Verified with
    vsim -c work.tb_GPIO_PB_Interface -do "run -all; quit -f": all 12
    tests run, ALL GPIO_PB_Interface TESTS PASSED, Errors: 0, Warnings: 0,
    and the run now exits on its own.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
    [tb_GPIO_PB_Interface.vhd]
2026-08-27 Part 2: make SMCLK a synchronous branch of MCLK instead of a third PLL
    Figure 1 of the task definition draws a single Clock Tree block feeding
    mclk, accelclk and smclk from baseclk50MHz - not three PLLs - and
    nothing in the task definition requires MCLK and SMCLK to be
    asynchronous. The previous code put them on two independent 25 MHz
    PLLs with an undefined phase relationship, turning every register
    BASIC_TIMER_INTERFACE hands from the CPU to the timer into a real,
    unhandled clock domain crossing.
    MCU.vhd: removed the PLL_SMCLK component and U_PLL_SMCLK instance from
    CLK_FPGA, removed SMCLK_HALF and its toggle assignment from CLK_SIM,
    and added smclk_w <= mclk_w outside both generate branch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
2026-08-27 Part 3: add a single-cycle bt_irq_o pulse to basic_timer_interface
    btifg_o out of basic_timer is a level, not a pulse: in the default
    mode BTINT="00" it is equ0_w, high for one BTCLK period, which is 1,
    2, 4 or 8 MCLK periods depending on BTSSEL. GPIO_PB_Interface already
    hands the (future) interrupt controller one-MCLK-cycle pulses on
    key1_irq_o..key3_irq_o; a multi-cycle level from the timer would
    re-arm the moment a service routine cleared it and spin the CPU in
    interrupts forever.
    Added btifg_i (in) and bt_irq_o (out) to basic_timer_interface. One
    register samples btifg_i on rising_edge(clk_i) with asynchronous reset
    to '0'; bt_irq_o <= btifg_i AND NOT that register. Rising edge, not
    fa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
    [BASIC_TIMER_INTERFACE.vhd]
2026-08-27 Part 4: instantiate the Basic Timer in MCU.vhd
    Wires basic_timer_interface and basic_timer into the top level,
    completing clause 6's register block (0x201C-0x2028) alongside the
    PERIPH_AddressDecoder chip selects that have been sitting unconsumed
    since the PORT_PB integration.
    MCU.vhd: added PWMout_o/CAPIN1_i/CAPIN2_i on the clause 4 expansion
    header (no dedicated board pins for these); the eight new BT signals
    (btctl1_w, btctl2_w, btcmpr0_w, btcmpr1_w, btcapr_w, btcnt_w, btifg_w,
    bt_irq_w, rd_bt_w, oe_bt_w); BTIF: basic_timer_interface, wired to the
    cs_btctl_w/cs_btcmpr0_w/cs_btcmpr1_w/cs_btcapr_w signals IODEC6 already
    drove, sel_i => bus_addr_w(0) as the HEX pairs use it, rst_i => rst_w;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
2026-08-27 Add int_ctrl, wire it into compile.do, fix two testbench-run defects
    DUT/RV32IMscMCU/INT_CTRL.vhd and TB/RV32IMscMCU/tb_int_ctrl.vhd were new,
    never-compiled files. Added INT_CTRL.vhd to compile.do after
    BASIC_TIMER_INTERFACE.vhd and tb_int_ctrl.vhd with the other unit
    testbenches. No aux_package.vhd component: int_ctrl has no
    USE work.aux_package clause and the testbench instantiates it with
    entity work.int_ctrl; a component declaration belongs to the later step
    where MCU.vhd instantiates it.
    First compile-and-run turned up two defects, diagnosed with waveform
    evidence:
    1. tb_int_ctrl.vhd, T7 "all six sources at once": the block drove all
    six src_w bits inline instead of through pulse/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
    [INT_CTRL.vhd, tb_int_ctrl.vhd]
2026-08-27 Instantiate int_ctrl in MCU.vhd, CPU protocol tied off for now
    Wires the Basic Interrupt Controller (clause 6.v) into the top level:
    IE, IFG and TYPE become addressable at 0x202C-0x202E. The CPU side of
    the service protocol does not exist yet - RV32I_CORE.vhd has no
    interrupt ports and CONTROL.VHD is still purely combinational, that is
    the next task - so gie_i and inta_n_i are tied off here in a way that
    is behaviourally inert: gie_w='0' keeps intr_o from ever rising
    (intr_o <= gie_i WHEN ifg_w /= 0 ELSE '0'), and inta_n_w='1' means
    cycle1_w is never true, so int_ctrl never enters a service cycle and
    bus_drive_o reduces to its ordinary cs_i AND MemRead_ctrl_i term. The
    design is behaviourall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
2026-08-27 Interrupt protocol step 1/4: hardware write port in IDECODE.VHD
    Adds the register-file connection points the service protocol of
    clause 6.v, page 15 needs, with the new inputs tied inactive. This
    task adds no behaviour - the state machine that drives them arrives in
    step 3 (CONTROL.VHD), and the fetch-suppression side lands in step 2
    (IFETCH.VHD). Splitting the four-file change into four commits is
    deliberate: if all of it landed at once and the benchmark cycle count
    moved, there would be no way to tell which file broke the datapath.
    IDECODE.VHD: three new inputs (int_rf_we_i, int_rf_rd_i, int_rf_data_i)
    and one new output (gp_o). The hardware write port overrides the
    instruction write-back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
    [IDECODE.VHD, RV32I_CORE.vhd, aux_package.vhd]
2026-08-27 Interrupt protocol step 2/4: PC injection and hold in IFETCH.VHD
    Adds, to IFETCH.VHD only, the three connection points the fetch stage
    needs for the clause 6.v (page 15) interrupt service protocol. This
    step adds ports and wiring only - the control unit that drives them
    arrives in step 3. No behaviour change is intended or observed.
    - int_pc_we_i / int_pc_i: a new PC source placed immediately after
    rst_q in the next_pc_w priority chain, above the stall/hold branch
    and above Jalr/branch/PC+4. Protocol cycle 2 emulates a jalr to
    Mem[TYPE], which must override every instruction-derived PC source;
    reset stays the only thing that outranks it.
    - int_hold_i: OR'd into the existing stall_i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
    [IFETCH.VHD, RV32I_CORE.vhd, aux_package.vhd]
2026-08-27 Interrupt protocol step 3/4: the service state machine in CONTROL.VHD
    CONTROL.VHD gains a three-state Moore machine (S_IDLE, S_CYCLE1, S_CYCLE2)
    that drives every port steps 1 and 2 tied inactive, plus reti detection.
    The pre-existing combinational decoder is untouched and still depends only
    on instruction_i, never on the new state - which is what keeps the
    benchmark at 134 cycles while gie_w stays tied to '0' in MCU.vhd: the
    machine exists and is reachable, but the only path in (intr_i) is held low
    until step 4 connects it.
    State machine, rising edge (matching pc_q, the register file and
    mclk_cnt_q elsewhere in the core):
    - S_IDLE -> S_CYCLE1 when intr_i='1' AND div_busy_i='0' at the sam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
2026-08-27 Interrupt protocol step 4/4: close the loop in MCU.vhd
    Replaces the gie_w/inta_n_w tie-offs with the real connections: CORE's
    gie_o and inta_n_o now drive INTC's gie_i and inta_n_i, and INTC's intr_o
    (already on intr_w) drives CORE's intr_i. The interrupt system is reachable
    for the first time - INTR can genuinely rise, and the service machine in
    CONTROL.VHD can genuinely be entered.
    The tie-off comment is rewritten to explain what still holds every
    interrupt off by default: the register file resets to all zero (IDECODE.
    VHD), so gp[0] - GIE - is '0' out of reset, and intr_o <= gie_i WHEN
    ifg_w /= 0 ELSE '0' in int_ctrl means INTR cannot rise until software
    explicitly sets it. No existing b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
    [MCU.vhd, RV32I_CORE.vhd, aux_package.vhd]
2026-08-28 Document where Fig.9's DIVRST function lives (forum rows 3 and 6)
    Forum rows 3 and 6 define DIVRST as an internal, per-division line that
    initialises the divider core's registers - the Quotient register and the
    {Residue,Dividend} shift register holding the Dividend and Divisor - and
    state that it happens for every div and rem instruction. Row 6 answers
    "is the divider's reset the same as the system reset?" with: no, it is
    this internal load.
    Our RTL performs exactly that initialisation, once per div/divu/rem/remu,
    in the start_w load branch of DIV.vhd (shreg_q <= ZEROS & Dividend,
    divisor_q <= Divisor, quotient_q <= 0, step_cnt_q <= N), driven off the
    DIVENA edge that DIV_ACCEL raises once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
    [DIV.vhd, DIV_ACCEL.vhd]
2026-08-28 PORT_PB: KEY1-KEY3 into bits 0-2 (forum row 24)
    Forum row 24: "the assignment follows the order KEY1-KEY3 into bits 0-2
    respectively. KEY0 is not included, since it is the interface for the
    system RESET operation."
    GPIO_PB_Interface put KEY3..KEY1 in bits 3..1 with bit 0 reading zero.
    Its own header said that layout was a choice, not a requirement - "if a
    later specification or an application from the lecturer fixes a different
    layout, this is the only place that has to change". Row 24 is that
    specification, so this is that change.
    NOT to be confused with the IFG key-flag positions, which are a different
    register and are deliberately left alone: INT_CTRL keeps KEY1IFG at bit 3,
    KEY2IFG at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
    [GPIO_PB_Interface.vhd, tb_GPIO_PB_Interface.vhd]
2026-08-28 IFG: a store writes the value, not write-one-to-clear (forum rows 20, 23)
    Forum row 23 says to verify against what the reference applications
    actually do. Doing that turns row 20 - "would the post-reset compare state
    cause a spurious interrupt request?", answered with "every application
    begins by initialising the control lines, then clears all the interrupt
    flags, and only then locally enables the interrupts" - into a blocking
    defect in this file.
    INT_CTRL implemented write-one-to-clear. The lecturer's applications need
    the opposite. Every ISR in Interrupt-based IO test1, test2 and test3
    clears its flag like this:
    li t2,IFG
    lw t3,0(t2) # read IFG
    li t5,KEY1IFG_MA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
    [INT_CTRL.vhd, tb_int_ctrl.vhd]
2026-08-28 Restore PLL_SMCLK: three PLL instances (forum rows 8, 13, 15, 16)
    Reverses the clock decision of 40daf7d. That commit removed PLL_SMCLK and
    drove smclk_w from mclk_w, arguing that Figure 1 draws one Clock Tree block
    rather than three PLLs and that two 25 MHz PLLs with an undefined phase
    relationship turned every CPU-to-timer register path into an unhandled
    crossing. Four forum answers overturn it:
    - row 13, asked whether the three clocks come from one PLL instance:
    "No - from three different instances of the PLL module"
    - row 8: "DIVCLK is connected to the output of a separate PLL. The input
    clock of each of the three PLLs is the 50MHz base clock"
    - row 16: the separation exists for tim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
    [MCU.vhd, PLL_SMCLK.vhd, PLL_SMCLK_pll_0.v]
2026-08-28 Correct what the SMCLK/MCLK assert claims to enforce (audit finding, row 15)
    The Part 1 audit found that this file's header claimed the ASSERT enforced
    something it does not. The header said the no-crossing-hardware argument
    rested on "SMCLK is MCLK" - the same physical net - and that the assert was
    the guard rail on that. It is not: the assert compares G_SMCLK_MHZ against
    G_MCLK_MHZ, two constants, and passes just as happily when SMCLK is its own
    PLL output at the same frequency. After the previous commit restored
    PLL_SMCLK that is exactly the situation, so the misdescription would now be
    actively misleading.
    The check itself is correct and unchanged. Under the restored three-PLL
    architect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
    [BASIC_TIMER_INTERFACE.vhd]
2026-08-28 Replace the hard-coded init-file paths with repo-relative ones (audit finding)
    MCU.vhd, RV32I_CORE.vhd, IFETCH.VHD, DMEMORY.VHD, aux_package.vhd and
    tb_RV32I.vhd all defaulted ITCM_INIT_FILE / DTCM_INIT_FILE to absolute
    paths under one developer's home directory. run_benchmark.do overrides
    them, so the damage was invisible there - but check_io_bus.do does not
    override anything, because it drives the bus by hand and runs no program.
    On any other machine altsyncram could not open the file, aborted the
    simulation at time 0, and the script then reported 78 failures with every
    signal reading U or X. Reproduced here before the fix; the fatal is
    "(vsim-7) Failed to open VHDL file ... in rb mode" ou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
    [DMEMORY.VHD, IFETCH.VHD, MCU.vhd, RV32I_CORE.vhd, aux_package.vhd, cond_compilation_package.vhd, tb_RV32I.vhd]
2026-08-28 Point run_benchmark.do at the canonical test1: the baseline is 276 (audit finding)
    run_benchmark.do has reported 134 cycles throughout this project. The Part 1
    audit traced that figure to an old copy of test1 sitting on one developer's
    machine - an add/mul/xor version with no division in it at all. It was never
    a meaningful baseline for an RV32IM core: it never once exercised the
    divider that is the whole point of the accelerator.
    APP now points at the canonical RV32IM test1, relative to SIM/RV32IMscMCU,
    in the lecturer's own benchmark archive. It is the application README.md
    documents and the one whose output/RARS/DTCM.h is the golden model the
    script already diffs against.
    FROM HERE ON T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
2026-08-28 tb_GPIO_PB_Interface: gate the pass banner on an error count (audit finding)
    This testbench printed "ALL GPIO_PB_Interface TESTS PASSED" unconditionally.
    Its 51 checks were bare ASSERT ... SEVERITY ERROR statements that nothing
    counted, so a failure showed up only in ModelSim's own "Errors: N" summary
    line, which is easy to miss and absent from a copied transcript. The Part 2
    audit hit this for real: after the PORT_PB bit layout changed, two
    expectations went stale, ModelSim said "Errors: 2", and the testbench still
    declared PASSED.
    Every one of the 51 assertions now goes through a check(cond, msg)
    procedure that counts executions and failures, and the tail prints the
    "checks run" / "failur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
    [tb_GPIO_PB_Interface.vhd]
2026-08-28 README: the benchmark path is relative now (follows the path and baseline fixes)
    The "Switching benchmark" section still told the reader to put an absolute
    path into run_benchmark.do, which is exactly the habit the two preceding
    commits removed. It now shows the relative form, says what the paths are
    relative to and why, names the 276-cycle default, and points at the other
    three places that carry a benchmark path - APPROOT in gen_vcd.do and
    run_gpio.do, and G_ITCM_INIT_FILE / G_DTCM_INIT_FILE in
    cond_compilation_package.vhd, which are what check_io_bus.do runs on.
    Only the section this round's changes made wrong. Other staleness in this
    file is left alone and reported instead - see the task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
2026-08-28 BTCAPR is readable and writable (forum row 25, reset per row 21)
    Forum row 25: "All of the timer's interface registers are readable and
    writable, except the four high bits of BTCTL2, which are read-only."
    BASIC_TIMER_INTERFACE treated BTCAPR as read-only, passing btcapr_i straight
    through to the read multiplexer, and its header recorded that as a deliberate
    choice made when page 7's register table (every BTCAPR bit "rw") and Fig.7
    (no write path drawn) appeared to contradict each other. This answer resolves
    it in favour of the table.
    BTCAPR is now a real register with TWO load sources: the bus on a store, and
    the timer on a capture. The second is why this touches the lab partner's file.
    BA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
    [BASIC_TIMER.vhd, BASIC_TIMER_INTERFACE.vhd, MCU.vhd, aux_package.vhd]
2026-08-28 Rename Tb_basic_timer_interface.vhd to lower-case tb_ (case-sensitivity fix)
    compile.do line 73 asks for $TB/tb_basic_timer_interface.vhd, but the file was
    tracked as Tb_basic_timer_interface.vhd with a capital T. On Windows and macOS
    the filesystem is case-insensitive and the mismatch is invisible; on Linux git
    checks out the capital-T name, vcom cannot find the lower-case one, and
    compile.do fails outright. The project definition makes a clean ModelSim and
    Quartus build a condition of submission and the grader may not be on Windows.
    It had already caused one real problem rather than a theoretical one: during
    the BTCAPR work a "git add TB/RV32IMscMCU/tb_basic_timer_interface.vhd"
    silently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
    [tb_basic_timer_interface.vhd]
2026-08-29 fix(timer): align capture event with BTCAPR data
    [BASIC_TIMER.vhd]
2026-08-29 DOC: interrupt validation on the DE10-Standard, with Signal-Tap captures
    Nine screenshots from the first FPGA validation session of the interrupt
    system: the Signal-Tap setup, the Node Finder hierarchy, and the captured
    service protocol.
    The service capture confirms on real hardware what tb_int_service and
    tb_int_ctrl showed in simulation:
    - INTA falls exactly one cycle after INTR rises, not the same cycle
    - int_state_q walks S_IDLE -> S_CYCLE1 -> S_CYCLE2 -> S_IDLE, once
    - irq_q reads 04h before the key press: BTIFG latched at reset, but
    masked by ie_q=38h so it raises nothing, which is the IE-masking
    reading of the figure working on hardware
    - the KEY1 vector is serviced with that BT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
2026-08-29 DOC: add the test4 timer captures to the interrupt validation doc
    Five more Signal-Tap screenshots, 9 -> 14, covering the Basic Timer modes
    of Interrupt-based IO test4 on the DE10-Standard.
    The input-capture capture is the one worth reading: btcapr_q reads
    000000CFh, so div_arrays over ten elements takes 207 BTCLK counts - 8.28us
    at 25 MHz, about 20.7 cycles per element, which matches ten instructions
    plus the divider's stall. Alongside it btctl2_o flips 07h to 06h (CAPISEL
    GND to VCC, the internal edge the capture triggers on), btcl0_q reads
    FFFFFFFFh for full-scale counting, and capevt_q pulses in the same window
    btcapr_q updates.
    That last point matters: it is 1b697be working. Before th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
2026-08-30 DOC: add the RTL Viewer captures to the validation doc
    Seven more screenshots, 14 -> 21, in a new "RTL Viewer:" section at the end:
    MCU, Interrupt controller, CPU, Divider Accelerator, Dividing module, GPIO
    and Basic Timer.
    Purely additive - nothing in the existing interrupt and Basic Timer sections
    changed.
    Claude-Session: https://claude.ai/code/session_01LNXnoTSLSu9XFxmLWbQsDV
2026-08-30 QUARTUS: add pins.tcl, the DE10-Standard pin assignments as a script
    71 set_location_assignment lines covering every top-level port of MCU.vhd:
    clk_i and rst_i, SW_i[7..0], KEY_i[3..1], LEDR_o[7..0], the six HEX displays,
    and the five std_logic observation outputs that survive G_SIGTAP=0 because
    std_logic has no null form. Pin numbers are from tables 3-5 to 3-11 of the
    board manual.
    Also sets 3.3-V LVTTL on every pin and reserves unused pins as input
    tri-stated, which matters on this board: the expansion header, HPS DDR3 and
    the audio and video codecs are all physically wired to something, and the
    Cyclone V default of driving unused pins to ground would fight them.
    Run Analysis & Elaborati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
